fh9g12/HastaArduino/docs/README.md

# HastaArduino

Bench- and wind-tunnel instrumentation for a free-to-pitch / control-surface aircraft model: firmware for one board, the **Pimoroni Pico Plus 2** (RP2350B, no on-board radio) with a **Pimoroni RM2 WiFi/BT breakout on its SP/CE connector**, plus the MATLAB package that drives it. Every rig follows one shape: an Arduino sketch exposes an **SCPI-over-TCP instrument interface**; MATLAB drives it, pulls back binary sample data, and plots.

This file is for a future human or agent picking the repo up cold. It describes **architecture, conventions and traps**, not project-by-project detail. The `.ino` header comments and the doc comments on the MATLAB classes are the detailed, kept-current reference; read those for specifics.

> **Read [Rules for agents](#rules-for-agents-and-safety) before running or changing anything.** This code moves real control surfaces and writes state into the user's MATLAB.

## Contents

1. [Quick start (new machine)](#quick-start-new-machine)
2. [Repo layout](#repo-layout)
3. [How the pieces fit](#how-the-pieces-fit)
4. [Firmware](#firmware): HastaDAQ, wire protocol, HastaDrivers, other rigs
5. [MATLAB](#matlab): package map, client, data model, saved state, scripts
6. [Typical test session](#typical-test-session)
7. [Coding conventions](#coding-conventions): firmware and MATLAB
8. [Testing and verification without hardware](#testing-and-verification-without-hardware)
9. [Rules for agents and safety](#rules-for-agents-and-safety)
10. [Gotchas](#gotchas)
11. [Schematics, wiring, library management](#schematics-wiring-and-library-management) (taking them to a PCB layout: [PCB_BRIEF.md](PCB_BRIEF.md) for the main board, [PCB_BRIEF_GAUGE.md](PCB_BRIEF_GAUGE.md) for the strain-gauge board; parts still to choose: [PARTS_TO_SELECT.md](PARTS_TO_SELECT.md))
12. [Open items and unverified assumptions](#open-items-and-unverified-assumptions)

## Quick start (new machine)

1. **WiFi credentials:** copy `HastaDrivers/src/secrets.h.example` to `secrets.h` (gitignored) and fill in `WIFI_SSID` / `WIFI_PASS`.
2. **Toolchain:** run `setup-arduino-deps.ps1` (uses `arduino-cli` and installs exactly what `arduino-deps.txt` pins, into the real Arduino sketchbook, which is under OneDrive here).
3. **Build and flash `HastaDAQ`** with Visual Studio + the Visual Micro extension (the shared `HastaDrivers` include path only exists there), or check that it compiles from a shell, run from the repo root:
   ```
   arduino-cli compile --fqbn rp2040:rp2040:pimoroni_pico_plus_2 --build-property "build.extra_flags=-I<repo>/HastaDrivers/src" --build-property "compiler.cpp.extra_flags=-I<repo>/HastaDrivers/src" HastaDAQ
   ```
   The extra `-I` is needed because plain `arduino-cli` doesn't know about the Visual Micro shared-items project. (Board target: see [open items](#open-items-and-unverified-assumptions).)
4. **Find the board's IP** in the Serial Monitor at boot (`[WiFi] Connected, IP=...`). The scripts hard-code it near the top (`HastaIP` / `boardIP`); edit it there.
5. **MATLAB:** put `matlab/hastadaq` on the path (it holds the `+wt` and `+scripts` packages). The tunnel computer interface (`wt.OHBControl`, `wt.OHBData`) comes from the separate **WtControl toolbox**, which is *not* in this repo and merges into the same `wt` package name.
6. **First-time calibration:** with the model at its zero position, run `scripts.ZeroEncoderRun` once (see [encoder zero](#saved-state-matlab-preferences)).

## Repo layout

```
HastaDAQ/               Flagship firmware for the ORIGINAL board: HastaDAQ.ino + sketch-local headers (ChannelMixer, Sensors, CaptureManager)
HastaDAQ_v2/            Firmware for the REV A board (copy of HastaDAQ + EncoderPorts.h, soft stop, inverted triggers); see the HastaDAQ_v2 section
HastaDrivers/           Shared driver library (Visual Micro "shared items" project); src/ is on every sketch's include path
SbusServoCalibration/   Older rigs, one folder per sketch, folder name == .ino name (Arduino requirement)
EncoderCalibration/
StrainGaugeCalibration/
matlab/hastadaq/        THE MATLAB package for HastaDAQ: +wt/+hasta, +wt/+runNum, +scripts, controlStepResponseTest.m
matlab/common/          MATLAB helpers for the older rigs (TCP connect, binary parsers, FFT/Bode plots)
matlab/sbus|stepper|straingauge/   Per-rig MATLAB scripts for the older rigs
kicad/hastadaq/         KiCad schematic for the main HastaDAQ board (primary electrical reference)
kicad/gaugeboard/       KiCad schematic for the separate strain-gauge board (2 x ADS122C04, own 3.3 V regulator)
kicad/tools/            Bootstrap generators for both schematics (schgen_common.py = shared helpers) and the module-footprint generator
kicad/tools/layout/     Layout, routing, silkscreen and fab-export scripts (export_fab.py is reusable for any board; see its README)
kicad/releases/         Frozen publish.py snapshots; the gauge board's laid-out .kicad_pcb and its PCBWay fab files live here
kicad/README.md         KiCad workflow, tools, gotchas, status and hand-off notes: read this before laying out the next board
wiring/                 WireViz cable-level diagrams (secondary; partly stale, see open items)
                        (gauge-loom.yml is current: the 4-wire loom between the main board and the gauge board)
docs/                   This file
arduino-deps.txt        Pinned core + library versions (source of truth)
setup-arduino-deps.ps1  Installs what arduino-deps.txt pins
HastaArduino.slnx       Visual Studio solution (Visual Micro) referencing the active projects
```

`data/` (captured results) and the Visual Micro build files are **not source**; see [Rules for agents](#rules-for-agents-and-safety).

## How the pieces fit

```
  tunnel computer                         MATLAB (matlab/hastadaq)                       Pico Plus 2 + RM2 (HastaDAQ/)
 +-----------------+   wt.OHBControl    +------------------------------+   TCP :5025   +-----------------------------+
 | OHB server      |<------------------>| scripts.*  (tests, save data)|   SCPI text   | HastaDAQ.ino  SCPI handlers |
 | (force balance, |  external toolbox  | wt.hasta.examples.* (demos)  |<------------->|   setup()/loop(), non-blocking|
 |  incidence,wind)|                    | wt.hasta.DaqClient (handle)  |  UDP stream   | ChannelMixer -> SBUS servos |
 +-----------------+                    | wt.hasta.DaqData/MetaData/...|<--(optional)--| Sensors: MT6835, 2xADS122C04|
                                        | wt.runNum, encoderZero (prefs)|              |          ICM20649 IMU       |
                                        +------------------------------+               | PID, ExcitationGenerator,   |
                                                                                        | TriggerIO, CaptureManager   |
                                                                                        +-----------------------------+
```

* **One instrument, one client.** The board serves one TCP client at a time; a new connection always replaces the old one (last wins).
* **The board is the real-time part; MATLAB is orchestration.** SBUS output, the pitch controller, excitation and capture all run on the board and keep running if MATLAB stalls. MATLAB sets state, triggers, and reads data back.
* **All angles are degrees, centred on 0** (see [servo mapping](#servo-angle-convention)).

## Firmware

### HastaDAQ (flagship)

Five SBUS control surfaces (rudder, 2 elevators, 2 ailerons), an MT6835 pitch encoder with a closed-loop elevator controller, two ADS122C04 ADCs (half-bridge strain gauges) and an ICM20649 IMU on one Qwiic chain, external trigger in/out for syncing with other instruments, SCPI control, and optional continuous UDP streaming.

Every other rig in the repo blocks the whole sketch for a run's duration. HastaDAQ **cannot**: it flies real control surfaces, so SBUS output and the controller must never stop, even mid-capture. It is fully non-blocking: every `loop()` iteration services SCPI, polls the trigger pin, refreshes all sensors, advances the excitation / controller / capture / UDP state machines, and re-sends the SBUS frame. `RUN`/`ARM`/`FIRE` only flip state; they never wait. Use `HastaDAQ.ino` (not the older rigs) as the template for anything with an always-on real-time duty.

`HastaDAQ.ino` is the SCPI handlers plus `setup()`/`loop()`. The logic lives in sketch-local header-only classes included directly (Arduino doesn't auto-build extra `.cpp` files, so header-only was the simple, safe split):

| File | Role |
|---|---|
| `ChannelMixer.h` | `CHANNEL_DEFS[]` (**the one place to rename a servo or move it to another SBUS channel**), per-channel trim / excitation gain / control gain, the `SbusServoBank`, and the `ChanUpdate` struct |
| `Sensors.h` | `SensorHub`: encoder, both ADCs, IMU, all cached and refreshed non-blocking each loop |
| `CaptureManager.h` | `HastaDaqSample` (the 68-byte wire struct), bounded-capture state machine, `UdpStreamer` |

Shared from `HastaDrivers`: `PidController`, `ExcitationGenerator`, `TriggerIO`, `Mt6835Encoder`, `SbusServoBank` and the waveform generators.

**Signal flow, per servo channel, every SBUS frame:**

```
commandedDeg[ch] = trimDeg[ch] + excGain[ch]*excitation(t) + ctrlGain[ch]*controlOutput
```

One shared excitation waveform (sine / 1-cosine / chirp) and one shared PID (error = target - encoder angle) are mixed into each channel by gains in `[-1, +1]`: `0` excludes a channel, equal signs are symmetric, opposite signs differential. The PID runs every loop on its own measured `dt`; there is no separate control rate, just Kp/Ki/Kd. The controller has basic clamped-integration anti-windup (the integral freezes while the output is saturated) and the output is hard-limited to `outLimitDeg`.

**Triggering.** `RUN` = `ARM` (configure a bounded capture) + an immediate internal trigger. `ARM` alone waits for `FIRE` or an edge on the trigger-in pin. Every trigger also pulses trigger-out. Excitation has an **armed vs active** split: `armed` is sticky ("the next trigger should start this"), a trigger turns armed into active after `delayS`, and a bounded excitation (`cycles > 0`) stops itself but **stays armed**, so the next trigger starts it again. Disarm it when done.

#### Servo angle convention

* All angles are **degrees from centre, +/-48.06 deg**. `SbusServoBank` maps them linearly: 1520 us centre = SBUS 1024, 920 / 2120 us = SBUS 64 / 1984 (servos programmed through the Futaba CIU-3 for those end-points).
* Anything commanded past +/-48.06 deg is clamped, and the logged servo angle is the **clamped** value actually sent.
* `chMin` / `chMax` are a per-channel clamp on the raw SBUS count (64..1984), not the angle scale.
* The count-to-microsecond factor (0.625 us per count, Futaba S.BUS convention) is an **unverified assumption**; check that +/-48 deg reaches the servo end-points.

#### Encoder zero

The MT6835 is an **absolute single-turn** encoder, so its raw 0-360 deg reading is the same after every power cycle. The zero the firmware applies is a **software offset held in RAM** (lost on reboot or reflash). It can be described by one number, the raw angle that reads as 0: read it with `ZEROOFFSET?` after `ZERO`, keep it on the PC, and re-apply it with `ZEROOFFSET <deg>` after any restart. Valid only while the encoder and magnet haven't moved relative to the model. Both `ZERO` and `ZEROOFFSET` are refused while the controller is enabled (they would step the PID error).

#### Link handling (WiFi)

* A new SCPI connection **always replaces** the current one; each connection gets `setNoDelay(true)` (replies go out at once) and TCP keepalive (`keepAlive(5, 2, 3)`: intended to notice a dead peer in ~11 s and to stop idle gaps letting the link go quiet). That the keepalive actually takes effect in this build has **not been verified on hardware**.
* The WiFi link is **watched and logged only**; there is deliberately **no automatic re-join**, because `WiFi.begin` blocks and would pause SBUS for seconds. Do not add a blocking reconnect to `loop()`.
* `SYS?` reports uptime (a small value means it rebooted), reset reason (e.g. brownout), WiFi state and RSSI, free heap, connect/disconnect/WiFi-drop counts and the longest `loop()` since last asked. The Serial Monitor logs timestamped connects, disconnects and WiFi changes. These exist to diagnose intermittent "no reply" problems; see [open items](#open-items-and-unverified-assumptions).
* The core already disables WiFi low-power mode after `begin()`, so power-save is not the cause of latency spikes.

### Wire protocol (HastaDAQ)

Newline-terminated ASCII over TCP port 5025; replies end in CRLF (trim them). Setters apply only the fields you send and keep everything else. **Commands that carry a JSON body read it as a second raw line** (the parser splits on commas, so JSON can't be a normal SCPI parameter). Replies are `OK`, a value/JSON line, or `ERR <reason>`.

| Command | Body / reply |
|---|---|
| `*IDN?` | identification string |
| `CHANCONFIG` | JSON object **or array of objects**: `channel` (index 0-4 or a `CHANNEL_DEFS` name), `excGain`, `ctrlGain` (-1..1), `trimDeg`, `chMin`, `chMax`. An array is validated first and then applied **together**, so surfaces start moving in the same SBUS frame; older firmware only accepts one object |
| `CHANCONFIG? <ch>` | JSON of that channel |
| `EXCITE` / `EXCITE?` | `type` (`sine`/`cosine`/`chirp`/`step`/`random`/`stepseq`), `freqHz`, `f0`, `f1`, `periodS`, `amplitudeDeg`, `cycles` (0 = until disarmed), `delayS`, `startOffsetS` + `durationS` (`random`: the slice of the stored turbulence record to play, must fit in 59.98 s else `ERR`), `dwells` (`stepseq`: up to 16 multiples of `periodS`), `armed`; the query adds read-only `active` |
| `CTRLCONFIG` / `CTRLCONFIG?` | `kp`, `ki`, `kd`, `targetDeg`, `outLimitDeg`, `enabled` |
| `RUN` / `ARM` | `{durationS, sampleHz}`; `RUN` arms and triggers at once and replies `OK` immediately |
| `FIRE` | software trigger (errors if nothing armed) |
| `STATUS?` | `ARMED` / `CAPTURING <elapsed>/<duration>` / `DONE <n>` (`DONE` is also the idle state) |
| `DATA?` | header line `BIN <n> <bytesPerSample>` then `n` raw little-endian `HastaDaqSample` records |
| `ENCODER?` | current encoder angle (deg), plain number |
| `ZERO` | software-zero the encoder here |
| `ZEROOFFSET?` / `ZEROOFFSET <deg>` | read / re-apply the saved raw-angle zero |
| `SYS?` | link-health JSON (above) |
| `TRIGCONFIG` / `?` | `outPulseMs`, `inEdge` (`rising`/`falling`) |
| `UDPCONFIG` / `?` | `ip`, `port`, `rateHz`, `enabled` (continuous stream, same record layout as `DATA?`) |

**Sample layout (68 bytes, `static_assert`ed):** `uint32 t_us`, then 16 floats: ADC1 mV, ADC2 mV, encoder deg, accel x/y/z, gyro x/y/z, excitation deg, controller output deg (11 floats), then **5 servo angles in `CHANNEL_DEFS` order** (rudder, elev R, elev L, ail R, ail L). `wt.hasta.DaqData.FromBytes` and `wt.hasta.HDCh` mirror this; change all three together.

Registered commands must stay below `SCPI_MAX_COMMANDS` (32; 21 are registered now) and the library needs `SCPI_HASH_TYPE uint16_t` (see [gotchas](#gotchas)).

### HastaDAQ_v2 (REV A board)

`HastaDAQ_v2/` is a copy of `HastaDAQ/` updated for the REV A schematic, kept as a separate Visual Micro project (own `.vcxproj`, in the solution) so the original board and firmware stay untouched; it shares `HastaDrivers`. The drivers were only extended backward-compatibly (the original sketch still compiles, checked). It **compiles** (arduino-cli, `rp2040:rp2040:pimoroni_pico_plus_2w`: 407 KB flash, RAM 60 %), but **nothing here has run on hardware yet**.

What differs from `HastaDAQ`:

* **Encoders:** five ports. ENC1..ENC3 are SPI ports on one shared SPI1 (SCK GP10, MOSI GP11, MISO GP12; CS GP13 / GP9 / GP8), each an MT6835, an RLS Orbis (`orbis`, or `orbis_mt` for the multi-turn part) or empty (the owner's rig: ENC1 and ENC2 MT6835, ENC3 Orbis). ENC4 and ENC5 are the two **SSI** ports (SSI1, SSI2) for RLS RM08 encoders (`rm08`), read together by one PIO state machine (`Rm08Ssi.h`): one shared clock on GP17 and the two data lines on GP18 / GP19, sampled on the same clock edge, at 100 Hz or more with no CPU cost in the loop. `EncoderPorts.h` owns all five: ports are polled every 1 ms, not every loop pass; empty ports are never read and report NaN. The boot default is `ENC_DEFAULT_TYPES` in `EncoderPorts.h` (ENC1 = MT6835, ENC2/ENC3 empty so a missing device on a floating MISO is never read, ENC4/ENC5 = RM08, whose frame check rejects an unplugged line); change it, or send `ENCCONFIG` after boot. **ENC1 is still the control encoder.**
* **Soft stop (GP16):** a normally-closed loop to GND through the cable (`SOFTSTOP+` / `SOFTSTOP-`). Loop open, or cable cut, reads high = STOP: the excitation is halted and kept disarmed (an `EXCITE armed:true` or an external trigger cannot start it), while trim, the control loop, SBUS and any capture keep running. The input starts in STOP at boot and needs the loop closed for 50 ms before a manoeuvre can start; `SOFTSTOPCONFIG {"enabled":false}` ignores it for a bench rig with no loop fitted. `ABORT` does the same halt-and-disarm from software.
* **Triggers:** TRIG_IN is an opto (the GPIO falls when the cable goes high) and TRIG_OUT an open-collector NPN (GPIO high = line low). `TriggerIO` inverts both, so `TRIGCONFIG {"inEdge":"rising"}` still means a rising CABLE edge and the output is still a positive pulse on the cable. The trigger-out pin floats (line released, so pulled HIGH) until `begin()` runs, which is why it is the first thing in `setup()`; expect a short high level on the cable at power-up.
* **New SCPI commands:** `ENCODERS?`, `ENCCONFIG`, `SOFTSTOP?`, `SOFTSTOPCONFIG`, `ABORT`; `ENCODER?`, `ZERO`, `ZEROOFFSET?` and `ZEROOFFSET` take an optional port 1-5 (default ENC1). Documented in the sketch header.
* **Wire format:** `HastaDaqSample` gains four floats appended after the servo angles (`encExtraDeg[4]` = ENC2..ENC5, NaN when not fitted; ENC4/ENC5 are the SSI ports): **84 bytes** per sample with 5 channels, vs 68 for the original board (it was 80 bytes with three extras before the SSI ports were added). `wt.hasta.DaqData.FromBytes` accepts 68 or 84 (extras land in `EncoderExtraDeg`; the original layout parses exactly as before). **That MATLAB change is untested (no MATLAB here).** `*IDN?` reports `HastaDAQ-v2`.

To build with arduino-cli (the Visual Micro project needs the board selected once and a first Build to repopulate IntelliSense paths): `arduino-cli compile --fqbn rp2040:rp2040:pimoroni_pico_plus_2w --libraries <sketchbook libraries dir> --build-property "compiler.cpp.extra_flags=-I<repo>/HastaDrivers/src" HastaDAQ_v2`.

Bench checks still to do with the new board: the RM08 SSI ports (scope on `SSI_CLK` / `SSI1_DATA` first; then `ENCODERS?` should show ports 4 and 5 `valid:true` and an angle that follows the shaft; if the reading is garbage check the clock edge/idle level and try a 1 MHz or slower `SSI_CLOCK_HZ` in `EncoderPorts.h`), the Orbis SPI mode and a valid read (`ENCODERS?` shows `valid` and a sensible `deg`; try `SPI_MODE3` in `OrbisEncoder.h` if not), two devices on the bus at once, the soft-stop (open the loop mid-excitation), the trigger polarity both ways, and the power-up glitch on TRIG_OUT.

### HastaDrivers (shared library)

A Visual Micro **shared items** project (`HastaDrivers.vcxitems`) imported by every sketch's `.vcxproj`. Its `src/` is on every sketch's include path, so `#include <X.h>` resolves there, and so does `#include "secrets.h"`. Header-only and deliberately minimal (an early SimpleFOC-based encoder driver made IntelliSense and compiles painfully slow; see `Mt6835Encoder.h`).

* **Mt6835Encoder.h**: raw-SPI MT6835, continuous unwrapped angle, software zero, the saved-zero pair (`zeroOffsetRawDegrees` / `setZeroOffsetRawDegrees`), and datasheet-confirmed calibration-status / auto-calibration access. `begin(false)` skips the SPI1 start/remap for sharing the bus with other devices.
* **OrbisEncoder.h**: RLS Orbis (SPI variant) position + status over the shared SPI1 (frame, timing and caveats in its header comment; mode 1 is inferred, CRC unchecked, not yet run on hardware). Same zero/unwrap API as `Mt6835Encoder`.
* **Rm08Ssi.h** (+ `Rm08Ssi.pio`, the PIO program, and its generated `Rm08Ssi.pio.h`; regenerate with the core's `pioasm`, command in the `.pio` header): reads **two RLS RM08 SSI encoders** (12-bit, SC output through an inline LDB02) with one PIO state machine: one shared clock out and two data lines on consecutive GPIOs, both sampled on the same clock edge, clock idle high, 32 clocks at 500 kHz with a 64 us idle gap (the encoder's monoflop time is 12.5-20.5 us), no CPU time and no sensitivity to WiFi/SBUS jitter. Frame as inferred from the owner's working ESP32 sketch (SPI mode 2): bit 0 = 1, 12 position bits, an error bit that must be 0, then the position repeated; accepted only if all three agree (an unplugged, pulled-up line reads all ones and is rejected). Same zero/unwrap API as the other encoders, per channel. **Not yet run on hardware**: only assembled, compiled, and checked off-target (`checkFrame` and the bit unpacking agree with the ESP32 decoder on 40,000 random and malformed frames). Frame layout and clock edge are assumed, not read from a timing diagram.
* **SoftStop.h**: debounced soft-stop input (normally-closed loop to GND; open = stop; starts in STOP until the loop is seen closed; `setEnabled(false)` bench mode).
* **SbusServoBank.h**: N servos on one SBUS frame, centred-degree interface and the 64/1024/1984 mapping above. Use it (not `SbusServo.h`) whenever more than one servo is driven.
* **SbusServo.h**: single-channel SBUS output with the RP2040 UART-inversion workaround; used by `SbusServoCalibration`.
* **PidController.h**: live-tunable PID, `update(measurement)` tracks its own `dt`; `reset()` clears the timestamp too (no stale `dt` across enable/disable). `reset()` keeps the gains.
* **ExcitationGenerator.h**: sine / 1-cosine / chirp / step / random / stepseq with `cycles`, `delayS` and the armed/active split. `random` plays `durationS` seconds of `TurbulenceProfile.h` (one 60 s von Karman position record at 50 Hz, peak 1, generated by `matlab/hastadaq/tools/exportTurbulenceProfile.m` from the GustVaneControl generator; linear interpolation, quintic taper over the first/last 10%, auto-stops). `stepseq` holds `-amplitudeDeg` from the trigger for `delayS`, then alternates `+/-amplitudeDeg` for `dwells[i]*periodS` each, then 0 and stops (the stepped chirp). `LinearChirp.h`, `OneMinusCosine.h`, `SweepWave.h` are the generators underneath.
* **TriggerIO.h**: trigger-in (interrupt, configurable edge) and trigger-out (non-blocking pulse). Single instance only. Optional `begin(in, out, inInverted, outInverted, externalPullUp)` for boards that invert the pin (opto in, NPN out): all edges and pulses stay in terms of the cable signal. The defaults reproduce the original wiring.
* **StepperDriver.h**: STEP/DIR stepper, free-run or position-tracking.
* **Controlstate.h/.cpp**: scaffold for a possible dual-core control loop; not used by any active sketch.
* **secrets.h / secrets.h.example**: gitignored WiFi credentials.

### Older rigs

`SbusServoCalibration` (SBUS servo characterisation against an encoder on the output shaft), `EncoderCalibration` (NEMA17 + MT6835 linearity / frequency response), `StrainGaugeCalibration` (ADS122C04 + half bridge). These are the simple blocking-capture pattern (see [firmware conventions](#firmware-1)). Their MATLAB lives in `matlab/common` and `matlab/{sbus,stepper,straingauge}` and uses raw `tcpclient` calls plus per-rig binary parsers; it is **not** part of the `wt.hasta` package. Servo actuation in the repo is SBUS-only; the earlier PWM path and prototypes were removed (see git history).

## MATLAB

The hands-on guide for this package (cookbook, API reference, script template, troubleshooting) is [`matlab/hastadaq/docs/README.md`](../matlab/hastadaq/docs/README.md); this section is the architecture summary.

Everything for HastaDAQ lives in `matlab/hastadaq`, organised as **packages** so it can later be lifted into the `wt` repo wholesale (`+wt/+hasta`, `+wt/+runNum`). Always call things by their **fully qualified name** (`wt.hasta.DaqClient`), in scripts and in the classes themselves; MATLAB packages do not see their siblings by bare name.

```
matlab/hastadaq/
  +wt/+hasta/
    DaqClient.m        the only code that talks to the board (handle class)
    DaqData.m          one capture: a property per signal, per servo angle; mean(), ToTable()
    HDCh.m             enum of the five surfaces (order = servo-angle columns = CHANNEL_DEFS order)
    MetaData.m         per-test-point context (run/test number, test type, ZeroRun, ModelConfig, Parameters)
    ModelConfig.m      model setup (tank type / diameter / fuel mass)
    getLastZeroRun.m   newest zero-run file in data/
    +encoderZero/      get / set / info : the saved encoder zero (a MATLAB preference)
    +examples/         runnable demos, one idea each (see below)
    +testtype/         test-point classes: BaseTestType, Steady, Datum, Zero, ExcitationTest, Sine, Cosine, Chirp, Step
    setupTestEnvironment.m  [hd,ohb,pxi] with the fixed addresses / card as defaults
    ControlSettings.m  controller settings (value class): apply, hold
    runTests.m, TestSession.m  run an array of test points, record, save
  +wt/+runNum/         get / set / increment : the run number (a MATLAB preference)
  +scripts/            the real tunnel tests: ZeroEncoderRun, ZeroRun, AoASweep, AoA_V_Sweep, FreePitchSine, FreePitchChirp, FreePitchCosine, FreePitchStep, FreePitchMixed
  +wt/+pxi/            optional PXI six-axis force sensor: ForceDaq, ForceData, loadCalibration (private/FT78552.cal)
  controlStepResponseTest.m   standalone controller step-response tuning script
  tools/exportTurbulenceProfile.m   bakes the turbulence record into the firmware (HastaDrivers/src/TurbulenceProfile.h)
```

### DaqClient

Creating one: `hd = wt.hasta.DaqClient(ip)` (port 5025, 20 s timeout). Scripts reuse a live `hd` (`if ~exist("hd","var") || ~isvalid(hd)`) because the board serves one client at a time. Public methods, by purpose:

| Group | Methods |
|---|---|
| Connection / health | `identify`, `ping`, `getHealth` (+ static `formatHealth`), properties `TimeoutS`, `MaxAttempts`, `ReconnectCount`, `LastHealth` |
| Surfaces | `setAngle` (fixed angle, zeroes the gains), `setSteady` (disarm excitation + `setAngle`), `setMix` (trim / excGain / ctrlGain, several surfaces in **one** command), `setChannel` / `getChannel` (one channel, also `chMin`/`chMax`) |
| Excitation | `setExcitation`, `getExcitation`, `disarmExcitation` |
| Controller | `setControl`, `enableControl`, `disableControl`, `getControl` |
| Free-to-pitch | `holdPitch` (controller holds a pitch and waits to settle), `openLoopAtEquilibrium` (controller off **without a jolt**, elevators keep their averaged equilibrium angles) |
| Capture | `run`, `arm`, `fire`, `getStatus`, `waitForDone`, `readData`, `capture` (= run + wait + read) |
| Encoder | `getEncoderDeg`, `zeroEncoder`, `getEncoderZeroOffset`, `setEncoderZeroOffset` |
| Triggers / UDP | `setTrigger`/`getTrigger`, `setUdp`/`getUdp` (UDP only configured, not received) |

Behaviour to know:

* **Transport robustness.** Each command goes out as **one write** (command line + JSON body together; two small writes stall on Nagle). A missing reply is retried up to `MaxAttempts` (5) times, reconnecting each time, with `TimeoutS` (20 s) per try; the final error is `DaqClient:noReply`. Queries and the settings commands are simply resent; **`RUN` and `FIRE` are never blindly resent**: after a lost reply the client asks `STATUS?` first and only resends if the board isn't already capturing (`FIRE` refuses to guess if the board is idle: `DaqClient:unverified`). A board `ERR` is reported immediately and never retried.
* **Controller settings are kept.** `setControl` remembers the last Kp/Ki/Kd/target/limit; `enableControl` re-sends them with the enable, and warns (then restores them) if the board's values differ, e.g. after a restart.
* **Synchronised moves.** Multi-surface changes use the array form of `CHANCONFIG`. Against old firmware this falls back to one command per surface with a one-time warning.
* **`setAngle`/`setSteady` zero `excGain` and `ctrlGain`** on the surfaces they move, so nothing else is added on top of the requested angle. `holdPitch` sets the mix back up for closed loop.
* **Errors** use identifiers `DaqClient:<camelCase>` (`noReply`, `boardError`, `badReply`, `badMix`, `badAngle`, ...).
* The firmware must be recent for some calls (`ZEROOFFSET`, `SYS?`, array `CHANCONFIG`); an older board simply doesn't answer an unknown command, which looks like a timeout.

### Data model

* **`DaqData`** is a value class; one object per capture, one row per sample. Properties: `Datetime`, `TimeMs`, `Adc1Mv`, `Adc2Mv`, `EncoderDeg`, `Accel`, `Gyro` (N x 3), `ExcitationDeg`, `ControlOutputDeg`, and **one property per servo: `RUDDER_Angle`, `ELEV_R_Angle`, `ELEV_L_Angle`, `AIL_R_Angle`, `AIL_L_Angle`**; dependent `Time` (s from first sample), `NumSamples`, `ServoAngles` (N x 5, `HDCh` order). `data.Angle(wt.hasta.HDCh.ElevL)` selects one. `data.mean()` condenses to one row (explicit, never automatic: `readData` always returns the full series).
* **`MetaData`** (one per test point): `RunNumber`, `TestNumber` (0-based), `TestType` (`Steady|Datum|Sine|Cosine|Chirp|Step|Random|SteppedChirp|Zero`), `Filename`, `DatumTest` (the `TestNumber` of the Datum a dynamic point is referenced to, else NaN), `ZeroRun` (file of the latest zero run, for zeroing the force sensors in post-processing; nothing is subtracted at acquisition), `ModelConfig`, free-form `Parameters` struct, `Notes`. Constructed with `Name=Value`; `TestType`/`TankType` are validated strings (`mustBeMember`), not enums.
* **Saved files:** `data/Run<NN>_<Test>_<yyyyMMdd_HHmmss>.mat` containing three **parallel arrays of equal length** with one element per test point: `hdData` (`DaqData`), `ohbData` (`wt.OHBData`), `meta` (`MetaData`). Steady-type points (`Steady`, `Datum`, `Zero`) store the averaged `DaqData` and the OHB sample; dynamic points store the full series and a NaN OHB placeholder; `pxiData` (`wt.pxi.ForceData`) is a fourth array, placeholders when the force sensor is off. On any error a `..._partial.mat` with the same variables is written before the error is re-thrown. `data/` is relative to the current folder and is not committed.

### Saved state (MATLAB preferences)

State that must outlive a MATLAB session lives in MATLAB **preferences**, group `wt`; it is per user and per install, not in the repo, and not shared between PCs.

| Preference | Access | Meaning |
|---|---|---|
| `wt/runNumber` | `wt.runNum.get / set / increment` | run counter; every recording script calls `increment` (saves current+1 and returns it) when it starts; unset reads as 1 |
| `wt/encoderZero` | `wt.hasta.encoderZero.get / set / info` | struct `{OffsetDeg, SavedAt}`; `get` errors if never saved |

The board forgets its encoder zero when it restarts, so the test scripts **send the saved offset at start-up** instead of zeroing again. Create it with `scripts.ZeroEncoderRun` (model at zero, flag set), or, if known, `wt.hasta.encoderZero.set(x)`.

### Scripts and examples

* **`scripts.*`** are the tests you run at the tunnel: they need the OHB connection, and save results. They are short: a list of **test points**, then `wt.hasta.setupTestEnvironment` and `wt.hasta.runTests` (see [Test points](#test-points-wthastatesttype)).

  | Script | Does |
  |---|---|
  | `ZeroEncoderRun` | zero the encoder at the model's zero, save the offset (no data recorded) |
  | `ZeroRun` | wind **off**: a `Zero` point (incidence 0, elevators 0, wind checked off, encoder checked ~0) saved as a run |
  | `AoASweep`, `AoA_V_Sweep` | `Steady` points over AoA, elevator angle (and tunnel speed) |
  | `FreePitchSine`, `FreePitchChirp`, `FreePitchCosine`, `FreePitchStep` | model free to pitch: the matching dynamic point type per frequency / amplitude / period / delta, each from a Datum at the target pitch |
  | `FreePitchMixed` | one run mixing sine, chirp, cosine and step points: the template for combining test types |

  All of them take `UsePxi` / `UseCamera` for the force sensor and camera.

* **`wt.hasta.examples.*`** are demos that need only the Hasta DAQ (no tunnel computer, nothing saved): `zero`, `moveServos`, `steady`, `chirp`, `sinewave`, `setupControl`, `pitchTest`, `freePitchChirp`, `freePitchSine`, `freePitchStep`, `freePitchCosine`, plus `testPxi` (checks the PXI card, the trigger loopback and that the PXI's edge starts the board; run it before any `USE_PXI`). They deliberately stay explicit, one idea each, and are the best place to learn the API. The free-pitch ones include the response analysis (FFT ratio for the chirp, least-squares sine fit, step t63/overshoot/settling, cosine peak excursion). Run them as `wt.hasta.examples.chirp`.
* Every script that records data calls `wt.runNum.increment()` (inside `runTests`) when it starts, so each script run gets its own run number. A sweep therefore never shares a number with the `ZeroRun` before it, and the "last zero run is from a different run number" warning it prints is expected.

### Test points (`wt.hasta.testtype`)

A test script is a **heterogeneous array of test points** passed to `wt.hasta.runTests`; mixing types needs no new code.

```matlab
[hd, ohb, pxi] = wt.hasta.setupTestEnvironment(UsePxi=true, UseCamera=true);   % IPs, NI card, sample rate are defaults here
points = [ wt.hasta.testtype.Sine(PitchDeg=5, FreqHz=0.5, Cycles=6)
           wt.hasta.testtype.Chirp(PitchDeg=5, F1Hz=1.5)
           wt.hasta.testtype.Steady(IncidenceDeg=8, ElevatorDeg=-5) ];
results = wt.hasta.runTests(points, Hd=hd, Ohb=ohb, Pxi=pxi, Name="MyRun", ConfirmedAreaClear=true, ...
    Control=wt.hasta.ControlSettings(Kp=0.2));            % defaults: Kp 0.1, Ki 0.2, Kd 0.05, limit 20, CtrlGain -1, tolerance 0.2
```

* **`BaseTestType`** (abstract, `matlab.mixin.Heterogeneous`) has the **condition** every point shares (`IncidenceDeg`, `ElevatorDeg`, `SpeedMs`, `PitchDeg`; NaN = leave alone; `PitchDeg` set means free to pitch with the controller holding it) plus `Camera` and `ForceDatum`. Subclasses: `Steady`, `Datum`, `Zero`, and the dynamic `Sine`, `Cosine`, `Chirp`, `Random` (a slice of the stored turbulence record), `SteppedChirp` (via `ExcitationTest`) and `Step`. A new type is one new class providing `typeName`, `describe` and `run(obj, session)`.
* **`runTests`** creates a `TestSession` (handle: connections, control settings, data so far, current condition, datum) and for each point: `precheck`, bring the rig to the condition (only what differs from the last point), take a **Datum** if the point is dynamic and none is newer than `DatumMaxAgeS` (default 60 s) for that condition (or `ForceDatum` is set), `run`, store the result. It prints the plan and progress with ETA, saves `hdData/ohbData/meta/pxiData`, writes a `_partial` file and calls the point's `recover` (disarm, controller back on) if anything fails, and refuses to run motion points unless `ConfirmedAreaClear=true`.
* **The OHB only returns averages**, so it is sampled only for steady-type points (`Steady`, `Datum`, `Zero`). Dynamic points store a NaN `wt.OHBData` placeholder, and `meta.DatumTest` is the `TestNumber` of the Datum they belong to (the datum's equilibrium is also what the free-pitch dynamic tests switch to open loop from).
* **`wt.hasta.ControlSettings`** (value class) holds the controller settings (`apply(hd)`, `hold(hd, pitchDeg)`); `wt.hasta.setupTestEnvironment` returns `[hd, ohb, pxi]` (only those asked for are connected; connections are kept between calls, `clear functions` forgets them) and sends the saved encoder zero.

## Typical test session

1. Wind **off**, model at its zero position: `scripts.ZeroEncoderRun` (once, or after the encoder / magnet is disturbed).
2. Wind off: `scripts.ZeroRun` (the force-sensor zero for this run).
3. Wind on, then `scripts.AoASweep` / `AoA_V_Sweep` / `FreePitchSine` / `FreePitchChirp` / `FreePitchCosine` / `FreePitchStep` / `FreePitchMixed`. Results are saved to `data/`.
4. The recording scripts increment the run number themselves when they start; use `wt.runNum.set(n)` to correct it if it gets out of step.
5. If MATLAB complains about an unrecognised property after a code update: `clear functions` (connections are kept inside `setupTestEnvironment`; also `clear classes` if needed).

## Coding conventions

### Firmware

Every active WiFi rig follows one shape **except HastaDAQ** (non-blocking, above). For a simple blocking-capture rig copy `StrainGaugeCalibration.ino` or `EncoderCalibration.ino`; for anything that must keep running during a capture copy `HastaDAQ.ino`.

* **SCPI-over-TCP**, port 5025, `Vrekrer_scpi_parser`, flat command names. **Two-line JSON** for structured parameters (second raw line via `interface.readStringUntil('\n')`).
* **`RUN` / `STATUS?` / `DATA?` binary capture**: logging into a fixed sample buffer, replying with an ASCII `BIN <n> <bytes>` header and raw packed records. Binary, not CSV (the ASCII formatting was the slow part). Every sample struct gets a `static_assert(sizeof(...) == N)`.
* **`CYW43_PINS_SPCE` pin table** plus `cyw43_set_pins_wl(...)` as the **first line of `setup()`** (the RM2 is on the SP/CE connector, GP32-GP35).
* **Bounded `while (!Serial)`** (3 s), never indefinite: WiFi + SCPI must come up with no serial monitor open.
* **Always `#define SCPI_HASH_TYPE uint16_t`** (and `SCPI_MAX_COMMANDS 32`) before including the parser.
* **Types used in function signatures go in a header, not the `.ino`.** The Arduino preprocessor inserts function prototypes *above* any struct defined in the `.ino`, so a signature using it fails to compile (`ChanUpdate` lives in `ChannelMixer.h` for this reason).
* **Never block in HastaDAQ's `loop()`**: no `delay()`, no blocking WiFi re-join, bounded stream reads. Anything slow becomes a state machine advanced a step per iteration.
* **Comments explain why.** Long header comments at the top of each file state the design reasoning, units and hardware assumptions; keep them current when behaviour changes (they are the detailed reference this README points to).
* Strings in `F("...")`. Naming: SCPI command handlers are `PascalCase` (`SetChanConfig`, `GetData`), other functions and variables `camelCase`, types `PascalCase`, constants `UPPER_CASE`.

### MATLAB

* **Packages and names.** Fully qualify every reference (`wt.hasta.HDCh.ElevL`). A `classdef` file uses its own bare name only in the `classdef` line and constructor. Class and file names are `PascalCase`; functions and methods `camelCase`; script parameters near the top are `UPPER_SNAKE_CASE` in the examples and `PascalCase` in the tunnel scripts (match the file you are editing). Units go in names: `...Deg`, `...Hz`, `...S`, `...Mv`, `..._ms` for struct fields.
* **Angles** are degrees centred on 0 everywhere in MATLAB too.
* **Classes.** Hardware connections are `handle` classes (`DaqClient`); data and configuration are plain **value classes** (`DaqData`, `MetaData`, `ModelConfig`) so a saved instance is just data. Validate with property validators (`mustBeMember`) rather than enum classes for small closed sets (`TestType`, `TankType`); use an enum only where the member also carries data (`HDCh`).
* **Arguments.** Use `arguments` blocks with `Name=Value` options. For numeric options `NaN` means "omitted, leave unchanged"; for booleans use `[]` as the "omitted" sentinel and convert with `logical(...)` so JSON gets a real `true`/`false` (the firmware ignores `0`/`1` for booleans).
* **Strings** are double-quoted `string`s; build them with `+` and `sprintf`. MATLAB cannot index a literal (`["a","b"](i)`); assign to a variable first.
* **Docs.** First comment line is `%CLASSNAME One-line purpose` (uppercase), then usage examples, then caveats. Anything that moves hardware says so in capitals (`THIS MOVES SURFACES`).
* **Errors** carry an identifier `Class:camelCase` and a message that says what to do next.
* **Tunnel scripts** are thin and functional: header comment (what, prerequisites, safety warning) -> parameters -> build an array of `wt.hasta.testtype` points -> `wt.hasta.setupTestEnvironment` -> `wt.hasta.runTests` (progress with ETA, partial save and `recover` on error, final save, `ConfirmedAreaClear`) -> any wind-down **after** the save. Do not put hardware logic in the script: add it to a test type or to `TestSession`.
* **Examples** stay explicit and follow one skeleton: header comment -> `CONFIRMED_* = false` flag with an `assert` (motion examples) -> parameters -> `wt.hasta.setupTestEnvironment` -> the calls being demonstrated, with progress `fprintf`s -> leave the rig in a stated state. Local functions go at the **end** of a script file.
* **No toolbox dependencies** in the analysis code (plain FFT / least squares, `detrend`, `interp1`), matching the older MATLAB in this repo.
* **Progress output matters.** Long runs print enough that a person can see where they are and what failed.

## Testing and verification without hardware

There is no automated test suite. What is done instead, and what an agent should do:

* **Firmware:** it must compile from the shell (command in [Quick start](#quick-start-new-machine)). That is the only check available without the board.
* **MATLAB static check:** `checkcode` on every changed file (`matlab -batch "checkcode('file.m','-id')"`). Constant `false` safety flags produce "cannot be reached" notes; that is expected.
* **Fake board:** the client and scripts are verified end to end against a small `tcpserver` that speaks the protocol (it must accept one client at a time, like the real board, and can withhold replies to exercise retries). Feed it synthetic data with a known response (e.g. sine gain 0.5, phase -0.5 rad) and check the analysis recovers it. A stand-in `OHBControl` and a copy of `wt.OHBData` are enough to run the tunnel scripts.
* **Mock NI card:** `wt.pxi.ForceDaq` is tested with a stand-in `daq()` function and `MockDaq`/`MockDaqChannel` classes placed first on the path (`readwrite` returns a timetable; when its output goes high it calls a callback standing in for the wire to the board's trigger-in, so the fake board's capture starts on the edge). Needs no NI hardware.
* **Keep tests away from the user's real state:** see the rules below.

## Rules for agents and safety

* **This code moves real control surfaces and a model that may be free to pitch.** Do not run motion scripts or flash firmware unless the user asks. Keep the `CONFIRMED_*` flags `false` by default and never "helpfully" set them. Do not remove the safety `assert`s.
* **Never write to the user's real MATLAB preferences when testing** (`wt/runNumber`, `wt/encoderZero`). A test once overwrote the saved encoder zero with a dummy and the value was lost. Shadow the accessors with fakes in a scratch folder that is first on the path, or use a temporary group. Reading (`wt.runNum.get`, `encoderZero.info`) is fine.
* **`getpref(group, name, default)` creates the preference** when it is missing, so a "read" written that way writes. Check `ispref` first.
* **Don't commit** `data/`, MATLAB autosave `*.asv`, or the Visual Micro build artifacts (`.vcxproj` / `.vcxproj.filters` changes and `__vm/` folders produced by building on this machine). They are machine-generated.
* **Verify anything hardware-safety-relevant against real sources** (datasheets, library source, register maps), not memory. This project has been bitten by guessing (pinouts, calibration procedures) and saved by checking. State what is unverified.
* **Don't change the wire layout in one place only.** Sample struct, `DaqData.FromBytes`, `HDCh` and `CHANNEL_DEFS` move together.
* **Be honest about untested changes.** Say what was run (compile, fake board, `checkcode`) and what was not (the real rig).

## Gotchas

**MATLAB**

* **Stale objects after a class change.** An `hd` created before a property was added keeps the old class and fails with "Unrecognized method, property, or field". `clear functions` (which forgets the connections kept by `setupTestEnvironment`) and `clear classes` if that is not enough. The connection is reused, so this shows up whenever `DaqClient` changes.
* **`readline` on timeout returns empty**, not an error; the client converts that into `DaqClient:noReply` (otherwise it surfaces later as a cryptic `strtrim` error).
* **The board refuses a second client** ("actively refused"); close or `clear` the first (or rely on the replace-old behaviour of current firmware).
* **`onCleanup` is not a reliable restore** when a script errors out; restore state explicitly.
* **Scripts run by package name** (`scripts.AoASweep`, `wt.hasta.examples.chirp`) share the base workspace. `wt.hasta.setupTestEnvironment` keeps the board, OHB and NI-card connections between calls (the board takes one client), so any script can be re-run straight away; `clear functions` closes them.

**Firmware / board**

* **`Vrekrer_scpi_parser` defaults to an 8-bit command hash** and matches purely by hash, so around a dozen commands can silently route to the wrong handler. Always use `SCPI_HASH_TYPE uint16_t`.
* **WiFi needs the CYW43 pin fix** (`CYW43_PINS_SPCE`) before any other hardware touch in `setup()`.
* **`digitalWrite()` resets GPIO pad overrides** (it calls `gpio_set_function()` each time); use `gpio_put()` if an override must stick. `SbusServo.h` uses `SerialUART::setInvertTX/RX()` instead.
* **`SerialUART` numbering:** `Serial1` = UART0, `Serial2` = UART1, and each has its own valid-pin set (GPIO20/21 are UART1-only).
* **Pico Plus 2 stock is RP2350 A2 (erratum RP2350-E9):** a floating input with the internal pull-down on can sit near 2.2 V and read high. `TriggerIO` uses `INPUT_PULLDOWN`; add an external pull-down of 8.2 kOhm or less on trigger-in if it can float.
* **Trigger-in is a 3.3 V input.** RP2350 GPIO 5 V tolerance was *not* confirmed from the datasheet; use a divider (e.g. 2.2 k series, 3.9 k to ground, which also acts as the external pull-down) for a 5 V source.
* **ADS122C04 address jumpers (from Adafruit's Eagle schematic):** ADDR0 and ADDR1 are each pulled to GND by 10 k (default 0x40); the open solder jumpers SJ1/SJ2 tie ADDR0/ADDR1 to VCC, so bridging the ADDR0 jumper should give 0x41 (TI's address table, not re-checked here). The breakout also carries 10 k pull-ups on SDA and SCL (to its VIN) and 10 k on DRDY/RESET, plus 10 uF and 100 nF on VIN and 100 nF on AVDD. Confirm the real address with an I2C scan; `HastaDAQ.ino` scans at boot if the second ADC doesn't answer at the guessed `0x41`.
* **Visual Micro project files are machine-generated** (`IncludePath` blobs, `__vm/`); don't hand-copy between projects. Write a minimal `.vcxproj` and let a real **Build** populate it.
* **The Arduino sketchbook lives under OneDrive**; `setup-arduino-deps.ps1` resolves it via `[Environment]::GetFolderPath("MyDocuments")`. Don't hard-code `Documents`.
* **Duplicate libraries break `arduino-cli lib install`** (e.g. two copies of Adafruit Unified Sensor); remove the extra folder.
* **Many datasheet PDFs carry a permissions-only lock** that readers report as password-protected; `pikepdf.open(path, password='')` then `.save(dst, encryption=False)` strips it (copy-protection with an empty owner password, not a real restriction).

## Schematics, wiring and library management

* **KiCad** (KiCad 10) is the primary electrical reference, laid out for through-hole PCBs (no SMD soldering). There are **two boards**: the main board (`kicad/hastadaq/hastadaq.kicad_sch`) and a strain-gauge board (`kicad/gaugeboard/gaugeboard.kicad_sch`). Connectivity is by net labels; only the shared strain-gauge completion divider (gauge board) is drawn with wires. Rev A of the schematics, as of 2026-10-25:
  * **Status (2026-10-27):** both schematics are complete and ERC-clean and all parts are chosen (`PARTS_TO_SELECT.md`). **The gauge board is laid out, routed and ordered from PCBWay** (as-built layout and files: `PCB_BRIEF_GAUGE.md` sections 0 and 7, `kicad/releases/rev-a/gaugeboard/`). **The main board is laid out, routed and ordered too** (`kicad/releases/rev-a/hastadaq/`; workflow, tools and gotchas: `kicad/README.md`; the brief it was built from is `PCB_BRIEF.md`, section 0 has the decisions). Decisions: no fuse, plain 0.1 in headers, soldered modules, plain test pads. The gauge headers J3/J4 are 2x3 (V V / SIG SIG / GND GND) so two quarter-bridge gauges can be completed into a half bridge in the plug.
  * **Two boards, one loom:** the strain-gauge hardware lives on its own small, reusable board next to the main board, joined by a **4-wire I2C loom** of 0.1 in 1x4 headers on both boards (pin order GND, +5V, SDA, SCL; a keyed plug is fitted when soldering up). **Pin 2 is 5 V, not 3V3**: the loom is deliberately not Qwiic-compatible. The gauge board holds both Adafruit ADS122C04 breakouts, the two half-bridge headers (2x3: V V / SIG SIG / GND GND), the shared 350R completion pair, optional input-filter positions (0R links by default, 100 nF DNP) and its own clean 3.3 V supply: 47 uF + 100 nF on the incoming 5 V (any ferrite bead is part of the loom cable, not on the board), then a Microchip **MCP1700-3302E/TO** TO-92 LDO (pin 1 GND, 2 VIN, 3 VOUT; 250 mA, 2.3-6.0 V in, stable with ceramic, tantalum or aluminium output caps; about 20 mA used) with 10 uF tantalum + 100 nF out. That 3V3 powers both ADCs and excites both bridges (ratiometric `VREF_SUPPLY`), so cable drop and the main board's switching noise do not reach the measurement. A second 1x4 header (J2) on the gauge board is wired in parallel with the loom input (+5V, SDA, SCL pass-through) so another I2C board can be daisy-chained. The ADS122C04 breakouts carry the I2C pull-ups (to the gauge board's 3V3), so SDA/SCL on the loom are 3.3 V logic. The two boards share the footprint library `kicad/hastadaq/HastaDAQ.pretty`.
  * **Power:** 12 V in (the main supply cable, no fuse) -> `+12V` rail -> a Pololu **D42V55F8** (fixed 8.4 V, 5 A) for the `VSERVO` rail (servos, five S-AG300) and a SparkFun **BabyBuck 5V** (AP63357) for `+5V`. BabyBuck **EN is left open**: the AP63357 data sheet (Diodes DS41949 Rev 3-2) says EN may be left floating (an internal 1.5 uA pull-up enables it) or tied to VIN, with EN rated to 35 V and a 1.18 V rising / 1.08 V falling threshold, so open is explicitly supported. SparkFun's module also has an on-board divider (93.1 k from VIN, 22 k to GND, about 2.3 V at 12 V) on EN, so it starts at about 6.2 V in and stops at about 5.7 V; VIN range is 3.8-32 V (35 V absolute max). The module has 2 x 22 uF on 5V; a further 100 uF sits near the Pico and ports. `+5V` feeds the encoder headers' 5V pins and the gauge-board loom directly and the Pico's VSYS through a Schottky (VSYS max 5.5 V). The Pololu pin map (2x6) is from Pololu's dimension drawing and pinout photo, and the BabyBuck pin order from SparkFun's Eagle board file; check both against the silkscreen of the real modules. A 3x6 servo header and 2x4 / 2x6 headers use KiCad's library footprints; the 3x6 is the project's own `HastaDAQ.pretty/PinHeader_3x06_P2.54mm_Vertical` (listed in `fp-lib-table`).
  * **Main supply cable:** one 2x4 header, pins 1-8 row-major: 1 and 8 `VSUPPLY` (12 V), 2 and 7 `VGND`, 3 `TRIG_IN`, 4 `SOFTSTOP+`, 5 `SOFTSTOP-`, 6 `TRIG_OUT`. Laid out so a 180-degree rotated plug still lands supply on supply and ground on ground; the connector is a plain 0.1 in 2x4 header (`PinHeader_2x04`); the owner fits a keyed/shrouded plug at the harness end, which prevents a rotated or reversed mate (there is no board-side reverse-polarity protection, so a wrongly built harness is still unprotected). Two header pins carry the full supply current; the whole system was measured at 1 A or less at 8.4 V, well inside about 3 A per 0.1 in pin.
  * **Soft stop:** `SOFTSTOP-` is GND; `SOFTSTOP+` goes through 1 k to GP16 with a 10 k pull-up to 3V3. A closed loop reads low (run), an open loop or pulled cable reads high (stop the manoeuvre). Fail-safe on a cable break. A 5.1 V zener from GP16 to GND clamps a cable fault to 12 V (the 1 k limits it to about 7 mA) and negative spikes. (A series diode was not used: it would raise the low level toward the input's low threshold.) Firmware: `HastaDAQ_v2`.
  * **Triggers (3.3 V to 24 V):** `TRIG_IN` goes through 1 k (1 W) into a FOD817A (PC817-compatible) opto LED (1N4148 antiparallel, 10 k pull-down on the cable side); the opto transistor pulls GP14 low (10 k pull-up), so the input is inverted. `TRIG_OUT` is an open-collector 2N3904 driven from GP15 (2.2 k base resistor, 10 k base-emitter pull-down), also inverted (GPIO high = line low), with a 1.5 k pull-up chosen by a 1x5 shunt-safe jumper header (J9: 3V3, PU, 5V, PU, 12V) to 3V3, 5V or `+12V`; fit no jumper if the receiver has its own pull-up, and add an external pull-up in the harness for 24 V receivers. The 3V3 position is for 3.3 V-limited inputs such as the OptiTrack eSync 2 high-impedance ports; the 12V position suits current-driven inputs such as the Scanivalve MPS4200 (5-15 V, 6.5 mA). The `TRIG_OUT` transistor is a **2N3904** (Fairchild/onsemi data sheet Rev 1.1.0, TO-92: pin 1 = E, 2 = B, 3 = C; 40 V, 200 mA, VCE(sat) about 0.2 V at 10 mA). It was chosen over a 2N7000 because the 2N7000G data sheet guarantees VGS(th) up to 3.0 V and rDS(on) only at VGS = 4.5 V and 10 V, nothing at 3.3 V, so it would not be guaranteed to pull the line low from a 3.3 V GPIO. The 2.2 k base resistor gives about 1.1 mA of base current for at most 8 mA of collector current (1.5 k pull-up on the 12 V jumper position), so it saturates well. Never fit a 100 R base resistor: it would draw about 26 mA from the GPIO. Confirm the pin order of the real parts (some NPN types, e.g. C945 and C1815, are E-C-B).
  * **Encoders:** three identical 0.1 in 2x4 SPI headers (plain `PinHeader_2x04` for now; use keyed/shrouded plugs, since a rotated plug would put 5V on the device's CS pin) on SPI1 (SCK GP10, MOSI GP11, MISO GP12), pins 1-8 GND, CS, SCK, MOSI, MISO, 3V3, 5V, GND. CS pins GP13, GP9, GP8, each with a 10 k pull-up to 3V3. Intended for two MT6835 (3V3) and one RLS Orbis (5 V supply, 3.3 V logic) but a generic SPI port; each device needs a MISO that tri-states when its CS is high. SPI mode and clock per device are a firmware matter (`HastaDAQ_v2` / `EncoderPorts.h`). The fourth SPI port was removed (2026-10-27) to make room for **two SSI headers** (J6 SSI1, J11 SSI2, 1x4: 3V3, GND, CLK, DATA) for RLS RM08 encoders (SC output, 12-bit, RS422) used through an inline LDB02 line-driver board that the owner fits near the Pico: one shared clock GP17, data GP18 / GP19 (10 k pull-ups). An SSI data line is always driven, so these cannot share the SPI MISO line; a PIO state machine clocks both and samples both data lines on the same edge. Moving the RS422 transceivers onto the board is a possible later revision.
  * **Orbis SPI notes** (RLS Orbis BRD01 data sheet, issue 16, SPI variant; `OrbisEncoder.h` implements this, not yet run on hardware):
    * **Bus sharing:** the Orbis data sheet says NCS high puts MISO in high-Z and that several slaves can share all lines except NCS. The MagnTek MT6835 data sheet (v1.1, Feb 2022, SPI section / Figure 18) says its MISO "always stays Hi-Z when not outputting" and shows Hi-Z between transfers, so both parts release the line when deselected. It also gives: CSN falling edge starts a transfer, SCK idles high, data changes on the falling edge and should be sampled on the rising edge (SPI mode 3, matching `Mt6835Encoder.h`), up to 16 MHz. This is from the data sheets only; not yet measured with two devices on one bus.
    * **SPI mode (inferred):** the timing diagram shows SCK idling low with data shifted out on rising edges, which points to **mode 1** (CPOL 0, CPHA 1: sample on the falling edge). Not stated outright, so verify on the bench. The MT6835 driver uses **mode 3**, so per-device `SPISettings` are needed on the shared bus.
    * **Clock and timing:** max SCK 4 MHz (tCL >= 250 ns). Wait **tS >= 9 us** after NCS low before the first clock (**14 us** for the multiturn "14M" version), and keep NCS high **tP >= 20 us** between frames. NCS low also latches the position, so assert it just before the read.
    * **Frame:** 16 bits of position and status (14-bit position left-aligned in b15:b2, then error and warning bits, **active low**), then optional requested data, then an 8-bit inverted CRC (see the RLS CRCD01 note, not read). Multiturn parts prepend a 16-bit counter (b31:b16). A position-only read is about 24 clocks, so about 35 us at 1 MHz plus the 20 us gap, far inside a 5 ms period at 200 Hz. The first 8 clocks also carry a command byte on MOSI (`v` serial number, `t` temperature, `d` detailed status, `a` signal level, `i` calibration result); with no command needed, hold MOSI low.
    * **Power:** **4.5-5.5 V at about 65 mA** (so the 5V header pin, not 3V3 and not VSYS after the Schottky drop), with 3.3 V LVTTL signals (inputs 5 V tolerant) and a 100-200 ms start-up. Keep SPI leads short; the data sheet asks for short single-ended signals, especially at high clock rates.
    * **Status:** the LED flashes (idle) if the position is not requested at least every 200 ms; polling at 200 Hz keeps it steady.
  * **No fuse (decision):** the board has no fuse; the benchtop supply's current limit is the protection (set it to about 3 A: the whole system was measured at 1 A or less at 8.4 V, about the same at 12 V in; the Pololu is limited to 5 A out, about 3.9 A in at 12 V; the supply header's two pins are good for roughly 3 A each). The BabyBuck and Pololu have their own overcurrent limits. A board run from a battery or a fixed supply would need a fuse or PTC added to the `+12V` input.
  * **Ground and layout guidance (suggestion):** use ONE solid ground plane on each board (a 2-layer board with a ground pour on the bottom layer is enough) and no split planes or separate AGND net: split planes make SPI and I2C return paths worse. With the ADCs moved to the gauge board there is nothing sensitive left on the main board, so separate the noisy and quiet parts by placement and routing: (1) put the supply connector, Pololu and the SBUS headers at one end and run the servo current (`VSERVO` and its return) along the board edge straight between them, so it never passes the Pico or the loom and IMU connectors; (2) put the loom header and the IMU header at the Pico end, away from the Pololu; (3) let the grounds meet near the supply connector. Give 12 V, 8.4 V and their returns wide traces or pours (5 A rail); keep SPI and I2C short and over solid ground. On the gauge board, keep the ADCs, their decoupling and the completion pair close together with matched, short leads, and fit the regulator next to the loom header. Gauge cable: shielded twisted pair, shield to GND at the gauge board only.
  * **Pin types and test points:** schematic pins carry real electrical types, so ERC checks the power rails: `power_in` on supply and ground pins, `power_out` on the Pololu VOUT pad 1 (its twin VOUT pad stays passive, since two power outputs on one net is an ERC error), the BabyBuck 5V and the Pico 3V3, `bidirectional` on Pico GPIOs, `input` on ADC inputs; everything else (connectors, passives) is passive. PWR_FLAGs sit on the nets that are fed through a passive part (`+12V` and `GND` from the connector, `+5V_VSYS` after the Schottky). Checked: deleting a flag makes ERC report "Input Power pin not driven" on the Pololu VIN. TP1 and TP2 are two plain 2.0 mm `GND` test pads (`TestPoint_Pad_D2.0mm`, copper only) for a scope ground clip (one near the supply, one near the Pico). Rails and signals have no test points: probe them at component leads and header pins (C1/C2/C3 for `+12V`/`VSERVO`/`+5V`, D1, Pico pins 36 and 39; on the gauge board, the LDO output cap and the gauge-header V pins). No SBUS pull-down is fitted (not needed in practice).
  * **Sensors:** I2C0 (GP4/GP5) goes to two 1x4 headers on the main board: the **IMU header** J1 and the **gauge-board loom** J2. The ADS122C04s are no longer on the main board. The IMU sits on a separate board connected through J1, a 1x4 header for a Qwiic breakout (GND, 3V3, SDA, SCL left to right along the breakout's top edge, as read off the board; the breakout is 18.8 mm wide x 14.5 mm high with its two Qwiic connectors on the bottom edge; the header can equally be used as four plain wires). The loom J2 is GND, +5V, SDA, SCL (see 'Two boards, one loom'). The bridge input filter was removed (A0 straight to the bridge, optional filter positions on the gauge board; the ADS breakouts carry their own 10 uF + 100 nF on VIN, so no extra ADC decoupling is fitted). One shared pair of 350R completion resistors feeds A1 of both ADCs.
  * **SBUS:** one 3x6 header, six servo plugs, each GND, V (`VSERVO`), SIG (`SBUS`) in the servos' own plug order (V in the middle), all signals in parallel; GP20 and GP21 on the same net.
  * **SBUS IN (pass-through):** J10, a 3-pin header in the servos' plug order (GND, V, SIG) for an RC receiver's SBUS output, so the Pico can act as a pass-through SBUS controller. V is `+5V`, not the 8.4 V servo rail (the Futaba R3008SB, manual FUT05102609, takes 4.8-7.4 V; check any other receiver); SIG goes through 1 k to GP1 (UART0 RX; the SBUS output is on UART1) with a 5.1 V zener clamp to GND and a 10 k pull-down (R14, leave unfitted on the first trial; see the RP2350 E9 note in `docs/PCB_BRIEF.md` section 9). The board is ready; **the pass-through firmware is not written yet** (SBUS in is 100 kbaud 8E2 inverted: `Serial1.setInvertRX(true)`).
  * **WiFi:** the RM2 breakout is off-board, cabled to the Pico Plus 2 SP/CE connector (GP32-GP36), so it is not drawn. A Pico 2 W is pin-compatible for the header GPIOs used here (it has built-in WiFi, 4 MB flash, 520 KB RAM and no PSRAM, so the firmware's `CYW43_PINS_SPCE` setup would be removed and the 200 KB capture buffer's RAM headroom checked); not tried. Swap checklist and caveats:
    * **Firmware:** change the board target from "Pimoroni PicoPlus2W" to "Raspberry Pi Pico 2W" (`rpipico2w`, same `-DPICO_CYW43_SUPPORTED=1 -DCYW43_PIN_WL_DYNAMIC=1` flags in the core's `boards.txt`), and delete the `CYW43_PINS_SPCE` table and the `cyw43_set_pins_wl()` call. Check the sketch fits the 4 MB flash (the Plus 2 has 16 MB). The 3000-sample capture buffer (about 200 KB) is a plain RAM array on both boards, so RAM headroom is unchanged: still 520 KB with WiFi/lwIP on top.
    * **Pins:** every GPIO the schematic uses is a plain header GPIO on both boards (GP1, GP4/5, GP8-GP21). The Pico 2 W's internal wireless pins (GP23, GP24, GP25, GP29) are not used. The IMU and the gauge-board loom are wired on headers, so the Plus 2's Qwiic port is not needed.
    * **3V3 rail and noise:** the Pico Plus 2's 3V3 is an AP7366 linear regulator (600 mA max, Pimoroni schematic). The Pico 2 W's 3V3 comes from an on-board buck-boost switching regulator, and its datasheet recommends keeping the load under 300 mA. The load on the main board's 3V3 is well under that (IMU, encoder 3V3 pins, pull-ups). The strain-gauge bridges and ADCs are no longer on this rail (the gauge board makes its own 3.3 V from `+5V`), so switching ripple matters little for them; it could still reach the IMU or MT6835 supply. The Pico 2 W datasheet lists an SMPS power-save pin (`WL_GPIO1`) that could be forced to PWM mode to reduce ripple; not tried. Re-check IMU and encoder noise after the swap.
    * **Antenna:** the Pico 2 W's antenna is on the board edge and needs a keep-out (no metal, wiring or carbon-fibre over it, per its datasheet), whereas the RM2 breakout can be mounted wherever the radio performs best. Re-check WiFi range in the final enclosure.
    * **Unchecked:** whether the Pico 2 W has the same on-board VBUS-to-VSYS diode as the Plus 2 (the Plus 2's is D2, per its schematic); the Pico 2 W has micro-USB rather than the Plus 2's USB-C.
* **Module footprints** (`kicad/hastadaq/HastaDAQ.pretty`, generated by `kicad/tools/generate_module_footprints.py` from the vendors' own CAD/dimension data; pad numbers match the schematic symbols' pin numbers): `Adafruit_ADS122C04_Breakout` (used on the gauge board; Adafruit EagleCAD board file: two 1x6 headers 12.7 mm apart, 25.4 x 17.78 mm, four 2.5 mm holes; pad order is physical, not numeric), `SparkFun_BabyBuck_5V` (SparkFun Eagle file: 1x4 header, pads bottom to top 5V GND VIN EN; the Eagle file numbers them the other way round, the footprint follows the symbol), `Pololu_D42V55Fx` (Pololu dimension drawing 0J2180 and pinout photo: 25.4 mm square, three 2.18 mm holes, 12 pads in a 2x6 grid, columns VOUT GND GND VIN VRP PG|EN, odd pads inner row, even pads edge row; 6.1 mm tall for the D42V55F8). The **Pico Plus 2 uses KiCad's stock `Module:RaspberryPi_Pico_Common_THT`**: its 40 pads (2.54 mm pitch, rows 17.78 mm apart) match Pimoroni's mechanical diagram (51 x 21 mm, Pico footprint). `Qwiic_Breakout_1x4_Socket` for the IMU header J1 on the main board (pads GND 3V3 SDA SCL, 2.54 mm): the Pi Hut Qwiic breakout 106676's 18.77 x 14.53 x 1.6 mm outline and 3D model come from the supplied STEP (`HastaDAQ.3dshapes/QWIIC_Breakout_106676.step`, header row 2.27 mm below the board's top edge, two Qwiic connectors on the bottom edge). The model is drawn lying flat on an assumed 8.5 mm female socket (`QWIIC_Z` in the generator script) and is only a visual/fit check: the courtyard covers just the socket row, and the footprint is equally fine for four plain wires. Nothing else on the module list is left to verify except the unverified items in the open-items section below.
* `kicad/tools/generate_hastadaq_sch.py` (main board) and `kicad/tools/generate_gauge_sch.py` (gauge board), both built on `kicad/tools/schgen_common.py`, are the **source of truth for the schematics today**: every edit since the first draft was made in the generators and the `.kicad_sch`, `.kicad_sym`, `HastaDAQ.pretty/PinHeader_3x06...kicad_mod` and `fp-lib-table` files are their output. **If you start editing a schematic in KiCad (or lay out its PCB), treat that `.kicad_sch` as the source and stop re-running its generator over it** (it overwrites and reassigns references). Symbols are generic blocks; real footprints are named; the ADS122C04, BabyBuck, Pololu and Qwiic-breakout footprints are in `HastaDAQ.pretty` (see the module-footprints bullet), the Pico uses KiCad's stock footprint, and the 2N3904 uses KiCad's `TO-92_Inline`. Headless checks: `kicad-cli sch erc` (0 violations at the last run) / `export pdf` (KiCad is at `C:\Program Files\KiCad\10.0\bin` here or `%LOCALAPPDATA%\Programs\KiCad\10.0\bin`, not on PATH); `kicad-cli sch export pdf` fails with "Failed to create file" if a PDF viewer has the old PDF open.
* **WireViz** (`wiring/*.yml`, rendered alongside) is a secondary cable-level view. Regenerate after wiring changes (`wireviz <file>.yml`, Graphviz on PATH) and look at the image before calling it done.
* **Libraries:** `arduino-deps.txt` is the source of truth for the board core and every library version. Re-run `setup-arduino-deps.ps1` after pulling on a new machine, and update the pinned version there whenever you deliberately bump something.

## Open items and unverified assumptions

The firmware to-do list (what is not written, what needs a first bench session) is kept in [`FIRMWARE_OUTSTANDING.md`](FIRMWARE_OUTSTANDING.md).

* **Board target.** Earlier notes say to build with the **"Pimoroni PicoPlus2W"** target because only it defines `PICO_CYW43_SUPPORTED` / `CYW43_PIN_WL_DYNAMIC`. Shell builds with `pimoroni_pico_plus_2` in core 6.1.0 also compile `HastaDAQ`; which target actually works at runtime has not been re-checked on hardware.
* **SBUS count-to-microsecond factor** (0.625 us/count, 1024 = 1520 us) is assumed, not measured.
* **Intermittent "no reply" from the board** during long runs: cause not yet identified (WiFi dropout, a stall, or a stale connection). `SYS?`, the Serial log and the client's `ReconnectCount` exist to find out; an automatic WiFi re-join and the hardware watchdog were deliberately **not** added (they would interrupt SBUS).
* **Second ADS122C04 address** is expected to be `0x41` (ADDR0 jumper bridged, from Adafruit's schematic and TI's address table) but is not yet confirmed on hardware; the boot-time scan is the fallback.
* **RP2350 5 V tolerance** of the trigger-in pin is unconfirmed; the new board's `TRIG_IN` is an opto stage so the pin only sees 3.3 V; the divider advice above still applies to a bench rig without that stage.
* **Firmware:** `HastaDAQ` (original board) is unchanged. `HastaDAQ_v2` implements the REV A pin map (three SPI encoder ports with Orbis support, two PIO-read RM08 SSI ports, soft stop on GP16, inverted trigger paths) and compiles, but has not run on the new board; the Orbis SPI mode, the soft stop and trigger polarity need a bench check (see its section). Note `ENC_DEFAULT_TYPES` in `EncoderPorts.h` assumes only ENC1 is fitted until you edit it or send `ENCCONFIG`.
* **Unverified hardware assumptions in the schematic:** the Pololu D42V55F8 and BabyBuck pin orders against the real modules' silkscreen (taken from vendor drawings and files), the Orbis logic levels, that two SPI devices sharing MISO really do not disturb each other (both data sheets say Hi-Z when deselected, not yet measured), and whether the 3V3 rail can supply every sensor at once. Review these before ordering boards.
* **Supply voltage:** 12 V nominal, **20 V maximum** (C1 is a 25 V part); no TVS or fuse, since the bench supply's setpoint and current limit protect. Printed on the board next to J8.
* **Stale artefacts:** the WireViz files in `wiring/` predate the channel reorder and the power connector. `kicad/hastadaq/hastadaq.pdf`/`.png` and `kicad/gaugeboard/gaugeboard.pdf`/`.png` match the schematics as of the last export (2026-10-26); re-export after any change.
* **Run numbers are per script run**, not per wind on/off cycle (see [Scripts](#scripts-and-examples)); the zero-run "different run number" warning follows from that. If you want one number per wind cycle, only the first script of the cycle should call `increment()` and the others `get()`.
* **PXI force sensor (`wt.pxi`) is only partly verified on real NI hardware.** The card is the PXIe-6363, `"PXI1Slot4_2"` in `daqlist` (the default everywhere). `wt.hasta.examples.steady` has run with it: the card reads forces and its trigger starts the board. Not yet verified: the gauge channel order (check with a known load, `wt.hasta.examples.testPxi`), the calibrated/tared loads, and the camera pulse. Otherwise checked only against a mock `daq`. Assumed: `ai0`-`ai5` are the six gauges in the calibration file's order, `ai6` loops back `ao0`, `ao0` is wired straight to the Arduino trigger-in (it only swings 0 to 3.3 V, so no divider is needed; the divider advice is for the 5 V digital triggers). Keep the external pull-down on trigger-in so the line reads low whenever the NI output is not driving it (card idle or unpowered). The record is lead-in at 0 V, the trigger at 3.3 V for the record, then 0 V so `ao0` ends at zero. `readwrite` blocks MATLAB, so in PXI mode the free-pitch scripts cannot poll the encoder to abort; the step is armed on the board so one hardware edge starts the PXI record, the Arduino capture and the excitation together. Forces are `Matrix x (gaugeVolts - biasVolts)` (N, N.m); the bias is the mean of the zero run; nothing is subtracted at acquisition. `pxiData` is a fourth parallel array saved by every script that records (`ZeroRun`, `AoASweep`, `AoA_V_Sweep` and the four free-pitch scripts; placeholders when `UsePxi` is false). Steady points (and the `ZeroRun` sample) are stored as the mean over the trigger-high window, whose gauge voltages are the tare (`pxi.Forces(zeroData.Gauges)`); dynamic points keep the whole record. The helpers `wt.pxi.connect` (open the card once, line low, board set to a rising edge), `wt.pxi.record` (arm the board, record both on one edge) and `wt.pxi.plotForces` keep the scripts and the `wt.hasta.examples.*` demos (`USE_PXI`, default false; `steady`, `chirp`, `sinewave`, `pitchTest`, the four `freePitch*`) short; `zero`, `moveServos` and `setupControl` record nothing so have no PXI option. The camera pulse (`ctr1`, ~1 ms) is also untested; every recording script and example has `UseCamera` / `USE_CAMERA` (default false, needs the PXI) next to `UsePxi`, which pulses the camera before and after each record (free-pitch scripts: dynamic records only).
* **`step` excitation** holds the amplitude from `delayS` until disarmed (ignores `periodS`/`cycles`). Compile-checked only; reflash the board to get it (and `ZEROOFFSET`, `SYS?`, array `CHANCONFIG`).
* **`random` and `stepseq` excitations are verified only by compiling the firmware and against a MATLAB fake board that reimplements the same formulas** (no host C++ compiler here). The turbulence record is baked in: to change it run `exportTurbulenceProfile` (needs the GustVaneControl repo for the generator, path in `GustVaneMatlabDir`), rebuild and reflash; the board and `wt.hasta.DaqClient.TurbulenceRecordS` must agree on the 59.98 s length.
* **Test-point framework (`wt.hasta.testtype`, `runTests`) is verified only against the fake board and a mock NI card.** It replaces the earlier per-test scripts, whose behaviour it reproduces (hold, equilibrium, open loop at the equilibrium angles, armed excitation, step with abort); the old scripts had run on the rig, this refactor has not. Behaviour that changed on purpose: the OHB is no longer sampled during time series (a Datum is the reference, retaken after `DatumMaxAgeS` = 60 s); the controller defaults are limit 20 deg and tolerance 0.2 deg (were 15 and 0.25); the camera pulses on steady records too when `UseCamera` is on (`Datum` excepted).
* **Controller sign.** Whether a positive controller output reduces pitch error depends on how the elevators are mounted; `ctrlGain = -1` flips it. If the model runs away from a target, that is the first thing to check.
