fh9g12/HastaArduino/kicad/README.md

# kicad/: schematics, PCB layout and fabrication

Everything electrical for the HastaDAQ REV A hardware. Two boards: the **main board** (`hastadaq/`) and the
**strain-gauge board** (`gaugeboard/`), joined by a 4-wire I2C loom (GND, +5V, SDA, SCL). Design decisions and
the per-board briefs are in `../docs/` (`PCB_BRIEF.md`, `PCB_BRIEF_GAUGE.md`, `PARTS_TO_SELECT.md`); the repo-wide
overview is `../docs/README.md`. This file covers the *workflow*, the *tools* and what a new agent or person
needs to know before laying out the next board.

## Status (2026-10-27)

| Board | Schematic | PCB layout | Fabrication |
|---|---|---|---|
| Gauge board (`gaugeboard/`) | done, ERC clean | **done**, DRC clean (only cosmetic library-mismatch warnings) | **ordered from PCBWay 2026-10-27** (board type, single or panel, chosen by the owner) |
| Main board (`hastadaq/`) | done, ERC clean; **changed 2026-10-27**: ENC4 removed, two RM08 SSI headers added | **done**: placed, routed, DRC clean (`releases/rev-a/hastadaq/hastadaq.kicad_pcb`) | **ordered from PCBWay 2026-10-28** |

**Both boards are in ONE final revision folder, `releases/rev-a/`** (merged 2026-10-28 from the earlier `20261026-2252-rev-a` and
`rev-a` releases, which are gone from the tree; git history has them):

* `releases/rev-a/gaugeboard/`: the gauge board as ordered (2026-10-27), with `gaugeboard.kicad_pcb` and the exact fab files in `fab/`
  (`gaugeboard_gerbers.zip` and `gerbers/`). Its `fp-lib-table` reads the shared footprints from `../hastadaq/HastaDAQ.pretty`.
* `releases/rev-a/hastadaq/`: the main board as ordered (2026-10-28; the schematic has the three SPI encoder ports ENC1-ENC3 and the
  two RM08 SSI headers J6/J11, see `../docs/PCB_BRIEF.md`), with `hastadaq.kicad_pcb` and its fab files in `fab/`.
* `releases/rev-a/docs/`, `wiring/`, `START_HERE.md`, `PUBLISHED.md`: the briefs and loom diagram from the later snapshot.
  `UoBLogo.kicad_mod` is the logo footprint from the gauge-board release.

**Commit this folder**: it is the as-built record. The gauge board's schematic was identical in both snapshots (only the netlist
timestamp differed), so nothing in the ordered gauge board changed in the merge. For a respin, `publish.py` into a NEW folder.

Not verified on hardware yet: the second ADS122C04's address (expected 0x41), I2C over the loom, servo noise
on the gauge board's 3V3. The Gerbers were checked by DRC and by counting holes against the board, not in a
third-party Gerber viewer (the owner looked at PCBWay's preview).

## Folder map

```
hastadaq/                 main board: schematic, symbol library, HastaDAQ.pretty (footprints shared by BOTH boards)
gaugeboard/               gauge board: schematic (working copy; the PCB is in a release folder, see below)
releases/<stamp>-rev-a/   frozen snapshot made by publish.py: schematics, netlists, docs and (once started) the .kicad_pcb
                          files and fab/ output. LAY OUT AND ORDER FROM A RELEASE FOLDER, never from hastadaq/ or gaugeboard/.
tools/                    generators and helpers (see below)
tools/layout/             layout, routing, silkscreen and fab scripts (see tools/layout/README.md)
```

## Workflow

1. **Schematic** (bootstrap only): `py kicad/tools/generate_gauge_sch.py` / `generate_hastadaq_sch.py`. These reassign
   reference designators and UUIDs on every run, so they are only for the time **before** a `.kicad_pcb` exists.
2. **Publish**: `py kicad/tools/publish.py --label rev-a` copies both schematics, libraries, netlists, PDFs and the docs
   into a new `releases/<date-time>-rev-a/` folder (it refuses to run if ERC is not clean). Releases are never overwritten.
3. **Lay out inside the release folder**: open `<board>.kicad_pro`, create `<board>.kicad_pcb`, Tools > Update PCB from
   Schematic. From here on **edit the schematic in KiCad and never re-run a generator over that release**. If the schematic
   needs a big change, delete or abandon the release, fix the generator, and publish a NEW one (this happened once: J3/J4
   became 2x3 headers, the first release was deleted and `20261026-2252-rev-a` replaced it; that one and `20261027-2346-rev-a-ssi` were later merged into `releases/rev-a`).
4. **Fab files**: `py kicad/tools/layout/export_fab.py releases/<rel>/<board>/<board>.kicad_pcb`
   (Gerbers + drill + zip, the PCBWay upload). Close the PCB editor first.
5. Check before ordering: `kicad-cli pcb drc --refill-zones --schematic-parity ...` shows no errors and "0 unconnected pads".

## Tools on this machine

* KiCad 10.0.6 is installed per user at `%LOCALAPPDATA%\Programs\KiCad\10.0\bin\` (not on PATH): `kicad-cli.exe` (ERC, DRC,
  netlist, Gerbers, SVG/3D render) and `python.exe` with the `pcbnew` API. Use that `python.exe` for any script that
  touches a board (the system `py` has no pcbnew).
* **No autorouter ships with KiCad.** The gauge board was routed by script (`tools/layout/gauge_route_as_built.py`).
  See "Faster routing for future boards" below.
* Previews: `kicad-cli pcb render` crops oddly; for a whole-board picture use `kicad-cli pcb export svg` (layers
  `F.Cu,B.Cu,F.SilkS,Edge.Cuts`, `--mode-single --page-size-mode 2`) and rasterise with `pymupdf`.
* `kicad-cli pcb drc --refill-zones` refills zones first; without it the report can use stale pour fills.

## Rules of the road (learned on the gauge board)

* **Check for the PCB editor before writing a board file.** A `~<name>.kicad_pcb.lck` next to the file means it is open.
  Also compare a hash of the file with your last write: the owner edits the layout by hand between your steps (they moved
  parts, resized the board, added a logo). Back the file up first. Never silently overwrite their placement.
* The owner wants **placement reviewed first, routing only after an explicit go**.
* They notice cosmetic problems: messy or ambiguous silkscreen labels, and "unnecessary" vias (stitching vias under a
  module). Look at a render of both sides before calling a layout done.
* pcbnew API notes: `pads = fp.Pads()` then iterate it (do not wrap it in `list()`); `fp.Remove(pad)` works;
  net names from the netlist start with `/` (`/+3V3`, `/SDA`); a footprint's `path` is the schematic symbol UUID, which is
  what keeps "Update PCB from Schematic" from duplicating parts. Do not name a script `inspect.py` (it shadows the stdlib).
* The ADS122C04 library footprint still carries four 2.5 mm mounting holes. On the gauge board they were removed from the
  BOARD only (`tools/layout/remove_pads.py`); "Update footprints from library" would restore them.
* **Check that every part got its nets** after building a board from a netlist: `python.exe tools/layout/check_pad_nets.py <pcb> <net>`.
  A symbol whose pin numbers differ from its footprint's pad numbers gets no nets (no ratsnest). This hit D1-D4 on the main board
  (symbol pins A/K vs KiCad diode footprints pads 1 = cathode / 2 = anode); the generators now number diode pins 1 (K) and 2 (A).
* On the main board the parts hidden under the Pico make KiCad report `pth_inside_courtyard`; the project ignores that rule (`tools/layout/set_pcbway_rules.py --ignore pth_inside_courtyard`). Run that script LAST: something in a longer command sequence reset it once.
* `lib_footprint_mismatch` DRC warnings ("local override") are cosmetic: text moved or fields edited on a footprint.
* `kicad-cli pcb export gerbers` writes a date into every file header, so re-exports differ byte-for-byte but not in content.

## Fabrication settings used (PCBWay, 2 layers)

1.6 mm FR4, 1 oz copper, min track/space 6/6 mil (0.1524 mm), min drill 0.3 mm, copper-to-edge 0.3 mm. Default net class:
0.25 mm track, 0.2 mm clearance, 0.6/0.3 mm via (`tools/layout/set_pcbway_rules.py` writes these into the `.kicad_pro`).
Stay inside 100 x 100 mm (PCBWay's cheapest quote tier). Everything on the top face, all connectors vertical 0.1 in
headers, M3 holes (3.2 mm) 4 mm in from each corner, copper pour kept 3.25 mm (radius) from each hole for the screw head.
Reference text 0.8 mm, horizontal. PCBWay's own help for the board-type options (single / panel by customer / panel by
PCBWay) is at pcbway.com/helpcenter/ordering_parameter_instruction/Board_type.html.

## Gauge board as built (rev A)

* 54.22 x 49.60 mm, 3 mm corner radius, M3 holes 46 x 41.5 mm apart. Layout (owner's final, hand-adjusted): loom J1/J2 as
  horizontal rows at the top left; C1, C2, U1 (LDO), C3, C4 and the test points down the left; R5/R6 (completion pair)
  vertical at the lower left; ADS122C04 breakouts U2 above U3, both rotated 180 degrees (digital row on top); R2/C5/R1
  between the modules and R4/C6/R3 below U3 (the optional filter positions); gauge headers J4 above J3 on the right (2x3
  each, rows V V / SIG SIG / GND GND). Logo and "STRAIN GAUGE BREAKOUT" text are on the back silkscreen.
* Routing (all scripted): horizontals on F.Cu, verticals on B.Cu; +3V3 is a trunk from the LDO to both ADCs and J3/J4;
  SDA/SCL run as a two-wire bus on the left; GND is a pour on both layers with 21 stitching vias outside the modules.
* **ADS_REF**: the two legs from the R5/R6 midpoint to R2.1 and R4.1 are equal (12.05 mm each).
* **SIG paths are not matched**: SIG1 4.7 mm, SIG2 37.2 mm, because J4 sits above J3 while R3 is at the bottom. Accepted by
  the owner (DC bridge signal); swapping J3/J4 or moving R3/C6 nearer J4 would fix it on a respin.
* Fab: 103 plated holes (0.3, 0.75, 0.8, 1.0 mm) and 4 non-plated M3 holes (3.2 mm).

## Next: the main board

* Brief: `../docs/PCB_BRIEF.md` (section 0 decisions, section 7 placement guidelines). Pico Plus 2 is 51 x 21 mm, the Pololu is
  6.1 mm tall, USB-C at the top, supply connector and Pololu at one end, loom and IMU headers at the Pico end.
* Main-board loom J2 must keep the order GND, +5V, SDA, SCL (same as gauge J1) and 3.3 V logic on SDA/SCL.
* Big supply paths: `+12V`, `VSERVO` (8.4 V, 5 A rail) and returns need wide traces or pours. Do not let the default 0.25 mm
  net class touch them.
* **Placed by the owner and first-attempt ROUTED (2026-10-28)** in `releases/rev-a/hastadaq/`: 62.1 x 89.4 mm, Pico top left, 5 V + 8.4 V supplies top right, encoders / I2C + supply cable / SBUS along the bottom, **12 small parts hidden under the Pico on the BOTTOM side** (see `../docs/PCB_BRIEF.md`) and a 20 mm plug-clearance strip behind the Pico (no COMPONENTS there; copper is allowed, `ROUTE_KEEP_TOP=1` restores the old no-top-copper rule). Routed with `tools/layout/route_main.py` (custom grid router, see `tools/layout/README.md`): VSERVO 2.0 mm bar on F.Cu down the J7 middle column, +12V 2.0 mm bar on B.Cu, +5V/+5V_VSYS 0.8 mm, +3V3 0.5 mm, signals 0.25 mm, GND pours on both layers. DRC (PCBWay 6/6 mil rules): no errors, no unconnected items; 18 `silk_over_copper` (part outlines clipped by mask, cosmetic), 1 `silk_overlap` (D4's "K" against R14), 2 `footprint_symbol_mismatch` (TP1/TP2 BOM flag), 2 `lib_footprint_mismatch` (both edited on this board only, library unchanged, so "Update footprints from library" would undo them: U2, the Pololu's three mounting holes removed with `remove_pads.py U2 --npth-only`; U1, the Pico footprint's Pico-W "Antenna Copper Keep Out" shortened by 3 mm with `trim_fp_keepout.py U1 3`, which is harmless for the Plus 2 but cuts into the antenna area if a Pico 2 W is ever fitted). The Pico mid-row GND pins 18 and 23 are bridged by a 0.5 mm B.Cu GND track across that freed strip. Fab files (7 Gerber layers + drills, zip for upload) are in `releases/rev-a/hastadaq/fab/` (made with `export_fab.py` after the owner's silkscreen edits; 4 NPTH holes, 298 PTH). Ordered from PCBWay 2026-10-28. Do NOT re-run `route_main.py` over a board whose routing the owner has edited. New this revision: the two SSI headers J6 and J11
  (3V3, GND, CLK, DATA) on GP17-GP19, which are on the Pico's lower right pins with the USB-C at the top, so place them there; the
  RLS RM08 encoders connect through inline LDB02 boards the owner fits near the Pico. The firmware for them is `HastaDrivers/src/Rm08Ssi.h`
  (PIO), not yet run on hardware.

## Faster routing for future boards

The gauge board (about 50 connections) took many iterations of hand-planned coordinates. The main board has far more
(Pico, six servo plugs, four SPI encoder ports, trigger and soft-stop circuits), so scripting every track by hand will not scale.
[KiCadRoutingTools](https://github.com/drandyhaas/KiCadRoutingTools) (MIT, Rust-accelerated A* router, KiCad 9/10, plugin and
CLI, plane pours, power-net widths, DRC and connectivity checkers) looks like a good fit **for the non-critical nets**.
This was judged from its README only; it has not been run here. Suggested trial: copy the main board, place parts by hand
first, route GND as a pour, let the tool route the logic nets, hand-route power and anything noise-critical, then run
`kicad-cli pcb drc --refill-zones` and review in KiCad. Install from KiCad's Plugin and Content Manager or build from source
rather than running an unvetted binary. Known limits per its README: no push-and-shove, no blind/buried vias; behaviour on a
2-layer through-hole board is not documented, so test before trusting.
