fh9g12/HastaArduino/kicad/releases/20261026-1658-rev-a/docs/PCB_BRIEF.md

# HastaDAQ REV A: PCB design brief (main board)

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

## 0. Status and hand-off (2026-10-26)

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

**Not yet verified on hardware:** see section 9.

## 1. What this board is

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

| Function | Module / circuit |
|---|---|
| Controller | Pico Plus 2 on 2 x 20 pins (stock footprint `Module:RaspberryPi_Pico_Common_THT`) |
| Strain gauges | **Not on this board.** J2 is a 1x4 loom header (GND, +5V, SDA, SCL) to the gauge board |
| IMU | Adafruit ICM20649 on a separate board; a 1x4 header (J1) carries GND/3V3/SDA/SCL (optionally via The Pi Hut Qwiic breakout 106676) |
| Servo power | Pololu D42V55F8 buck, 12 V in -> fixed 8.4 V, 5 A (`VSERVO`) |
| Logic power | SparkFun BabyBuck 5V (AP63357) -> `+5V` -> Schottky -> Pico VSYS |
| Servo bus | One 3x6 header, six servo plugs (SBUS, all signals in parallel) |
| SBUS in | One 3-pin header (J10) for an RC receiver's SBUS output, for a pass-through mode; powered from `+5V` (the Futaba R3008SB takes 4.8-7.4 V) |
| Encoders | 4 identical 0.1 in 2x4 header ports on one SPI bus (MT6835 or RLS Orbis); keyed/IDC plugs are chosen later |
| Triggers | Opto-isolated trigger in (3.3-24 V), open-collector trigger out with a jumper-selected pull-up |
| Soft stop | Normally-closed loop input (open = stop an excitation) |
| Bring-up | 2 GND test points (scope clip) |

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

## 2. Where everything is

```
kicad/hastadaq/hastadaq.kicad_pro      open this in KiCad 10 (10.0.6 was used)
kicad/hastadaq/hastadaq.kicad_sch      the schematic (single sheet, A2). Net-label connectivity.
kicad/hastadaq/hastadaq.pdf / .png     pre-rendered copies (re-export after any change)
kicad/hastadaq/HastaDAQ.kicad_sym      project symbol library (generic block symbols)
kicad/hastadaq/HastaDAQ.pretty/        project footprints, SHARED with the gauge board (see section 6)
kicad/hastadaq/HastaDAQ.3dshapes/      3D model (IMU breakout only)
kicad/hastadaq/fp-lib-table, sym-lib-table   project library tables (nickname HastaDAQ)
kicad/gaugeboard/                      the strain-gauge board (own project; docs/PCB_BRIEF_GAUGE.md)
kicad/tools/schgen_common.py           shared generator helpers
kicad/tools/generate_hastadaq_sch.py   bootstrap generator that wrote this schematic
kicad/tools/generate_gauge_sch.py      bootstrap generator for the gauge board
kicad/tools/publish.py                 snapshots both schematics into a new folder kicad/releases/<date-time>[-label]/ to start PCB layout in (see section 10)
wiring/gauge-loom.yml                  WireViz diagram of the 4-wire loom between the boards (render with WireViz + Graphviz)
docs/PARTS_TO_SELECT.md                chosen parts with RS numbers, dimensions and the remaining open items
kicad/tools/generate_module_footprints.py   generator for the module footprints
docs/README.md                         project docs; HastaDAQ_v2/ is the firmware this PCB runs
```

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

Useful commands (run from the repo root):

```
kicad-cli sch erc --output erc.rpt --format report --severity-all kicad/hastadaq/hastadaq.kicad_sch
kicad-cli sch export netlist --format kicadsexpr --output hd.net kicad/hastadaq/hastadaq.kicad_sch
kicad-cli pcb drc --output drc.rpt --format report --severity-all kicad/hastadaq/hastadaq.kicad_pcb
kicad-cli pcb render --output top.png --side top kicad/hastadaq/hastadaq.kicad_pcb
```

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

## 3. Power architecture

```
J8 (0.1 in 2x4 header, 12 V in, no fuse) -> +12V -+-> U2 Pololu D42V55F8 -> VSERVO (8.4 V) -> J7 servo header, C2 bulk
                                                                       +-> U3 BabyBuck 5V (EN left open) -> +5V -+-> encoder ports 5V pins, J2 loom pin 2 (gauge board), J10 SBUS IN V pin, C3 bulk
                                                                       |                                        +-> D1 Schottky -> +5V_VSYS -> Pico VSYS (pin 39)
                                                                       +-> C1 100 uF input bulk, J9 jumper (12 V pull-up option)
Pico 3V3(OUT) (pin 36) -> +3V3 -> IMU header J1, encoder ports 3V3 pins, pull-ups
```

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

## 4. Net names

`+12V`, `VSERVO`, `+5V`, `+5V_VSYS`, `+3V3`, `GND`, `SBUS`, `SBUS_IN`, `SBUS_IN_GPIO`, `SDA`, `SCL`, `SPI_SCK`, `SPI_MOSI`, `SPI_MISO`, `ENC1_CS`..`ENC4_CS`, `TRIG_IN`, `TRIG_IN_LED`, `TRIG_IN_GPIO`, `TRIG_OUT`, `TRIG_OUT_BASE`, `TRIG_OUT_GPIO`, `TRIG_PU`, `SOFTSTOP_CABLE`, `SOFTSTOP_IN`.

There is **one ground net**. See section 7 for how to treat it.

### Pico GPIO map (fixed by the schematic; the firmware depends on it)

| GPIO (header pin) | Net | Use |
|---|---|---|
| GP4 (6) / GP5 (7) | `SDA` / `SCL` | I2C0: the IMU header (J1) and the gauge-board loom (J2). No pull-ups on this board; the ADS122C04 breakouts (gauge board) and the IMU breakout have their own |
| GP10 (14) / GP11 (15) / GP12 (16) | `SPI_SCK` / `SPI_MOSI` / `SPI_MISO` | SPI1 shared by the four encoder ports |
| GP13 (17) / GP9 (12) / GP8 (11) / GP7 (10) | `ENC1_CS` / `ENC2_CS` / `ENC3_CS` / `ENC4_CS` | encoder chip-selects, each with a 10 k pull-up to 3V3 |
| GP14 (19) | `TRIG_IN_GPIO` | trigger in (opto output, 10 k pull-up, inverted) |
| GP15 (20) | `TRIG_OUT_GPIO` | trigger out (to the NPN base, inverted) |
| GP1 (2) | `SBUS_IN_GPIO` | SBUS from an RC receiver (J10) through 1 k, with a 5.1 V zener clamp (D4) and a 10 k pull-down (R14, leave unfitted at first, see section 9); UART0 RX. Pass-through firmware is not written yet. |
| GP16 (21) | `SOFTSTOP_IN` | soft stop (1 k series, 10 k pull-up, 5.1 V zener to GND) |
| GP20 (26) / GP21 (27) | `SBUS` (both) | UART1 TX and RX tied together on one net (firmware inverts the UART) |
| GP32-GP36 | (SP/CE connector, not on the header) | RM2 WiFi breakout, cabled off-board |

Do not change a GPIO assignment without telling the owner: it is a firmware change.

## 5. Connectors and pin maps

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

* **J8** (main supply cable, 0.1 in 2x4 header; **supply max 20 V**): 1=+12V, 2=GND, 3=TRIG_IN, 4=SOFTSTOP_CABLE, 5=GND (SOFTSTOP-), 6=TRIG_OUT, 7=GND, 8=+12V. Laid out so that even a 180-degree rotated plug puts supply on supply and ground on ground; the keyed shroud prevents it anyway. Two supply pins carry the system current.
* **J3-J6** (ENC1-ENC4, 0.1 in 2x4 headers, identical): 1=GND, 2=ENCn_CS, 3=SPI_SCK, 4=SPI_MOSI, 5=SPI_MISO, 6=+3V3, 7=+5V, 8=GND. MT6835 uses 3V3, RLS Orbis uses the 5V pin (4.5-5.5 V, 3.3 V logic). Keep these leads short.
* **J7** (SBUS, custom `HastaDAQ:PinHeader_3x06_P2.54mm_Vertical`): six servo plugs side by side; for servo k=1..6 the pins are 3k-2 = GND, 3k-1 = VSERVO, 3k = SBUS (the servo plug order, V in the middle).
* **J10** (SBUS IN, RC receiver, 1x3): 1=GND, 2=+5V, 3=SBUS_IN. Same plug order as the servos (GND, V, SIG). The receiver is powered from **`+5V`, not the 8.4 V servo rail**: the Futaba R3008SB manual gives 4.8 V to 7.4 V, so `VSERVO` would overstress it (check any other receiver's range, and never connect a second supply to the V pin). The signal passes a 1 k series resistor, a 5.1 V zener D4 to GND (clamps a receiver that outputs more than 5.1 V; its capacitance, about 100 pF, is harmless at SBUS's 100 kbaud) and a 10 k pull-down R14, which holds the line at the idle-low level of inverted SBUS when nothing is plugged in. **Leave R14 unfitted for the first trial and add it only if the idle level needs it**: the RP2350 errata (E9) say a pin with a weak pull-down (above about 8.2 k) can sit near 2 V when its input is enabled, so if R14 is fitted and the pin misbehaves use 4.7 k. The 1 k and 10 k divider gives GP1 3.0 V from a 3.3 V receiver.
* **J2** (gauge-board loom, 1x4 header): 1=GND, 2=+5V, 3=SDA, 4=SCL. Pin 2 is **5 V, not 3V3**: it is deliberately not Qwiic-compatible, so use a keyed plug and never connect a Qwiic cable or a bare Qwiic sensor to it. The matching header on the gauge board (J1) has the same order, so the loom is a straight 1:1 cable. Keep it short (boards sit side by side); SDA/SCL swing to the 3V3 set by the breakouts' pull-ups on the gauge board.
* **J1** (IMU, 1x4): 1=GND, 2=+3V3, 3=SDA, 4=SCL. Plain 1x4 0.1 in header (the custom `Qwiic_Breakout_1x4_Socket` footprint is still in the library but unused). This is the 3V3 version: do not mix it up with J2.
* **J9** (TRIG_OUT pull-up select, 1x5 in one row): 1=+3V3, 2=TRIG_PU, 3=+5V, 4=TRIG_PU, 5=+12V. A 2-pin shunt bridges only adjacent pins, so it can only ever join a rail to `TRIG_PU`, never two rails together (an earlier 2x3 header let a vertically placed shunt join 3V3 to 5V or 5V to 12V). Shunt 1-2 for 3V3, 2-3 or 3-4 for 5V, 4-5 for 12V; fit **one** shunt or none. **Label the voltage under each rail pin on the silkscreen**: the 12 V pin on a 3.3 V-limited receiver would damage it.
* Test points TP1-TP2 (GND), section 8.

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

## 6. Footprints and modules

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

| Part | Footprint | Source / key facts |
|---|---|---|
| U1 Pico Plus 2 | `Module:RaspberryPi_Pico_Common_THT` (stock) | 40 pads, 2.54 mm pitch, rows 17.78 mm apart; board 51 x 21 mm (Pimoroni mechanical diagram). Plus 2 has USB-C at one end; its SP/CE JST (8-pin, GP32-GP36) is reported on the **underside** and its Qw/ST and debug JST connectors on top: leave room below and above the module and keep the USB-C end clear of tall parts. |
| U2 Pololu | `HastaDAQ:Pololu_D42V55Fx` | Pololu dimension drawing 0J2180 + pinout photo. 25.4 mm square; 12 pads (1.02 mm holes) in a 2x6 grid; three 2.18 mm holes (2.2 mm in from three corners). Columns VOUT GND GND VIN VRP PG(inner)/EN(edge); odd pads inner row, even pads edge row. **6.1 mm tall** above the board (D42V55F8), 1.4 mm below. VRP, PG and EN are unused (EN has a 1 M pull-up to VIN on the module). |
| U3 BabyBuck | `HastaDAQ:SparkFun_BabyBuck_5V` | SparkFun Eagle file. 15.875 x 13.208 mm; one 1x4 header; pads bottom to top 5V GND VIN EN; no mounting holes. EN is left open (data sheet: floating EN auto-starts; the module's own divider sets about 6.2 V start-up). |
| J1 IMU header | `Connector_PinHeader_2.54mm:PinHeader_1x04_P2.54mm_Vertical` | plain 1x4 header for four wires or a Qwiic breakout (the earlier custom Qwiic footprint with its STEP model is still in `HastaDAQ.pretty` but unused) |
| U4 FOD817A | `Package_DIP:DIP-4_W7.62mm` | RS 761-4439 (onsemi FOD817A, 4-pin DIP, CTR 80-160 %): pin-compatible with PC817 |
| Q1 2N3904 | `Package_TO_SOT_THT:TO-92_Inline` | pin 1 E, 2 B, 3 C (Fairchild/onsemi Rev 1.1.0 data sheet). Orient the flat face to the footprint outline. |
| J3-J6, J8 | `Connector_PinHeader_2.54mm:PinHeader_2x04_P2.54mm_Vertical` | plain 0.1 in 2x4 header for now; pad numbering is identical to the keyed IDC box header that may replace it later (the owner chooses the keyed plug type) |

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

### Parts list (from the schematic)

| Ref | Value / description | Footprint |
|---|---|---|
| C1 | 100uF 25V input bulk (Panasonic ECA1EM101, 6.3 x 11.2 mm) | `Capacitor_THT:CP_Radial_D6.3mm_P2.50mm` |
| C2 | 470uF 16V servo bulk (Panasonic EEUFR1C471, 8 x 11.5 mm) | `Capacitor_THT:CP_Radial_D8.0mm_P3.50mm` |
| C3 | 100uF 10V 5V bulk (RS PRO LHK, 5 x 7 mm) | `Capacitor_THT:CP_Radial_D5.0mm_P2.00mm` |
| D1 | Schottky (e.g. 1N5822, 3A) | `Diode_THT:D_DO-201AD_P15.24mm_Horizontal` |
| D2 | 5.1V zener (BZX55C5V1) soft-stop clamp | `Diode_THT:D_DO-35_SOD27_P7.62mm_Horizontal` |
| D3 | 1N4148 (LED reverse protect) | `Diode_THT:D_DO-35_SOD27_P7.62mm_Horizontal` |
| D4 | 5.1V zener (BZX55C5V1) SBUS IN clamp | `Diode_THT:D_DO-35_SOD27_P7.62mm_Horizontal` |
| J1 | IMU via Qwiic breakout (The Pi Hut 106676) | `Connector_PinHeader_2.54mm:PinHeader_1x04_P2.54mm_Vertical` |
| J2 | Gauge-board loom (1x4): GND, +5V, SDA, SCL | `Connector_PinHeader_2.54mm:PinHeader_1x04_P2.54mm_Vertical` |
| J3 | ENC1 SPI port: MT6835 (pitch) / Orbis | `Connector_PinHeader_2.54mm:PinHeader_2x04_P2.54mm_Vertical` |
| J4 | ENC2 SPI port: MT6835 / Orbis | `Connector_PinHeader_2.54mm:PinHeader_2x04_P2.54mm_Vertical` |
| J5 | ENC3 SPI port: MT6835 / Orbis | `Connector_PinHeader_2.54mm:PinHeader_2x04_P2.54mm_Vertical` |
| J6 | ENC4 SPI port: generic SPI device | `Connector_PinHeader_2.54mm:PinHeader_2x04_P2.54mm_Vertical` |
| J7 | SBUS servo header 3x6 (6 plugs: GND, V, SIG) | `HastaDAQ:PinHeader_3x06_P2.54mm_Vertical` |
| J8 | Main supply cable (2x4): VSUPPLY, VGND, TRIG, SOFTSTOP | `Connector_PinHeader_2.54mm:PinHeader_2x04_P2.54mm_Vertical` |
| J9 | TRIG_OUT pull-up sel. (1x5) | `Connector_PinHeader_2.54mm:PinHeader_1x05_P2.54mm_Vertical` |
| J10 | SBUS IN (RC receiver): GND, V, SIG | `Connector_PinHeader_2.54mm:PinHeader_1x03_P2.54mm_Vertical` |
| Q1 | 2N3904 NPN (TO-92, pin 1 E, 2 B, 3 C) | `Package_TO_SOT_THT:TO-92_Inline` |
| R1-R4 | 10k (ENCn_CS pull-ups to 3V3) | `Resistor_THT:R_Axial_DIN0207_L6.3mm_D2.5mm_P7.62mm_Horizontal` |
| R5 | 1k (soft-stop series) | `Resistor_THT:R_Axial_DIN0207_L6.3mm_D2.5mm_P7.62mm_Horizontal` |
| R6 | 10k (soft-stop pull-up) | `Resistor_THT:R_Axial_DIN0207_L6.3mm_D2.5mm_P7.62mm_Horizontal` |
| R7 | 10k pull-down | `Resistor_THT:R_Axial_DIN0207_L6.3mm_D2.5mm_P7.62mm_Horizontal` |
| R8 | 1k 1W | `Resistor_THT:R_Axial_DIN0411_L9.9mm_D3.6mm_P12.70mm_Horizontal` |
| R9 | 10k pull-up | `Resistor_THT:R_Axial_DIN0207_L6.3mm_D2.5mm_P7.62mm_Horizontal` |
| R10 | 2.2k (base) | `Resistor_THT:R_Axial_DIN0207_L6.3mm_D2.5mm_P7.62mm_Horizontal` |
| R11 | 10k (base-emitter) | `Resistor_THT:R_Axial_DIN0207_L6.3mm_D2.5mm_P7.62mm_Horizontal` |
| R12 | 1.5k pull-up | `Resistor_THT:R_Axial_DIN0207_L6.3mm_D2.5mm_P7.62mm_Horizontal` |
| R13 | 1k series | `Resistor_THT:R_Axial_DIN0207_L6.3mm_D2.5mm_P7.62mm_Horizontal` |
| R14 | 10k pull-down (SBUS IN; leave unfitted on the first trial) | `Resistor_THT:R_Axial_DIN0207_L6.3mm_D2.5mm_P7.62mm_Horizontal` |
| TP1 | TP | `TestPoint:TestPoint_Pad_D2.0mm` |
| TP2 | TP | `TestPoint:TestPoint_Pad_D2.0mm` |
| U1 | Pimoroni Pico Plus 2 (header pins) | `Module:RaspberryPi_Pico_Common_THT` |
| U2 | Pololu D42V55F8 8.4V 5A buck (servo rail) | `HastaDAQ:Pololu_D42V55Fx` |
| U3 | SparkFun BabyBuck 5V (AP63357) (Pico VSYS, Orbis, gauge board) | `HastaDAQ:SparkFun_BabyBuck_5V` |
| U4 | FOD817A opto (TRIG_IN) | `Package_DIP:DIP-4_W7.62mm` |

Values marked "(e.g. ...)" are suggestions, not fixed parts. All parts are through-hole. R1-R4 are the four encoder chip-select pull-ups; the netlist lists them as four separate parts with identical values.

## 7. Layout guidance

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

**Other.**

* SPI (`SPI_SCK/MOSI/MISO` and the four CS) and I2C: short, over solid ground, away from the servo rail. The encoder ports are the only external SPI cables.
* Wide traces/pours for `+12V`, `VSERVO` and their returns (section 3 numbers). Give the Pololu pads (VOUT/GND/VIN duplicated on both rows) copper that uses every pad.
* Keep the opto/trigger/soft-stop parts together near J8 and away from the Pico end.
* Silkscreen: pin 1 on every connector, function names on J8 (with **"MAX 20V IN"** beside the supply pins), J3-J6, J7 (GND, V, SIG per plug), J2 (**"+5V, NOT 3V3"** on pin 2, keyed plug; a reversed plug puts +5V on SDA and SCL on GND, an accepted risk, so also print an arrow or a pin 1 marker beside the header), J9 (voltage at each rail pin), J10 (GND, V=5V, SIG), the electrolytic polarities (C1, C2, C3), and "BabyBuck EN open".
**Mechanical guidelines for both boards (owner, 2026-10-26; guidelines, not rules).**

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

**Main board placement (owner's suggestion): portrait, USB-C pointing off the top edge.**

```
              USB-C off the top edge
        +---------------------------------+
        |  J2 loom   [  Pico Plus 2  ]  BabyBuck (near VSYS)
        |  J1 IMU    [  51 x 21 mm   ]  Pololu  (alongside the Pico)
        |  (left edge, near GP4/GP5)       |
        |                                  |
        | ENC1-4 (bottom left)  J8 supply (bottom centre/right)
        |                       J10 + J7 SBUS (bottom right)
        +---------------------------------+
```

* **Group by current, not by voltage.** 12 V, 8.4 V and 5 V are all low-voltage; what matters is current and switching noise. Keep the high-current path J8 -> Pololu -> J7 (about 4 A in at 12 V, up to 5 A out at 8.4 V) short and in one region (bottom right, with the Pololu beside the Pico). Keep the logic, the SPI and I2C traces and the encoder connectors on the other side (left), away from the Pololu's inductor and the BabyBuck.
* **Supply at the bottom rather than the top.** Putting J8 at the top right would split the cables between both ends and place a 12 V connector beside the USB-C. The Pico's pins also point the other way: with USB-C at the top, pin 1 is top left, so the SPI, chip selects and triggers (pins 10-17, 19, 20) are on the **lower left**, the SBUS pins GP20/21 (26, 27) and soft stop GP16 (21) are on the **lower right**, and I2C GP4/GP5 (pins 6, 7) are **upper left**. So: encoders bottom left, J8 and the trigger and soft-stop parts bottom centre, J7 and J10 bottom right, and the loom J2 and IMU J1 on the left edge near the top (the gauge board sits to the left, J2 on the edge facing it).
* **Exceptions:** GP1 (SBUS IN, pin 2) is at the top left, so J10's signal is the longest signal run; it is slow (100 kbaud), 1 k-limited and clamped, so that is fine, but keep it away from the Pololu and the servo traces. The `+5V` has to reach the Pico VSYS (top right, pin 39), the encoder ports (bottom left) and J2, so put the BabyBuck on the right above the Pololu and route `+5V` as a wide trace or pour (at least 1 mm).
* The module heights and positions matter more than the exact sketch: the Pololu is 25.4 mm square and 6.1 mm tall, and the Pico Plus 2's SP/CE JST sits on its underside, so keep the board under that part free of parts and copper (a cut-out or keepout) and check it on the 1:1 print.
* Width target: stay inside 100 x 100 mm (PCBWay's cheapest tier). The four encoder headers, J8, J7 (15.2 mm wide), J10 and J2 do not fit along one 70 mm bottom edge: use the bottom edge and the lower parts of the side edges, or two rows near the bottom.
* Still not given: the exact board outline and the enclosure. Allow for the Pico's USB-C overhang, its underside SP/CE JST and the Pololu's 6.1 mm height.

## 8. Test points

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

## 9. Known unverified items (hardware not yet run)

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

Treat the first spin as a **prototype**: keep the jumpers and test points accessible.

## 10. Suggested workflow

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
