fh9g12/HastaArduino/kicad/hastadaq/hastadaq.pdf

1 | 2 | 3 | 4 | 5 | 6 | 7 | 8 | 9 | 10 | 11

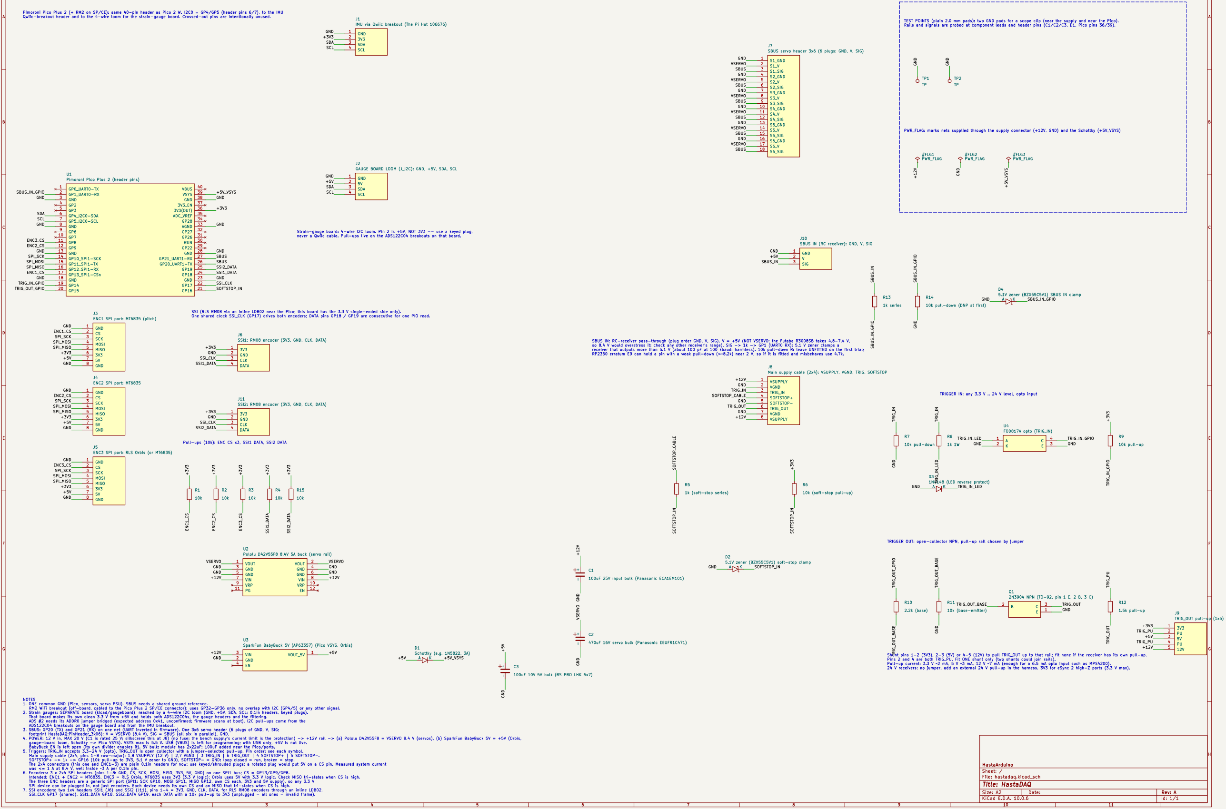
[picture p1: figure]
FGH; FGH Date:; KiCad E.D.A. 10.0.6; Size: A2; Rev: A; Title: HastaDAQ; File: hastadaq.kicad_sch; Sheet: /; HastaArduino; GND 1; SCK 3; MOSI 4; MISO 5; GND 8; ENC2 SPI port: MT6835; GND 1 5V 2 SDA 3 SCL 4; 3V3 2 SDA 3 SCL 4; VOUT_5V; 1 GND 2; VIN 3; GND 2; CLK 3; DATA 4; 10k GND 1; ENC3 SPI port: RLS Orbis (or MT6835); 10k VOUT 1; VOUT; 2 GND 3; GND; 4 GND 5; VIN 7; VIN; VRP 9; D1 Schottky (e.g. 1N5822, 3A); 100uF 10V 5V bulk (RS PRO LHK 5x7); S1_GND; S1_SIG; S2_GND; S2_SIG; S3_GND; S3_SIG; S4_GND; S4_SIG; S5_GND; S5_SIG; S6_GND; S6_SIG; #FLG3 PWR_FLAG; #FLG2 PWR_FLAG; #FLG1 PWR_FLAG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

100uF 25V input bulk (Panasonic ECA1EM101)

J2GAUGE BOARD LOOM (J_I2C): GND, +5V, SDA, SCL GND 1 | CS 2
ENC1 SPI port: MT6835 (pitch) GP0_UART0-TX 1 | GP1_UART0-RX 2 | GND 3 | GP2 4 | GP3 5 | GP4_I2C0-SDA 6 | GP5_I2C0-SCL 7 | GND 8 | GP6 9 | GP7 10 | GP8 11 | GP9 12 | GND 13 | GP10_SPI1-SCK 14 | GP11_SPI1-TX 15 | GP12_SPI1-RX 16 | GP13_SPI1-CSn 17 | GND 18 | GP14 19 | GP15 20 | GP16 | 21 GP17 | 22 GND | 23 GP18 | 24 GP19 | 25 GP20_UART1-TX | 26 GP21_UART1-RX | 27 GND | 28 GP22 | 29 RUN | 30 GP26 | 31 GP27 | 32 AGND | 33 GP28 | 34 ADC_VREF | 35 3V3(OUT) | 36 3V3_EN | 37 GND | 38 VSYS | 39 VBUS | 40 U1Pimoroni Pico Plus 2 (header pins) | GND 1

IMU via Qwiic breakout (The Pi Hut 106676)

SparkFun BabyBuck 5V (AP63357) (Pico VSYS, Orbis)

SSI1: RM08 encoder (3V3, GND, CLK, DATA) R15

SSI2: RM08 encoder (3V3, GND, CLK, DATA)

470uF 16V servo bulk (Panasonic EEUFR1C471) R1

VRP | 10 PG 11 | EN | 12 U2Pololu D42V55F8 8.4V 5A buck (servo rail) | A | K

SBUS servo header 3x6 (6 plugs: GND, V, SIG)

J8Main supply cable (2x4): VSUPPLY, VGND, TRIG, SOFTSTOP

SBUS | SSI2_DATA SSI2_DATA | SSI1_DATA SSI1_DATA

# HastaDAQ

Net labels connect everything: same name = same net. +3V3 / GND are plain labels, not power symbols.

1. ONE common GND (Pico, sensors, servo PSU). SBUS needs a shared ground reference. RM2 WiFi breakout (off-board, cabled to the Pico Plus 2 SP/CE connector): uses GP32-GP36 only, no overlap with I2C (GP4/5) or any other signal. 2. Strain gauges: SEPARATE board (kicad/gaugeboard), reached by a 4-wire I2C loom (GND, +5V, SDA, SCL; 0.1in headers, keyed plugs). That board makes its own clean 3.3 V from +5V and holds both ADS122C04s, the gauge headers and the filtering. ADS #2 needs its ADDR0 jumper bridged (expected address 0x41, unconfirmed; firmware scans at boot). I2C pull-ups come from the

ADS122C04 breakouts on the gauge board and from the IMU breakout. 3. SBUS: GP20 (TX) and GP21 (RX) on one net (UART inverted in firmware). One 3x6 servo header (6 plugs of GND, V, SIG;

footprint HastaDAQ:PinHeader_3x06): V = VSERVO (8.4 V), SIG = SBUS (all six in parallel), GND. 4. POWER: 12 V in, MAX 20 V (C1 is rated 25 V; silkscreen this at J8) (no fuse; the bench supply's current limit is the protection) -> +12V rail -> (a) Pololu D42V55F8 = VSERVO 8.4 V (servos), (b) SparkFun BabyBuck 5V = +5V (Orbis,

gauge-board loom, Schottky -> Pico VSYS). VSYS max is 5.5 V. USB (VBUS) is left for programming; with USB only, +5V is not live. BabyBuck EN is left open (its own divider enables it). 5V bulk: module has 2x22uF; 100uF added near the Pico/ports. 5. Triggers: TRIG_IN accepts 3.3-24 V (opto), TRIG_OUT is open collector with a jumper-selected pull-up. Pin order: see each symbol. Main supply cable (2x4, pins 1-8 row-major): 1,8 VSUPPLY (12 V) | 2,7 VGND | 3 TRIG_IN | 6 TRIG_OUT | 4 SOFTSTOP+ | 5 SOFTSTOP-. SOFTSTOP+ -> 1k -> GP16 (10k pull-up to 3V3, 5.1 V zener to GND), SOFTSTOP- = GND: loop closed = run, broken = stop. The 2x4 connectors (this one and ENC1-3) are plain 0.1in headers for now; use keyed/shrouded plugs: a rotated plug would put 5V on a CS pin. Measured system current was <= 1 A at 8.4 V, well inside ~3 A per 0.1in pin. 6. Encoders: 3 x 2x4 SPI headers (pins 1-8: GND, CS, SCK, MOSI, MISO, 3V3, 5V, GND) on one SPI1 bus; CS = GP13/GP9/GP8.

Intended: ENC1 + ENC2 = MT6835, ENC3 = RLS Orbis. MT6835 uses 3V3 (3.3 V logic); Orbis uses 5V with 3.3 V logic. Check MISO tri-states when CS is high. The three ENC headers are a generic SPI port (SPI1: SCK GP10, MOSI GP11, MISO GP12, own CS each, 3V3 and 5V supply), so any 3.3 V SPI device can be plugged in, not just encoders. Each device needs its own CS and an MISO that tri-states when CS is high. 7. SSI encoders: two 1x4 headers SSI1 (J6) and SSI2 (J11), pins 1-4 = 3V3, GND, CLK, DATA, for RLS RM08 encoders through an inline LDB02. SSI_CLK GP17 (shared), SSI1_DATA GP18, SSI2_DATA GP19, each DATA with a 10k pull-up to 3V3 (unplugged = all ones = invalid frame).

TRIGGER IN: any 3.3 V .. 24 V level, opto input

Strain-gauge board: 4-wire I2C loom. Pin 2 is +5V, NOT 3V3 -- use a keyed plug, never a Qwiic cable. Pull-ups live on the ADS122C04 breakouts on that board.

Pimoroni Pico Plus 2 (+ RM2 on SP/CE): same 40-pin header as Pico 2 W. I2C0 = GP4/GP5 (header pins 6/7), to the IMU
Qwiic-breakout header and to the 4-wire loom for the strain-gauge board. Crossed-out pins are intentionally unused.

Pull-ups (10k): ENC CS x3, SSI1 DATA, SSI2 DATA

TEST POINTS (plain 2.0 mm pads): two GND pads for a scope clip (near the supply and near the Pico). Rails and signals are probed at component leads and header pins (C1/C2/C3, D1, Pico pins 36/39).

Shunt pins 1-2 (3V3), 2-3 (5V) or 4-5 (12V) to pull TRIG_OUT up to that rail; fit none if the receiver has its own pull-up. Pins 2 and 4 are both TRIG_PU. Fit ONE shunt only (two shunts could join rails).

Pull-up current: 3.3 V ~2 mA, 5 V ~3 mA, 12 V ~7 mA (enough for a 6.5 mA opto input such as MPS4200). 24 V receivers: no jumper, add an external 24 V pull-up in the harness. 3V3 for eSync 2 high-Z ports (3.3 V max).

PWR_FLAG: marks nets supplied through the supply connector (+12V, GND) and the Schottky (+5V_VSYS)

TRIGGER OUT: open-collector NPN, pull-up rail chosen by jumper

SSI (RLS RM08 via an inline LDB02 near the Pico; this board has the 3.3 V single-ended side only). One shared clock SSI_CLK (GP17) drives both encoders; DATA pins GP18 / GP19 are consecutive for one PIO read. | SBUS IN: RC-receiver pass-through (plug order GND, V, SIG). V = +5V (NOT VSERVO: the Futaba R3008SB takes 4.8-7.4 V, so 8.4 V would overstress it; check any other receiver's range). SIG -> 1k -> GP1 (UART0 RX); 5.1 V zener clamps a

receiver that outputs more than 5.1 V (about 100 pF at 100 kbaud: harmless). 10k pull-down R: leave UNFITTED on the first trial; RP2350 erratum E9 can hold a pin with a weak pull-down (>~8.2k) near 2 V, so if it is fitted and misbehaves use 4.7k.
