fh9g12/HastaArduino/kicad/gaugeboard/gaugeboard.pdf

1 | 2 | 3 | 4 | 5 | 6 | 7 | 8
1 | 2 | 3 | 4 | 5 | 6 | 7 | 8

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
Size: A3 | Rev: A | F Date:
KiCad E.D.A. 10.0.6 | Id: 1/1

## Title: HastaDAQ strain-gauge board

### File: gaugeboard.kicad_sch

### Sheet: /

HastaArduino

C6

100nF 50V X7R | (DNP) VIN 1 | GND 2

SDA 3
SCL 4 | RST 5 | DRDY 6
A0 | 7
A1 | 8
A2 | 9
A3 | 10 Ref+ | 11 Ref- | 12 U3
Adafruit ADS122C04 #2 (address jumper bridged)

C2

100nF 50V X7R (Vishay K104)

R4

0R link

TP2
TP

GND 1
5V 2
SDA 3
SCL 4

J1
LOOM from main board (4-wire I2C): GND, +5V, SDA, SCL | +

C1

47uF 16V (RS PRO LHK 5x7)

#FLG2 PWR_FLAG

R3

0R link

#FLG1 PWR_FLAG

R2

0R link

C4

100nF 50V X7R (Vishay K104)

+

C3

10uF 10V tantalum (RS PRO CB, | + to 3V3) C5
100nF 50V X7R | (DNP) | TP1
| | TP

R6

350R fixed R1

0R link | V 1

V 2
SIG 3
SIG 4 | GND 5 | GND 6

J4HB2 half-bridge #2 (on beam), 2x3: V V / SIG SIG / GND GND

V 1
V 2
SIG 3
SIG 4 | GND 5 | GND 6

J3HB1 half-bridge #1 (on beam), 2x3: V V / SIG SIG / GND GND

GND 1

VIN 2

VOUT | 3 U1
3.3 V LDO: MCP1700-3302E/TO (TO-92: pin 1 GND, 2 VIN, 3 VOUT) | R5

350R fixed

VIN 1 GND 2

SDA 3
SCL 4 | RST 5 | DRDY 6
A0 | 7
A1 | 8
A2 | 9
A3 | 10 Ref+ | 11 Ref- | 12 U2

Adafruit ADS122C04 #1 (I2C 0x40) GND 1 5V 2
SDA 3
SCL 4

J2

LOOM OUT (pass-through, paralleled with J1): GND, +5V, SDA, SCL | +3V3 | +3V3

ADS1_SIG
ADS1_SIG

GND

GND +5V SDA SCL | GND +3V3 GND +5V SDA SCL | GND | +3V3 ADS1_SIG GND | ADS_REF +5V | ADS1_A0 | ADS1_A1 +5V | ADS2_SIG GND | +5V | ADS_REF ADS2_A0 | ADS2_A1 GND | ADS2_A0 ADS2_A1 | +3V3 +3V3

ADS2_SIG

# ADS2_SIG GND

GND +3V3 | GND +3V3
ADS_REF +3V3 ADS1_A0 | GND ADS1_A1

SCL +3V3 GND

SDA

ADS1_A0
ADS1_A1
ADS2_A1 +3V3 | ADS2_A0 GND
SDA SCL | GND | +5V | GND
Pin 2 is +5V, NOT 3V3: use a keyed plug, never a Qwiic cable. | Load is about 20 mA (bridges 2 x 4.7 mA + ADCs); the LDO dissipates about 35 mW (250 mA rating). POWER: bulk + decoupling on the loom 5 V (any ferrite bead is part of the loom, not the board), the LDO makes the quiet 3.3 V that powers BOTH ADCs and the bridge excitation HastaDAQ strain-gauge board

NOTES
1. Each half-bridge head (2 gauges) plugs into a 2x3 header with doubled rows: V V (+3V3) / SIG SIG (mid-point) / GND GND, so two quarter-bridge gauges can be completed into a half bridge in the plug. The two fixed 350R
completion resistors are shared; their mid-point (ADS_REF) goes to A1 of both ADCs. Excitation is the ADC's own VIN, so VREF_SUPPLY is ratiometric: no Ref+/Ref- wiring. 2. 3V3 comes ONLY from the on-board LDO (from the loom's 5 V): cable voltage drop and the main board's switching noise do

not reach the bridges or the ADC reference. The ADC logic lines (SDA/SCL) are pulled up by the ADS122C04 breakouts to this 3V3 and are 3.3 V logic: the master must not drive them above 3.6 V. Each breakout also has its own 10uF + 100nF on VIN, so no extra ADC decoupling is fitted here. 3. Input filters are optional: with the 0R links and no capacitor fitted there is none (original behaviour). Fit 1k in each

link and 100nF across A0-A1 for about an 800 Hz low-pass (the 100nF positions are marked DNP). 4. ADS #2: bridge its ADDR0 solder jumper (ADDR0 is pulled to GND by 10k, so the jumper ties it to VCC: expected address 0x41; the main board's firmware scans at boot). The Adafruit breakouts carry 10k pull-ups on SDA/SCL to their VIN. 5. Use shielded twisted cable for the gauge wires, shield to GND at this board only.

TEST POINTS: GND (scope clip) and the regulated +3V3

ADS1 input filter (optional: 1k links + 100nF) Second 1x4 header wired straight to the loom: daisy-chains another I2C board (+5V, 3.3 V logic). | Shared completion

resistors (fixed) -> A1 of BOTH ADCs ADS2 input filter (optional: 1k links + 100nF)

Net labels connect everything: same name = same net. Companion to the main board (kicad/hastadaq). Reusable: any I2C master with 5 V and 3.3 V logic can drive it. C2

100nF 50V X7R (Vishay K104) C1

47uF 16V (RS PRO LHK 5x7)

+

C3

10uF 10V tantalum (RS PRO CB, + to 3V3)

+

C4

100nF 50V X7R (Vishay K104)
