fh9g12/HastaArduino/kicad/gaugeboard/gaugeboard.png

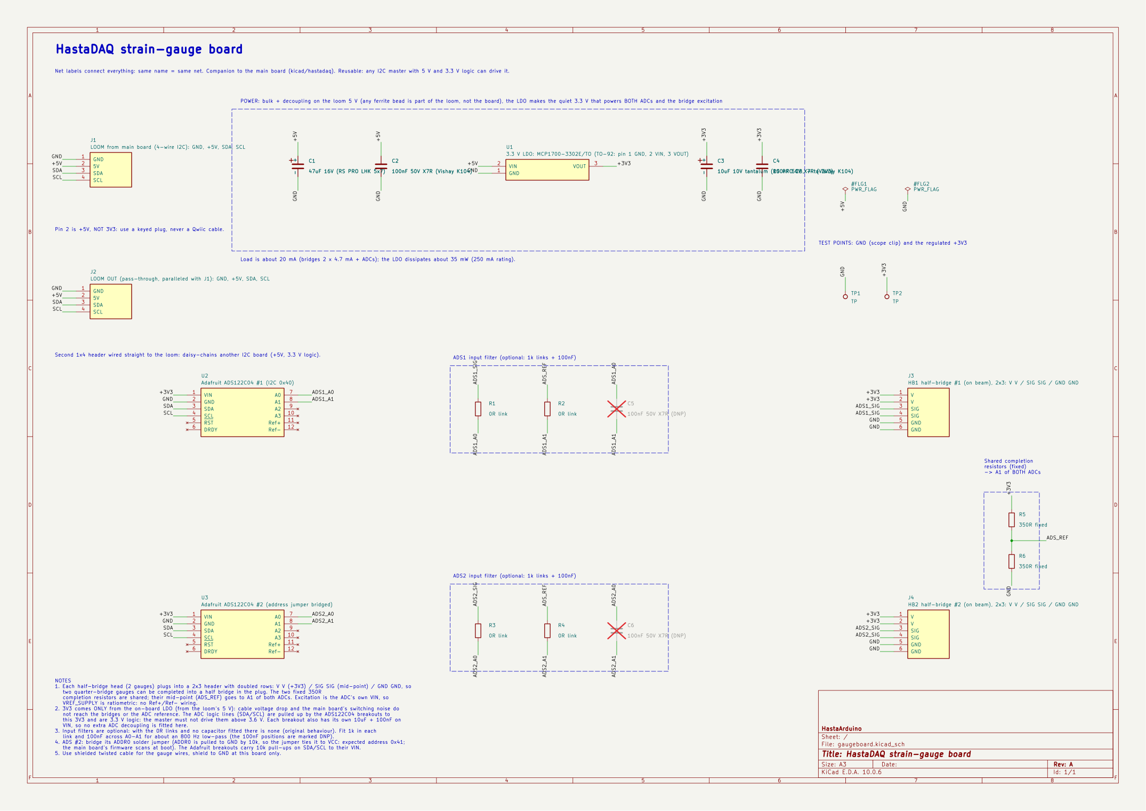
kicad/gaugeboard/gaugeboard.png
