fh9g12/HastaArduino/kicad/hastadaq/hastadaq.png

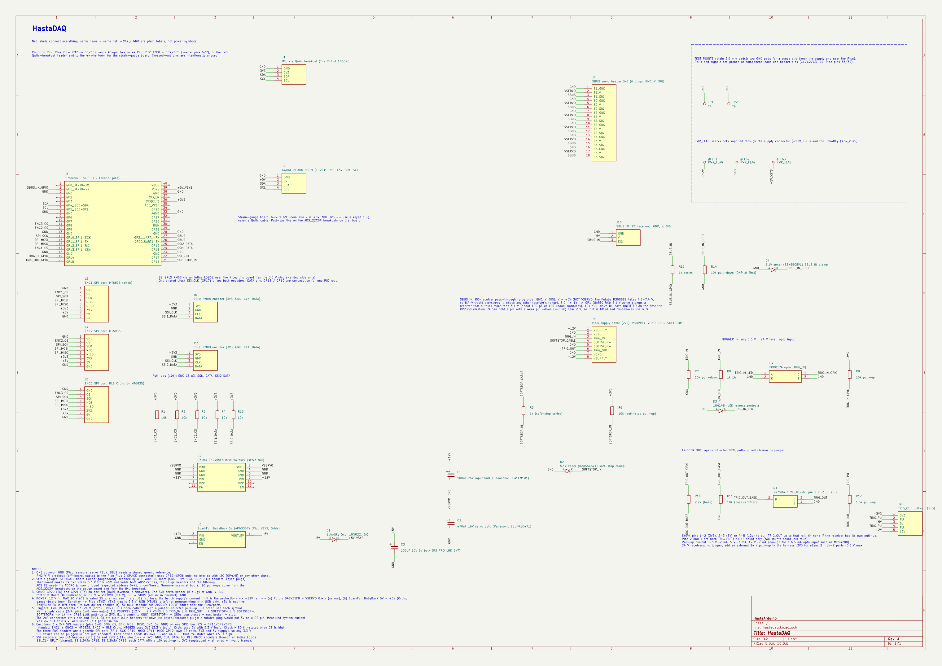
kicad/hastadaq/hastadaq.png
