fh9g12/HastaArduino/docs/BOM_rev-a.xlsx

Sheet: Shopping list
Parts to buy: HastaDAQ main board + gauge board, rev A
How to use: pick a Status in column A (dropdown), type what you bought in 'Qty bought' and the unit price; everything marked yellow is yours to fill in.
Qty per board comes from the 'Board BOM' sheet; 'Qty needed' = main x boards + gauge x boards + other. Change the two board counts below (blue). |  |  |  | Progress
Status 'Own stock' counts as done. Supplier part numbers are RS stock numbers where they are known (from docs/PARTS_TO_SELECT.md); blank means not found yet. | Main boards to populate | 2 |  | Items to buy | 43
 | Gauge boards to populate | 2 |  | Not ordered | 43
 |  |  |  | Ordered, not yet received | 0
 |  |  |  | Received or own stock | 0
 |  |  |  | Complete | 0%
 |  |  |  | Total spent (GBP) | £349.47
Status | Group | Item | Spec / value | Supplier | Supplier part no. (RS stock no.) | Qty per main board | Qty per gauge board | Other qty (off-board / assembly) | Qty needed | Qty bought | Still to buy | Unit price (GBP) | Line cost (GBP) | Order ref / date | Used on | Notes
 | Main board modules
Not ordered | Main board modules | Pimoroni Pico Plus 2 | RP2350, 16 MB flash, 8 MB PSRAM, USB-C | Pimoroni |  | 1 | 0 |  | 2 | 2 | 0 |  | £0.00 |  | Main U1 | Footprint is the 'header pins' version: check the one you buy has headers (or add 2 x 1x20 pin headers). Soldered straight to the PCB.
Not ordered | Main board modules | Pololu D42V55F8 step-down regulator | 8.4 V, 5 A (servo rail), 6.1 mm tall | ThePiHut | COM-21256 | 1 | 0 |  | 2 | 2 | 0 | £46.10 | £92.20 |  | Main U2
Not ordered | Main board modules | SparkFun BabyBuck 5V (AP63357) | 5 V buck for Pico VSYS and Orbis | ThePiHut | COM-21256 | 1 | 0 |  | 2 | 3 | 0 | £5.80 | £17.40 |  | Main U3 | EN may be left open.
 | Main board semiconductors
Not ordered | Main board semiconductors | onsemi FOD817A opto-coupler | 4-pin DIP, CTR 80-160 % | RS Components | 761-4439 | 1 | 0 |  | 2 | 10 | 0 | £0.20 | £2.03 |  | Main U4 | TRIG_IN stage.
Not ordered | Main board semiconductors | 2N3904 NPN transistor | TO-92 (pin 1 E, 2 B, 3 C) | RS Components | 843-1575 | 1 | 0 |  | 2 | 50 | 0 | £0.18 | £9.10 |  | Main Q1 | RS number not recorded in the docs: add it when you find it.
Not ordered | Main board semiconductors | STMicroelectronics 1N5822 Schottky diode | 3 A, 40 V, DO-201AD | RS Components | 687-0877 | 1 | 0 |  | 2 | 100 | 0 | £0.11 | £10.90 |  | Main D1 | Supply reverse-protection diode.
Not ordered | Main board semiconductors | Taiwan Semi BZX55C5V1 zener diode | 5.1 V, 500 mW, DO-35 | RS Components | 748-5051 | 2 | 0 |  | 4 | 200 | 0 | £0.05 | £10.00 |  | Main D2; Main D4 | D2 soft-stop clamp, D4 SBUS IN clamp.
Not ordered | Main board semiconductors | Vishay BAV17-BAV21 switching diode | DO-35, 250 mA (any family member) | RS Components | 700-3863 | 1 | 0 |  | 2 | 100 | 0 | £0.06 | £6.00 |  | Main D3 | Schematic text says 1N4148; any DO-35 small-signal diode works (1N4148 etc.). Confirm the exact type on the RS page.
 | Main board capacitors
Not ordered | Main board capacitors | Panasonic ECA1EM101 electrolytic 100 uF 25 V | 6.3 x 11.2 mm, 2.5 mm pitch, 85 C | RS Components | 181-5448 | 1 | 0 |  | 2 | 100 | 0 | £0.07 | £6.50 |  | Main C1 | C1, 12 V input bulk.
Not ordered | Main board capacitors | Panasonic EEUFR1C471 electrolytic 470 uF 16 V | 8.0 x 11.5 mm, 3.5 mm pitch, low ESR, 105 C | RS Components | 708-3620 | 1 | 0 |  | 2 | 10 | 0 | £0.30 | £2.98 |  | Main C2 | C2, servo rail bulk.
Not ordered | Main board capacitors | RS PRO LHK electrolytic 100 uF 10 V | 5 x 7 mm, 2.0 mm pitch, 105 C | RS Components | 707-5799 | 1 | 0 |  | 2 | 200 | 0 | £0.06 | £11.40 |  | Main C3 | C3, 5 V bulk near the Pico.
 | Resistors (1/4 W axial, DIN0207)
Not ordered | Resistors (1/4 W axial, DIN0207) | Resistor 10 k | 1/4 W axial | RS Components | 199-7658 | 10 | 0 |  | 20 | 100 | 0 | £0.02 | £1.80 |  | Main R1,R2,R3,R4,R15; Main R6; Main R7; Main R9; Main R11; Main R14 | Main R14 is left unfitted at first (SBUS IN pull-down) but included here.
Not ordered | Resistors (1/4 W axial, DIN0207) | Resistor 1 k | 1/4 W axial | RS Components | 199-7601 | 2 | 0 |  | 4 | 100 | 0 | £0.02 | £1.80 |  | Main R5; Main R13
Not ordered | Resistors (1/4 W axial, DIN0207) | Resistor 2.2 k | 1/4 W axial | RS Components | 199-7660 | 1 | 0 |  | 2 | 100 | 0 | £0.02 | £1.80 |  | Main R10 | Q1 base resistor.
Not ordered | Resistors (1/4 W axial, DIN0207) | Resistor 1.5 k | 1/4 W axial | RS Components | 199-7606 | 1 | 0 |  | 2 | 100 | 0 | £0.02 | £1.80 |  | Main R12 | TRIG_OUT pull-up.
Not ordered | Resistors (1/4 W axial, DIN0207) | Resistor 1 k, 1 W | 1 W axial, body about 9.9 x 3.6 mm | RS Components | 707-8669 | 1 | 0 |  | 2 | 10 | 0 | £0.22 | £2.18 |  | Main R8 | R8: 1 W because a 24 V trigger gives about 0.6 W.
Not ordered | Resistors (1/4 W axial, DIN0207) | Resistor 0 ohm link | 1/4 W axial | RS Components |  | 0 | 4 |  | 8 | 8 | 0 | £0.00 | £0.00 |  | Gauge R1,R2,R3,R4 | Gauge board input-filter positions.
Not ordered | Resistors (1/4 W axial, DIN0207) | Resistor 350 ohm precision | 1/4 W axial | Own stock |  | 0 | 2 |  | 4 | 4 | 0 |  | £0.00 |  | Gauge R5,R6 | Gauge board completion pair: the owner's own precision parts.
 | Pin headers (0.1 in, vertical)
Not ordered | Pin headers (0.1 in, vertical) | Pin header 1x3 | 2.54 mm |  | 7670858 | 1 | 0 |  | 2 | 10 | 0 | £0.14 | £1.40 |  | Main J10 | Main J10 (SBUS IN).
Not ordered | Pin headers (0.1 in, vertical) | Pin header 1x4 | 2.54 mm |  | 064479 | 4 | 2 |  | 12 | 20 | 0 | £0.16 | £3.20 |  | Main J1; Main J2; Main J6; Main J11; Gauge J1; Gauge J2 | Main J1 IMU, J2 loom, J6/J11 SSI; gauge J1/J2 loom.
Not ordered | Pin headers (0.1 in, vertical) | Pin header 1x5 | 2.54 mm |  | 2001739 | 1 | 0 |  | 2 | 5 | 0 | £0.34 | £1.70 |  | Main J9 | Main J9 (TRIG_OUT pull-up select).
Not ordered | Pin headers (0.1 in, vertical) | Pin header 2x3 | 2.54 mm |  | 2086581 | 0 | 2 |  | 4 | 10 | 0 | £0.31 | £3.10 |  | Gauge J3; Gauge J4 | Gauge J3/J4 half-bridge headers.
Not ordered | Pin headers (0.1 in, vertical) | Pin header 2x4 | 2.54 mm |  | 7670873 | 4 | 0 |  | 8 | 20 | 0 | £0.37 | £7.40 |  | Main J3; Main J4; Main J5; Main J8 | Main J3-J5 encoder ports, J8 supply.
Not ordered | Pin headers (0.1 in, vertical) | Pin header 3x6 (3 rows of 6) | 2.54 mm, 18 pins |  | 2001753 | 1 | 0 |  | 2 | 4 | 0 | £1.01 | £4.04 |  | Main J7 | Main J7, the six servo plugs. Make from three 1x6 strips, or snap from a long strip.
 | Gauge board parts
Not ordered | Gauge board parts | Microchip MCP1700-3302E/TO LDO | 3.3 V, 250 mA, TO-92 | RS Components | 040-3888 | 0 | 1 |  | 2 | 10 | 0 | £0.38 | £3.75 |  | Gauge U1 | Input max 6.0 V: only the 5 V loom may feed it.
Not ordered | Gauge board parts | RS PRO LHK electrolytic 47 uF 16 V | 5 x 7 mm, 2.0 mm pitch | RS Components | 707-5758 | 0 | 1 |  | 2 | 100 | 0 | £0.06 | £6.10 |  | Gauge C1 | C1, polarised: + to +5V.
Not ordered | Gauge board parts | RS PRO CB solid tantalum 10 uF 10 V | about 5.0 x 8.0 mm, 2.5 mm pitch | RS Components | 181-4731 | 0 | 1 |  | 2 | 50 | 0 | £0.30 | £15.00 |  | Gauge C3 | C3, polarised: + (bar) to +3V3.
Not ordered | Gauge board parts | Vishay K-series ceramic capacitor 100 nF 50 V X7R | radial, 2.5 mm lead spacing | RS Components | 181-6552 | 0 | 4 |  | 8 | 50 | 0 | £0.08 | £4.15 |  | Gauge C2,C4; Gauge C5,C6 | C2, C4 fitted; C5, C6 are optional filter positions (DNP by default) but included.
Not ordered | Gauge board parts | Adafruit ADS122C04 breakout | 24-bit I2C ADC, soldered straight to the PCB | ThePiHut | ADA6432 | 0 | 2 |  | 4 | 6 | 0 | £19.20 | £115.20 |  | Gauge U2; Gauge U3 | Two per gauge board.
 | Off-board items
Not ordered | Off-board items | Pimoroni RM2 WiFi breakout + JST-SH 8-pin lead | cabled to the Pico Plus 2 SP/CE connector | Pimoroni |  | 0 | 0 | 1 | 1 | 1 | 0 |  | £0.00 |  |  | Not on either PCB.
Not ordered | Off-board items | Adafruit ICM20649 IMU + Pi Hut Qwiic breakout 106676 | plugs into main J1 | Adafruit / The Pi Hut |  | 0 | 0 | 1 | 1 | 1 | 0 |  | £0.00 |  |  | Not on either PCB.
Not ordered | Off-board items | MT6835 encoder breakout | SPI, 21-bit |  |  | 0 | 0 | 2 | 2 |  | 2 |  | £0.00 |  |  | Main J3/J4 (ENC1, ENC2). Mark Own stock if you have them.
Not ordered | Off-board items | RLS Orbis encoder | SPI | RLS |  | 0 | 0 | 1 | 1 | 1 | 0 |  | £0.00 |  |  | Main J5 (ENC3).
Not ordered | Off-board items | RLS RM08 encoder (RM08SC0012B50U2G00, 3.3 V) | 12-bit SSI | RLS |  | 0 | 0 | 2 | 2 | 2 | 0 |  | £0.00 |  |  | Main J6/J11 (SSI1, SSI2).
Not ordered | Off-board items | RLS LDB02 line-drive board for SSI | fitted inline near the Pico | RLS |  | 0 | 0 | 2 | 2 | 2 | 0 |  | £0.00 |  |  | One per RM08.
Not ordered | Off-board items | Servos (up to 6) with SBUS | plug into J7 |  |  | 0 | 0 | 6 | 6 | 6 | 0 |  | £0.00 |  |  | Quantity is the owner's rig; set Own stock if already owned.
Not ordered | Off-board items | SBUS receiver (Futaba R3008SB) | 4.8-7.4 V, for J10 pass-through |  |  | 0 | 0 | 1 | 1 | 1 | 0 |  | £0.00 |  |  | Optional until the pass-through firmware exists.
 | Assembly items
Not ordered | Assembly items | Shunt jumper 2.54 mm | for J9 | RS Components | 251-8682 | 0 | 0 | 1 | 1 | 10 | 0 | £0.43 | £4.30 |  |  | One on J9.
Not ordered | Assembly items | Mating plugs and cable for the headers | keyed or shrouded: owner's choice |  |  | 0 | 0 |  | 0 |  | 0 |  | £0.00 |  |  | A rotated encoder or supply plug puts 5 V or 12 V on a wrong pin, so key them. Encoder and supply cables, loom plugs and wire, servo plugs, SBUS IN lead.
Not ordered | Assembly items | Ferrite (clip-on or bead) for the +5V loom wire |  | RS Components | 647-9907 | 0 | 0 | 1 | 1 | 10 | 0 | £0.22 | £2.24 |  |  | Not on either PCB.
Not ordered | Assembly items | Shielded twisted-pair gauge cable | shield to GND at the gauge board only |  |  | 0 | 0 |  | 0 |  | 0 |  | £0.00
Not ordered | Assembly items | M3 standoffs and screws (4 per board) | one set per populated board |  |  | 0 | 0 | 16 | 16 |  | 16 |  | £0.00 |  |  | Four M3 holes on each board.
Not ordered | Assembly items | 12 V supply lead for J8 | no fuse on the board: set the bench current limit (about 3 A) |  |  | 0 | 0 | 1 | 1 |  | 1 |  | £0.00

Sheet: Board BOM
Board BOM: every line of both schematics (rev A), from kicad-cli
Buy? = No means nothing to purchase (copper test pads). The Shopping list sums these quantities per item.
Board | References | Qty | Schematic value | Footprint | Buy? | Shopping list item | Note
Main | C1 | 1 | 100uF 25V input bulk (Panasonic ECA1EM101) | CP_Radial_D6.3mm_P2.50mm | Yes | Panasonic ECA1EM101 electrolytic 100 uF 25 V
Main | C2 | 1 | 470uF 16V servo bulk (Panasonic EEUFR1C471) | CP_Radial_D8.0mm_P3.50mm | Yes | Panasonic EEUFR1C471 electrolytic 470 uF 16 V
Main | C3 | 1 | 100uF 10V 5V bulk (RS PRO LHK 5x7) | CP_Radial_D5.0mm_P2.00mm | Yes | RS PRO LHK electrolytic 100 uF 10 V
Main | D1 | 1 | Schottky (e.g. 1N5822, 3A) | D_DO-201AD_P15.24mm_Horizontal | Yes | STMicroelectronics 1N5822 Schottky diode
Main | D2 | 1 | 5.1V zener (BZX55C5V1) soft-stop clamp | D_DO-35_SOD27_P7.62mm_Horizontal | Yes | Taiwan Semi BZX55C5V1 zener diode
Main | D3 | 1 | 1N4148 (LED reverse protect) | D_DO-35_SOD27_P7.62mm_Horizontal | Yes | Vishay BAV17-BAV21 switching diode
Main | D4 | 1 | 5.1V zener (BZX55C5V1) SBUS IN clamp | D_DO-35_SOD27_P7.62mm_Horizontal | Yes | Taiwan Semi BZX55C5V1 zener diode
Main | J1 | 1 | IMU via Qwiic breakout (The Pi Hut 106676) | PinHeader_1x04_P2.54mm_Vertical | Yes | Pin header 1x4
Main | J2 | 1 | GAUGE BOARD LOOM (J_I2C): GND, +5V, SDA, SCL | PinHeader_1x04_P2.54mm_Vertical | Yes | Pin header 1x4
Main | J3 | 1 | ENC1 SPI port: MT6835 (pitch) | PinHeader_2x04_P2.54mm_Vertical | Yes | Pin header 2x4
Main | J4 | 1 | ENC2 SPI port: MT6835 | PinHeader_2x04_P2.54mm_Vertical | Yes | Pin header 2x4
Main | J5 | 1 | ENC3 SPI port: RLS Orbis (or MT6835) | PinHeader_2x04_P2.54mm_Vertical | Yes | Pin header 2x4
Main | J6 | 1 | SSI1: RM08 encoder (3V3, GND, CLK, DATA) | PinHeader_1x04_P2.54mm_Vertical | Yes | Pin header 1x4
Main | J7 | 1 | SBUS servo header 3x6 (6 plugs: GND, V, SIG) | PinHeader_3x06_P2.54mm_Vertical | Yes | Pin header 3x6 (3 rows of 6)
Main | J8 | 1 | Main supply cable (2x4): VSUPPLY, VGND, TRIG, SOFTSTOP | PinHeader_2x04_P2.54mm_Vertical | Yes | Pin header 2x4
Main | J9 | 1 | TRIG_OUT pull-up (1x5) | PinHeader_1x05_P2.54mm_Vertical | Yes | Pin header 1x5
Main | J10 | 1 | SBUS IN (RC receiver): GND, V, SIG | PinHeader_1x03_P2.54mm_Vertical | Yes | Pin header 1x3
Main | J11 | 1 | SSI2: RM08 encoder (3V3, GND, CLK, DATA) | PinHeader_1x04_P2.54mm_Vertical | Yes | Pin header 1x4
Main | Q1 | 1 | 2N3904 NPN (TO-92, pin 1 E, 2 B, 3 C) | TO-92_Inline | Yes | 2N3904 NPN transistor
Main | R1,R2,R3,R4,R15 | 5 | 10k | R_Axial_DIN0207_L6.3mm_D2.5mm_P7.62mm_Horizontal | Yes | Resistor 10 k
Main | R5 | 1 | 1k (soft-stop series) | R_Axial_DIN0207_L6.3mm_D2.5mm_P7.62mm_Horizontal | Yes | Resistor 1 k
Main | R6 | 1 | 10k (soft-stop pull-up) | R_Axial_DIN0207_L6.3mm_D2.5mm_P7.62mm_Horizontal | Yes | Resistor 10 k
Main | R7 | 1 | 10k pull-down | R_Axial_DIN0207_L6.3mm_D2.5mm_P7.62mm_Horizontal | Yes | Resistor 10 k
Main | R8 | 1 | 1k 1W | R_Axial_DIN0411_L9.9mm_D3.6mm_P12.70mm_Horizontal | Yes | Resistor 1 k, 1 W
Main | R9 | 1 | 10k pull-up | R_Axial_DIN0207_L6.3mm_D2.5mm_P7.62mm_Horizontal | Yes | Resistor 10 k
Main | R10 | 1 | 2.2k (base) | R_Axial_DIN0207_L6.3mm_D2.5mm_P7.62mm_Horizontal | Yes | Resistor 2.2 k
Main | R11 | 1 | 10k (base-emitter) | R_Axial_DIN0207_L6.3mm_D2.5mm_P7.62mm_Horizontal | Yes | Resistor 10 k
Main | R12 | 1 | 1.5k pull-up | R_Axial_DIN0207_L6.3mm_D2.5mm_P7.62mm_Horizontal | Yes | Resistor 1.5 k
Main | R13 | 1 | 1k series | R_Axial_DIN0207_L6.3mm_D2.5mm_P7.62mm_Horizontal | Yes | Resistor 1 k
Main | R14 | 1 | 10k pull-down (DNP at first) | R_Axial_DIN0207_L6.3mm_D2.5mm_P7.62mm_Horizontal | Yes | Resistor 10 k | DNP at first
Main | TP1,TP2 | 2 | TP | TestPoint_Pad_D2.0mm | No | (not purchased: copper pad)
Main | U1 | 1 | Pimoroni Pico Plus 2 (header pins) | RaspberryPi_Pico_Common_THT | Yes | Pimoroni Pico Plus 2
Main | U2 | 1 | Pololu D42V55F8 8.4V 5A buck (servo rail) | Pololu_D42V55Fx | Yes | Pololu D42V55F8 step-down regulator
Main | U3 | 1 | SparkFun BabyBuck 5V (AP63357) (Pico VSYS, Orbis) | SparkFun_BabyBuck_5V | Yes | SparkFun BabyBuck 5V (AP63357)
Main | U4 | 1 | FOD817A opto (TRIG_IN) | DIP-4_W7.62mm | Yes | onsemi FOD817A opto-coupler
Gauge | C1 | 1 | 47uF 16V (RS PRO LHK 5x7) | CP_Radial_D5.0mm_P2.00mm | Yes | RS PRO LHK electrolytic 47 uF 16 V
Gauge | C2,C4 | 2 | 100nF 50V X7R (Vishay K104) | C_Rect_L4.0mm_W2.5mm_P2.50mm | Yes | Vishay K-series ceramic capacitor 100 nF 50 V X7R
Gauge | C3 | 1 | 10uF 10V tantalum (RS PRO CB, + to 3V3) | CP_Radial_D5.0mm_P2.50mm | Yes | RS PRO CB solid tantalum 10 uF 10 V
Gauge | C5,C6 | 2 | 100nF 50V X7R (DNP) | C_Rect_L4.0mm_W2.5mm_P2.50mm | Yes | Vishay K-series ceramic capacitor 100 nF 50 V X7R | DNP by default; DNP by default
Gauge | J1 | 1 | LOOM from main board (4-wire I2C): GND, +5V, SDA, SCL | PinHeader_1x04_P2.54mm_Vertical | Yes | Pin header 1x4
Gauge | J2 | 1 | LOOM OUT (pass-through, paralleled with J1): GND, +5V, SDA, SCL | PinHeader_1x04_P2.54mm_Vertical | Yes | Pin header 1x4
Gauge | J3 | 1 | HB1 half-bridge #1 (on beam), 2x3: V V / SIG SIG / GND GND | PinHeader_2x03_P2.54mm_Vertical | Yes | Pin header 2x3
Gauge | J4 | 1 | HB2 half-bridge #2 (on beam), 2x3: V V / SIG SIG / GND GND | PinHeader_2x03_P2.54mm_Vertical | Yes | Pin header 2x3
Gauge | R1,R2,R3,R4 | 4 | 0R link | R_Axial_DIN0207_L6.3mm_D2.5mm_P7.62mm_Horizontal | Yes | Resistor 0 ohm link
Gauge | R5,R6 | 2 | 350R fixed | R_Axial_DIN0207_L6.3mm_D2.5mm_P7.62mm_Horizontal | Yes | Resistor 350 ohm precision
Gauge | TP1,TP2 | 2 | TP | TestPoint_Pad_D2.0mm | No | (not purchased: copper pad)
Gauge | U1 | 1 | 3.3 V LDO: MCP1700-3302E/TO (TO-92: pin 1 GND, 2 VIN, 3 VOUT) | TO-92_Inline | Yes | Microchip MCP1700-3302E/TO LDO
Gauge | U2 | 1 | Adafruit ADS122C04 #1 (I2C 0x40) | Adafruit_ADS122C04_Breakout | Yes | Adafruit ADS122C04 breakout
Gauge | U3 | 1 | Adafruit ADS122C04 #2 (address jumper bridged) | Adafruit_ADS122C04_Breakout | Yes | Adafruit ADS122C04 breakout
