fh9g12/HastaArduino/wiring/gauge-loom.png

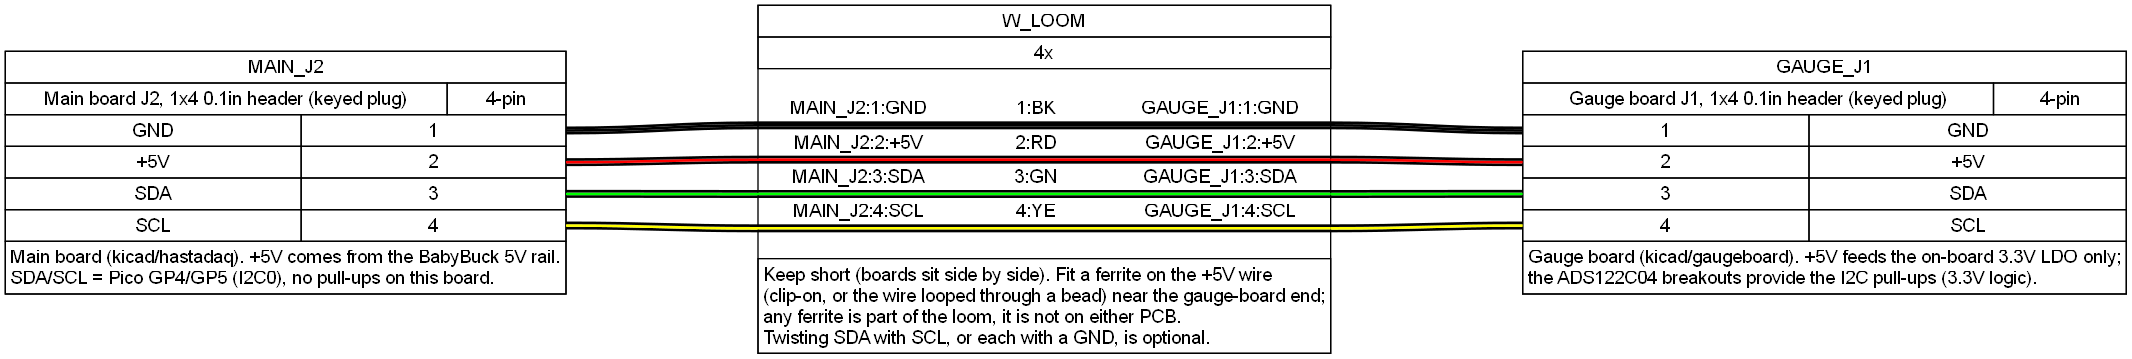
wiring/gauge-loom.png
