fh9g12/HastaArduino/wiring/hastadaq-rig.png

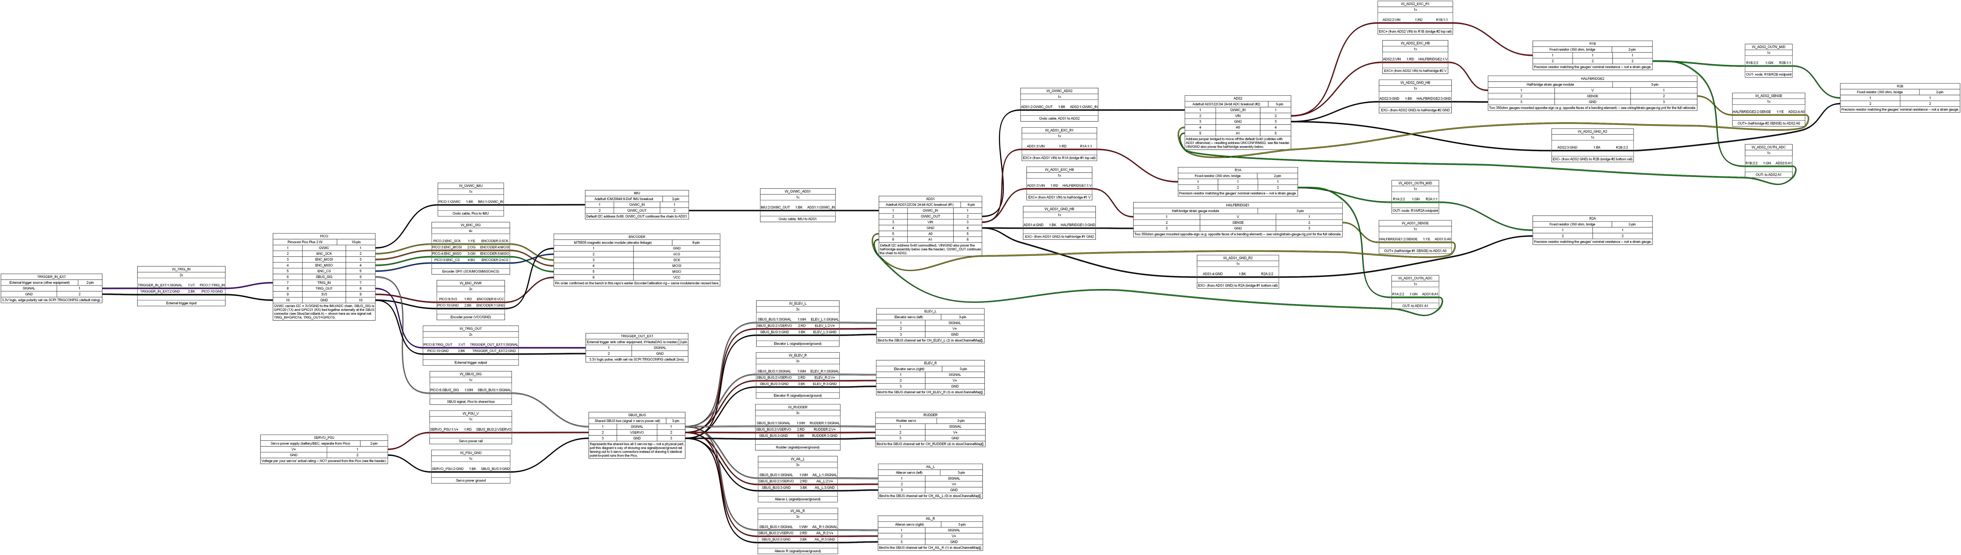
wiring/hastadaq-rig.png
