fh9g12/HastaArduino/wiring/sbus-rig.png

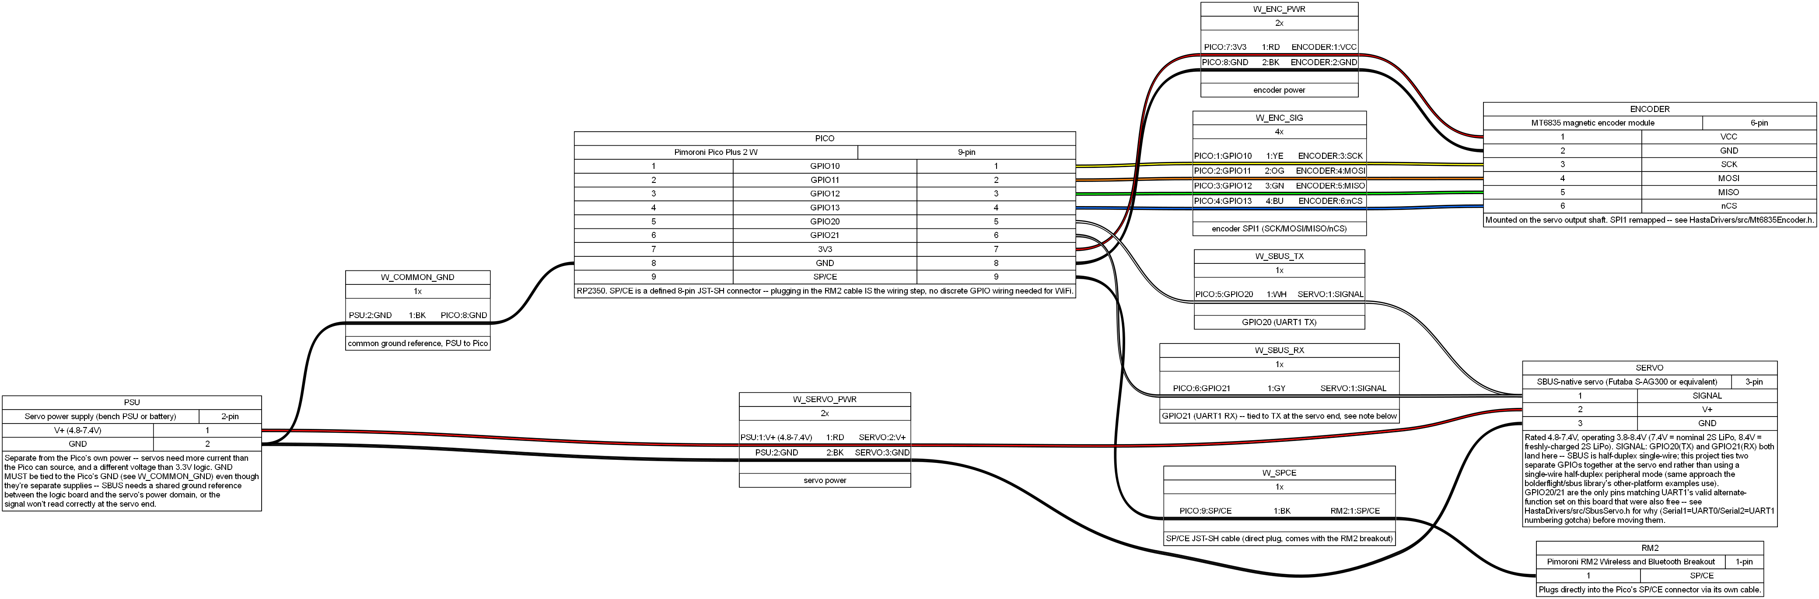
wiring/sbus-rig.png
