fh9g12/HastaArduino/wiring/strain-gauge-rig.png

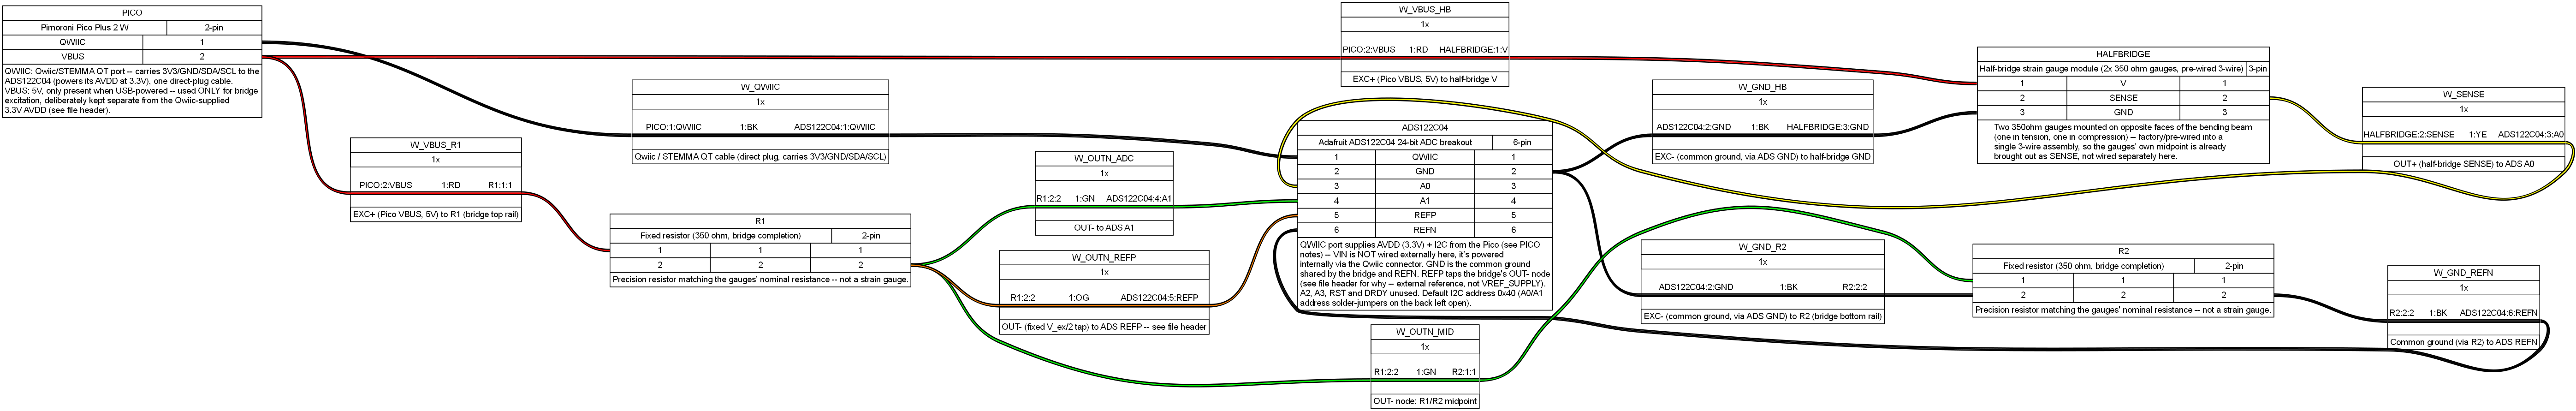
wiring/strain-gauge-rig.png
