fh9g12/HastaArduino/wiring/encoder-calibration-rig.png

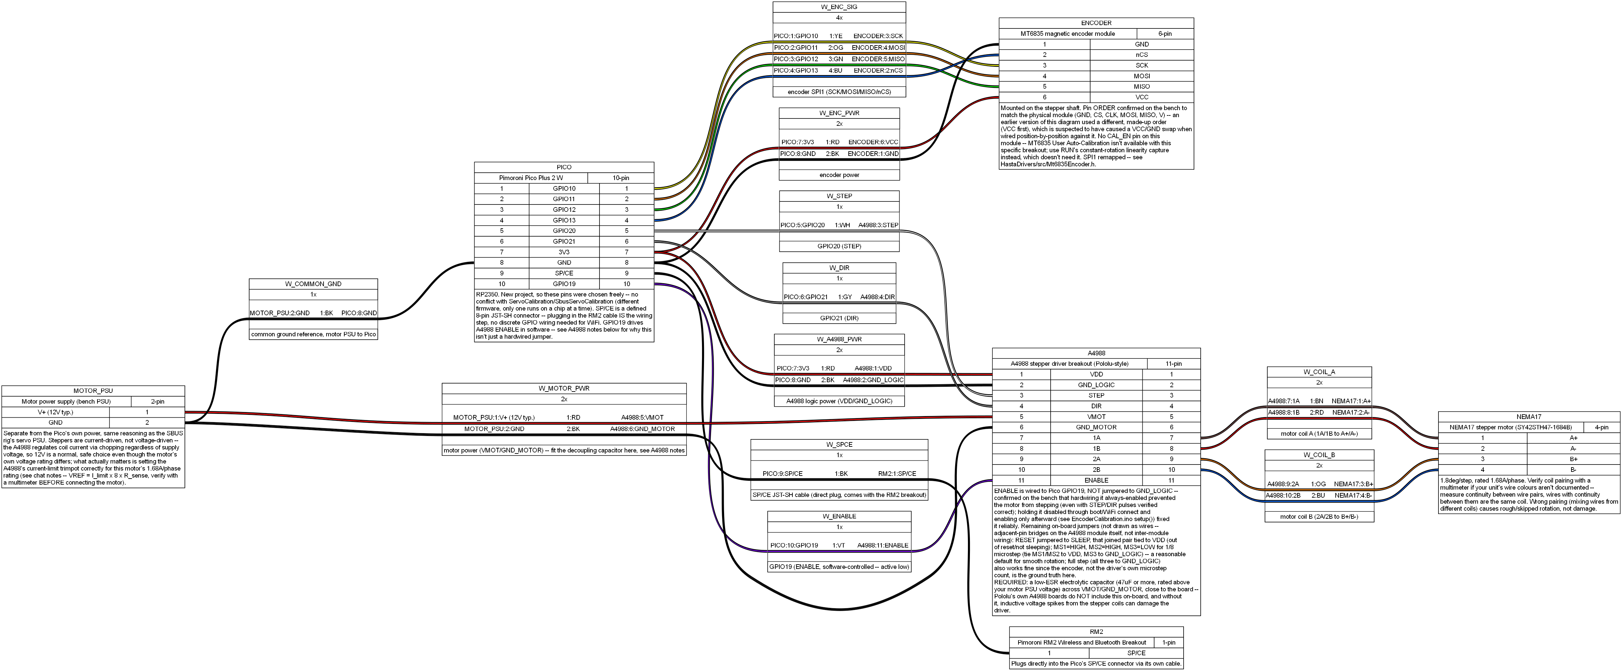
wiring/encoder-calibration-rig.png
