fh9g12/HastaArduino/kicad/releases/rev-a/hastadaq/hastadaq.kicad_pcb

## KiCad design kicad/releases/rev-a/hastadaq/hastadaq.kicad_pcb (2026-10-28)

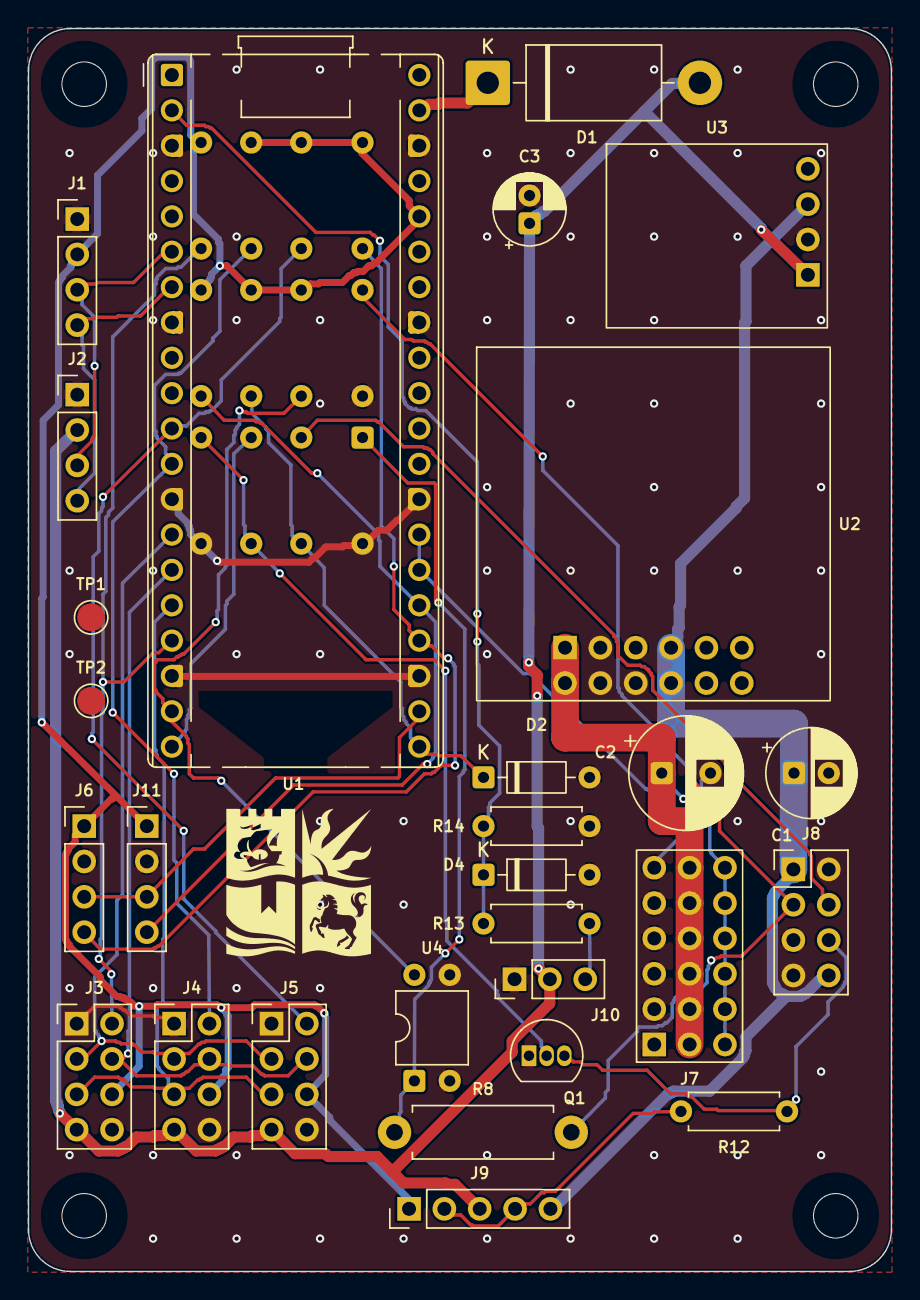
[picture p11: board hastadaq.kicad_pcb from above]

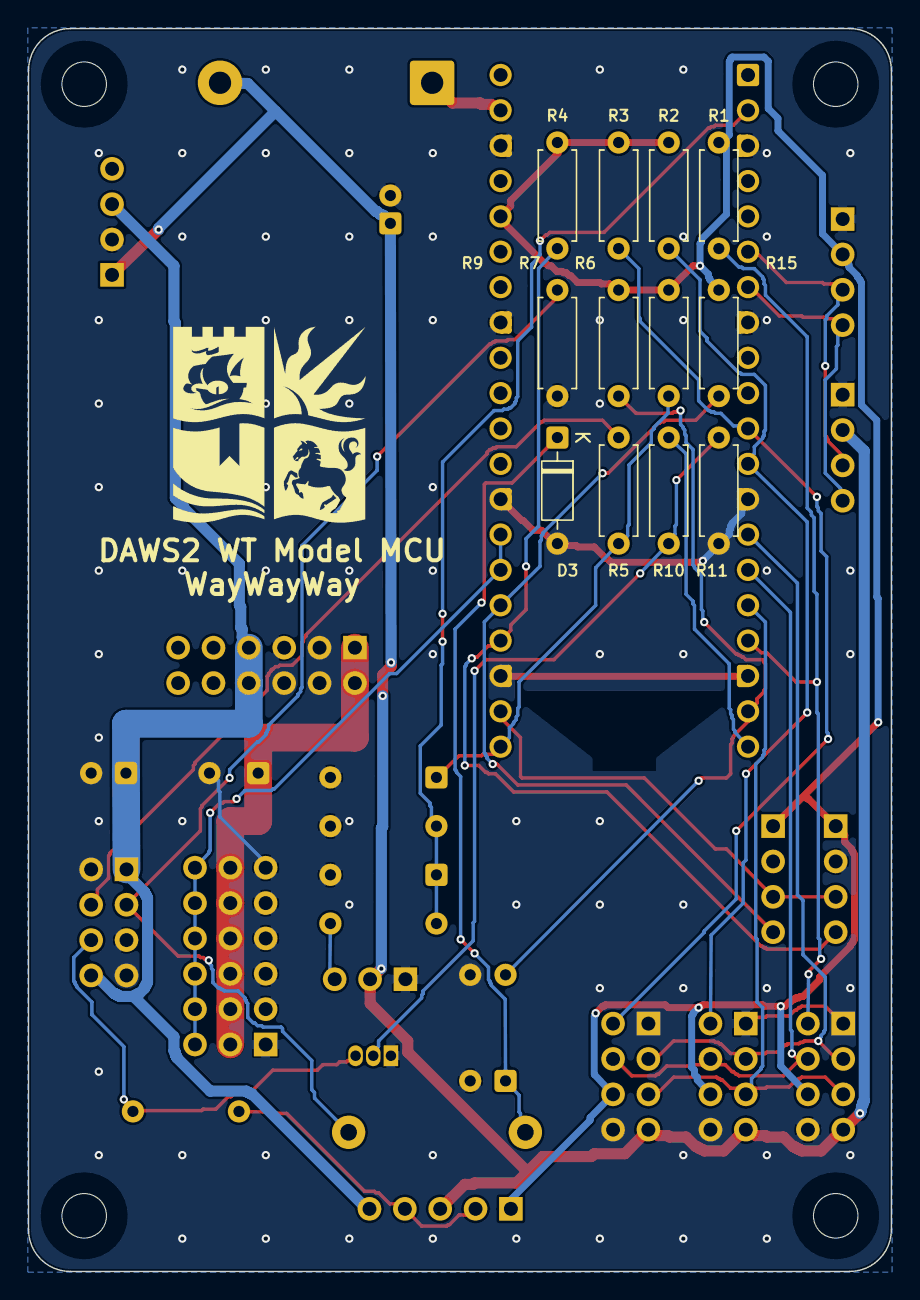
[picture p12: board hastadaq.kicad_pcb from below]

Board: 2 copper layers, 62.0 x 89.3 mm, 44 parts (12 on the bottom side), 29 nets.

Parts:
C1: 100uF 25V input bulk (Panasonic ECA1EM101); CP_Radial_D6.3mm_P2.50mm
C2: 470uF 16V servo bulk (Panasonic EEUFR1C471); CP_Radial_D8.0mm_P3.50mm
C3: 100uF 10V 5V bulk (RS PRO LHK 5x7); CP_Radial_D5.0mm_P2.00mm
D1: Schottky (e.g. 1N5822, 3A); D_DO-201AD_P15.24mm_Horizontal
D2: 5.1V zener (BZX55C5V1) soft-stop clamp; D_DO-35_SOD27_P7.62mm_Horizontal
D3: 1N4148 (LED reverse protect); D_DO-35_SOD27_P7.62mm_Horizontal
D4: 5.1V zener (BZX55C5V1) SBUS IN clamp; D_DO-35_SOD27_P7.62mm_Horizontal
H1, H2, H3, H4: MountingHole_3.2mm_M3
J1: IMU via Qwiic breakout (The Pi Hut 106676); PinHeader_1x04_P2.54mm_Vertical
J2: GAUGE BOARD LOOM (J_I2C): GND, +5V, SDA, SCL; PinHeader_1x04_P2.54mm_Vertical
J3: ENC1 SPI port: MT6835 (pitch); PinHeader_2x04_P2.54mm_Vertical
J4: ENC2 SPI port: MT6835; PinHeader_2x04_P2.54mm_Vertical
J5: ENC3 SPI port: RLS Orbis (or MT6835); PinHeader_2x04_P2.54mm_Vertical
J6: SSI1: RM08 encoder (3V3, GND, CLK, DATA); PinHeader_1x04_P2.54mm_Vertical
J7: SBUS servo header 3x6 (6 plugs: GND, V, SIG); PinHeader_3x06_P2.54mm_Vertical
J8: Main supply cable (2x4): VSUPPLY, VGND, TRIG, SOF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; PinHeader_2x04_P2.54mm_Vertical
J9: TRIG_OUT pull-up (1x5); PinHeader_1x05_P2.54mm_Vertical
J10: SBUS IN (RC receiver): GND, V, SIG; PinHeader_1x03_P2.54mm_Vertical
J11: SSI2: RM08 encoder (3V3, GND, CLK, DATA); PinHeader_1x04_P2.54mm_Vertical
Q1: 2N3904 NPN (TO-92, pin 1 E, 2 B, 3 C); TO-92_Inline
R1, R2, R3, R4, R15: 10k; R_Axial_DIN0207_L6.3mm_D2.5mm_P7.62mm_Horizontal
R5: 1k (soft-stop series); R_Axial_DIN0207_L6.3mm_D2.5mm_P7.62mm_Horizontal
R6: 10k (soft-stop pull-up); R_Axial_DIN0207_L6.3mm_D2.5mm_P7.62mm_Horizontal
R7: 10k pull-down; R_Axial_DIN0207_L6.3mm_D2.5mm_P7.62mm_Horizontal
R8: 1k 1W; R_Axial_DIN0411_L9.9mm_D3.6mm_P12.70mm_Horizontal
R9: 10k pull-up; R_Axial_DIN0207_L6.3mm_D2.5mm_P7.62mm_Horizontal
R10: 2.2k (base); R_Axial_DIN0207_L6.3mm_D2.5mm_P7.62mm_Horizontal
R11: 10k (base-emitter); R_Axial_DIN0207_L6.3mm_D2.5mm_P7.62mm_Horizontal
R12: 1.5k pull-up; R_Axial_DIN0207_L6.3mm_D2.5mm_P7.62mm_Horizontal
R13: 1k series; R_Axial_DIN0207_L6.3mm_D2.5mm_P7.62mm_Horizontal
R14: 10k pull-down (DNP at first); R_Axial_DIN0207_L6.3mm_D2.5mm_P7.62mm_Horizontal
TP1, TP2: TP; TestPoint_Pad_D2.0mm
U1: Pimoroni Pico Plus 2 (header pins); RaspberryPi_Pico_Common_THT
U2: Pololu D42V55F8 8.4V 5A buck (servo rail); Pololu_D42V55Fx
U3: SparkFun BabyBuck 5V (AP63357) (Pico VSYS, Orbis); SparkFun_BabyBuck_5V
U4: FOD817A opto (TRIG_IN); DIP-4_W7.62mm

Connections:
/+3V3: J1.2, J3.6, J4.6, J5.6, J6.1, J9.1, J11.1, R1.1, R2.1, R3.1, R4.1, R6.1, R9.1, R15.1, U1.36
/+5V: C3.1, D1.2, J2.2, J3.7, J4.7, J5.7, J9.3, J10.2, U3.1
/+5V_VSYS: D1.1, U1.39
/+12V: C1.1, J8.1, J8.8, J9.5, U2.7, U2.8, U3.3
/ENC1_CS: J3.2, R1.2, U1.17
/ENC2_CS: J4.2, R2.2, U1.12
/ENC3_CS: J5.2, R3.2, U1.11
/GND: C1.2, C2.2, C3.2, D2.2, D3.2, D4.2, J1.1, J2.1, J3.1, J3.8, J4.1, J4.8, J5.1, J5.8, J6.2, J7.1, J7.4, J7.7, J7.10, J7.13, J7.16, J8.2, J8.5, J8.7, J10.1, J11.2, Q1.1, R7.2, R11.2, R14.2, TP1.1, TP2.1, U1.3, U1.8, U1.13, U1.18, U1.23, U1.28, U1.33, U1.38, U2.3, U2.4, U2.5, U2.6, U3.2, U4.2, U4.3
/SBUS: J7.3, J7.6, J7.9, J7.12, J7.15, J7.18, U1.26, U1.27
/SBUS_IN: J10.3, R13.1
/SBUS_IN_GPIO: D4.1, R13.2, R14.1, U1.2
/SCL: J1.4, J2.4, U1.7
/SDA: J1.3, J2.3, U1.6
/SOFTSTOP_CABLE: J8.4, R5.1
/SOFTSTOP_IN: D2.1, R5.2, R6.2, U1.21
/SPI_MISO: J3.5, J4.5, J5.5, U1.16
/SPI_MOSI: J3.4, J4.4, J5.4, U1.15
/SPI_SCK: J3.3, J4.3, J5.3, U1.14
/SSI1_DATA: J6.4, R4.2, U1.24
/SSI2_DATA: J11.4, R15.2, U1.25
/SSI_CLK: J6.3, J11.3, U1.22
/TRIG_IN: J8.3, R7.1, R8.1
/TRIG_IN_GPIO: R9.2, U1.19, U4.4
/TRIG_IN_LED: D3.1, R8.2, U4.1
/TRIG_OUT: J8.6, Q1.3, R12.2
/TRIG_OUT_BASE: Q1.2, R10.2, R11.1
/TRIG_OUT_GPIO: R10.1, U1.20
/TRIG_PU: J9.2, J9.4, R12.1
/VSERVO: C2.1, J7.2, J7.5, J7.8, J7.11, J7.14, J7.17, U2.1, U2.2
