fh9g12/HastaArduino/kicad/gaugeboard/gaugeboard.kicad_sch

## KiCad design kicad/gaugeboard/gaugeboard.kicad_sch (2026-10-27)

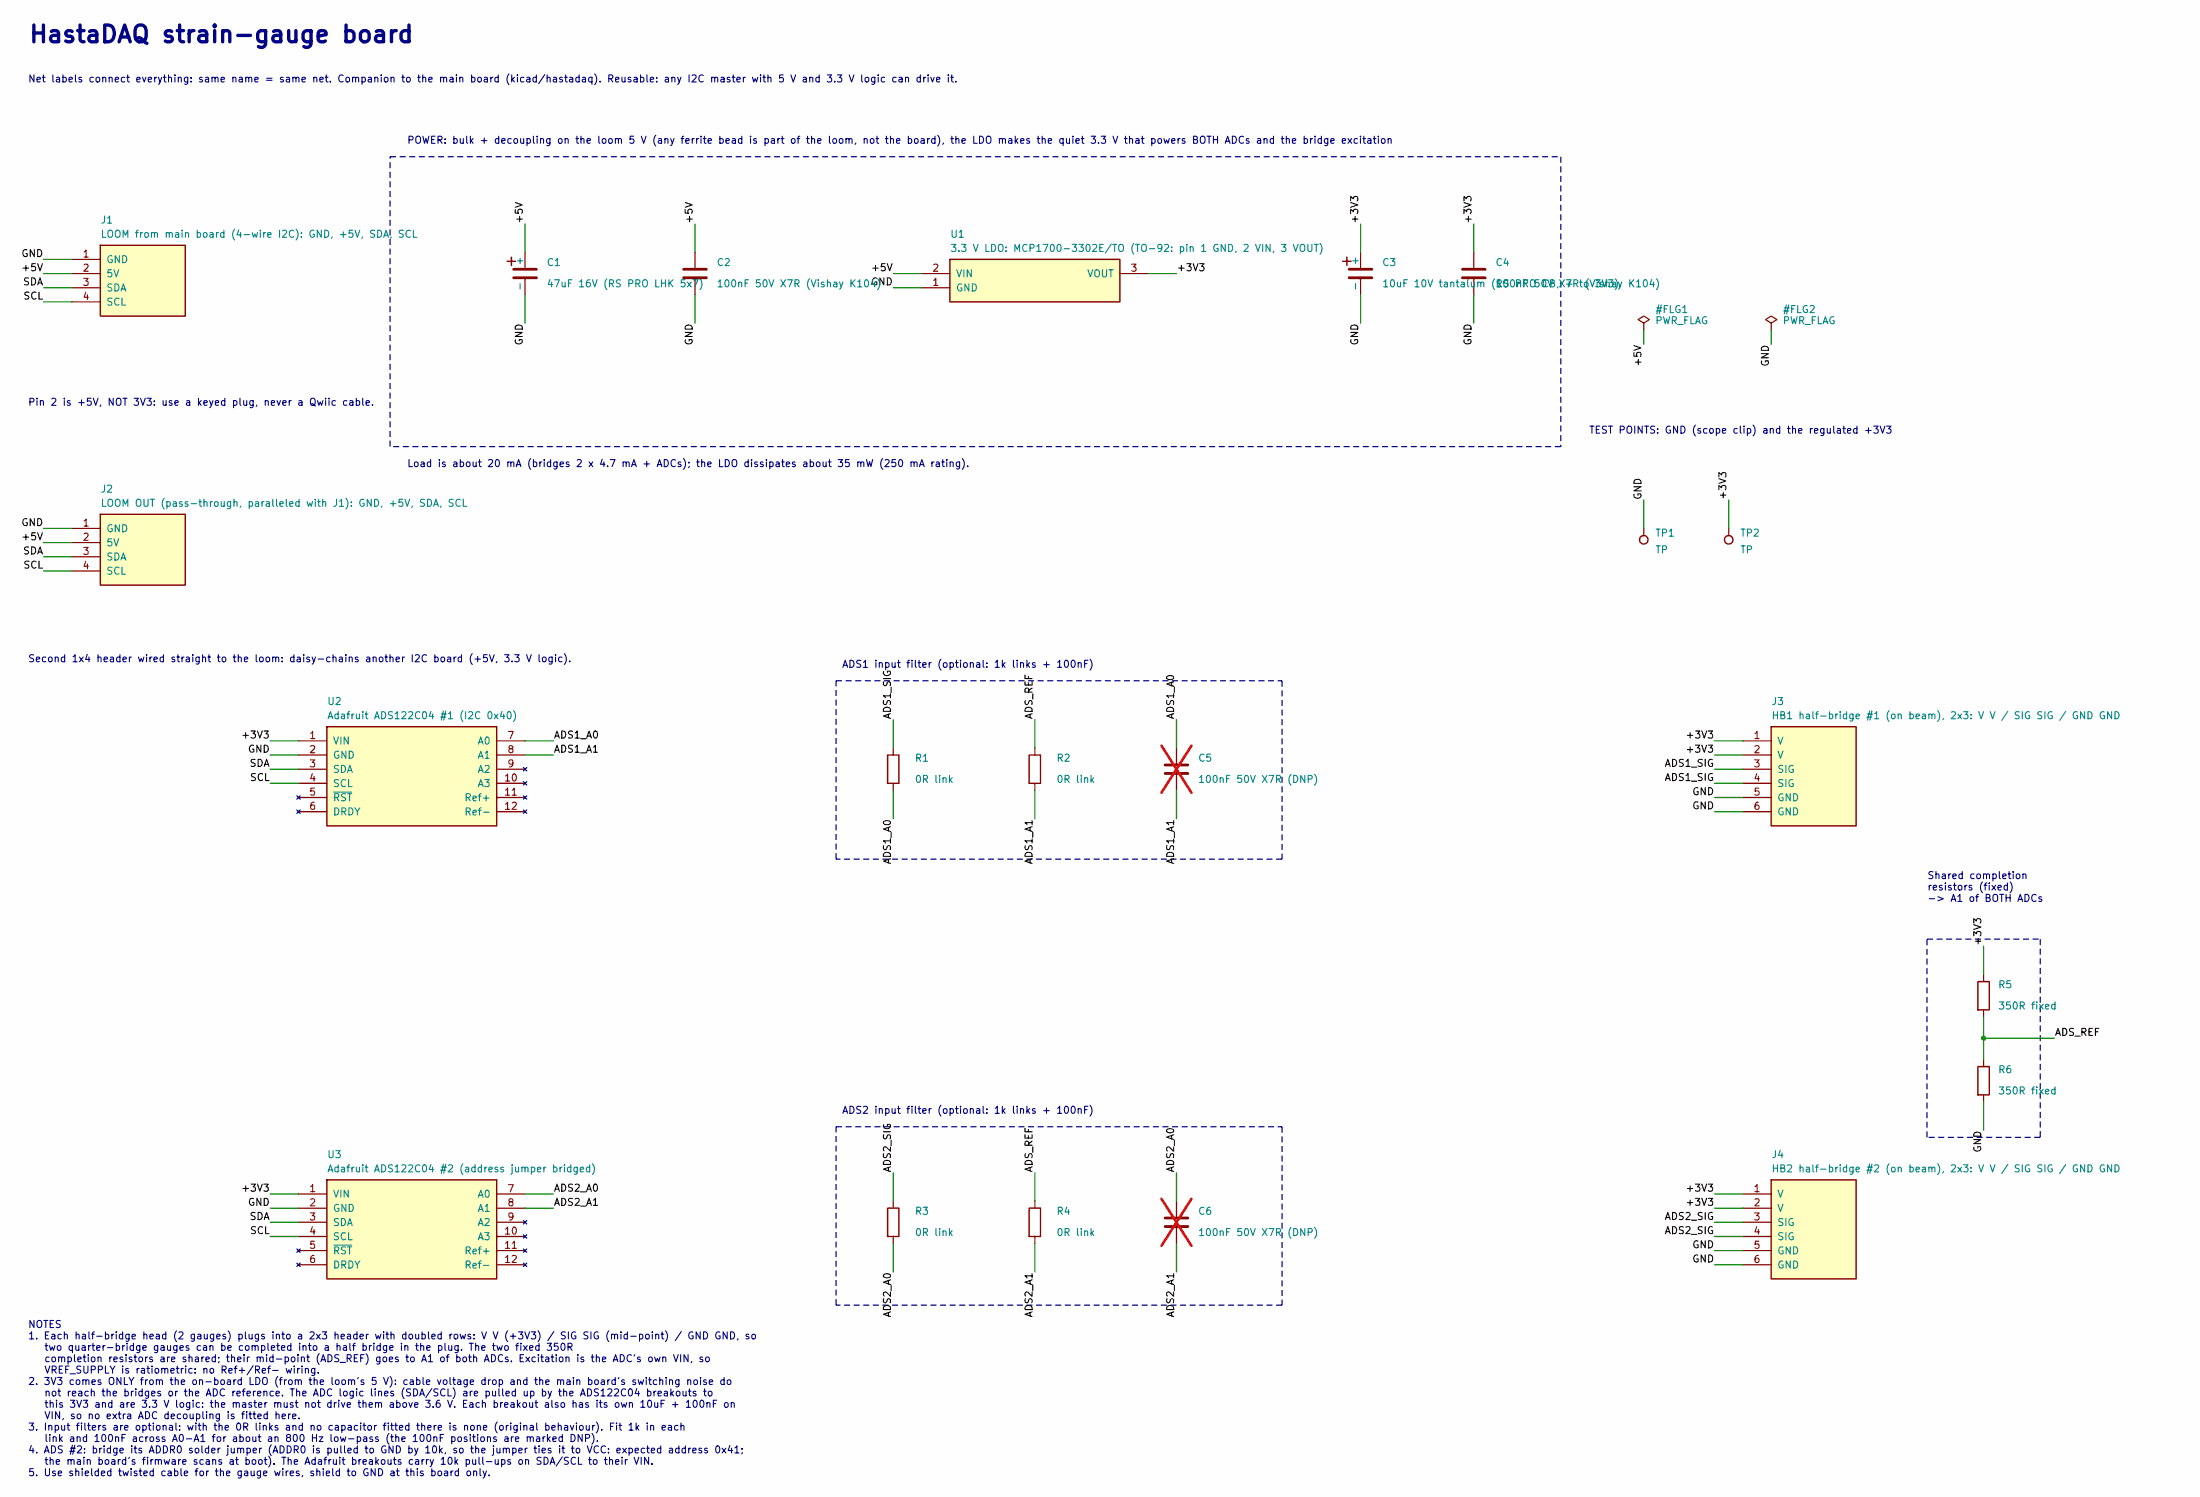
[picture p13: schematic gaugeboard.kicad_sch]

Parts:
C1: 47uF 16V (RS PRO LHK 5x7); CP_Radial_D5.0mm_P2.00mm
C2, C4: 100nF 50V X7R (Vishay K104); C_Rect_L4.0mm_W2.5mm_P2.50mm
C3: 10uF 10V tantalum (RS PRO CB, + to 3V3); CP_Radial_D5.0mm_P2.50mm
C5, C6: 100nF 50V X7R (DNP); C_Rect_L4.0mm_W2.5mm_P2.50mm; not fitted
J1: LOOM from main board (4-wire I2C): GND, +5V, SDA,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; PinHeader_1x04_P2.54mm_Vertical
J2: LOOM OUT (pass-through, paralleled with J1): GND,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; PinHeader_1x04_P2.54mm_Vertical
J3: HB1 half-bridge #1 (on beam), 2x3: V V / SIG SIG 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; PinHeader_2x03_P2.54mm_Vertical
J4: HB2 half-bridge #2 (on beam), 2x3: V V / SIG SIG 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; PinHeader_2x03_P2.54mm_Vertical
R1, R2, R3, R4: 0R link; R_Axial_DIN0207_L6.3mm_D2.5mm_P7.62mm_Horizontal
R5, R6: 350R fixed; R_Axial_DIN0207_L6.3mm_D2.5mm_P7.62mm_Horizontal
TP1, TP2: TP; TestPoint_Pad_D2.0mm
U1: 3.3 V LDO: MCP1700-3302E/TO (TO-92: pin 1 GND, 2 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; TO-92_Inline
U2: Adafruit ADS122C04 #1 (I2C 0x40); Adafruit_ADS122C04_Breakout
U3: Adafruit ADS122C04 #2 (address jumper bridged); Adafruit_ADS122C04_Breakout

Connections:
+3V3: C3.1 (+), C4.1, J3.1 (V), J3.2 (V), J4.1 (V), J4.2 (V), R5.1, TP2.1, U1.3 (VOUT), U2.1 (VIN), U3.1 (VIN)
+5V: C1.1 (+), C2.1, J1.2 (5V), J2.2 (5V), U1.2 (VIN)
ADS1_A0: C5.1, R1.2, U2.7 (A0)
ADS1_A1: C5.2, R2.2, U2.8 (A1)
ADS1_SIG: J3.3 (SIG), J3.4 (SIG), R1.1
ADS2_A0: C6.1, R3.2, U3.7 (A0)
ADS2_A1: C6.2, R4.2, U3.8 (A1)
ADS2_SIG: J4.3 (SIG), J4.4 (SIG), R3.1
ADS_REF: R2.1, R4.1, R5.2, R6.1
GND: C1.2 (-), C2.2, C3.2 (-), C4.2, J1.1 (GND), J2.1 (GND), J3.5 (GND), J3.6 (GND), J4.5 (GND), J4.6 (GND), R6.2, TP1.1, U1.1 (GND), U2.2 (GND), U3.2 (GND)
SCL: J1.4 (SCL), J2.4 (SCL), U2.4 (SCL), U3.4 (SCL)
SDA: J1.3 (SDA), J2.3 (SDA), U2.3 (SDA), U3.3 (SDA)

Notes on the sheet:
HastaDAQ strain-gauge board
Net labels connect everything: same name = same net. Companion to the main board (kicad/hastadaq). Reusable: any I2C master with 5 V and 3.3 V logic can drive it.
Pin 2 is +5V, NOT 3V3: use a keyed plug, never a Qwiic cable.
Second 1x4 header wired straight to the loom: daisy-chains another I2C board (+5V, 3.3 V logic).
POWER: bulk + decoupling on the loom 5 V (any ferrite bead is part of the loom, not the board), the LDO makes the quiet 3.3 V that powers BOTH ADCs and the bridge excitation
Load is about 20 mA (bridges 2 x 4.7 mA + ADCs); the LDO dissipates about 35 mW (250 mA rating).
TEST POINTS: GND (scope clip) and the regulated +3V3
ADS1 input filter (optional: 1k links + 100nF)
ADS2 input filter (optional: 1k links + 100nF)
Shared completion resistors (fixed) -> A1 of BOTH ADCs
NOTES 1. Each half-bridge head (2 gauges) plugs into a 2x3 header with doubled rows: V V (+3V3) / SIG SIG (mid-point) / GND GND, so two quarter-bridge gauges can be completed into a half bridge in the plug. The two fixed 350R completion resistors are shared; their mid-point (ADS_REF) goes to A1 of 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
