fh9g12/HastaArduino/kicad/hastadaq/hastadaq.kicad_sch

## KiCad design kicad/hastadaq/hastadaq.kicad_sch (2026-10-28)

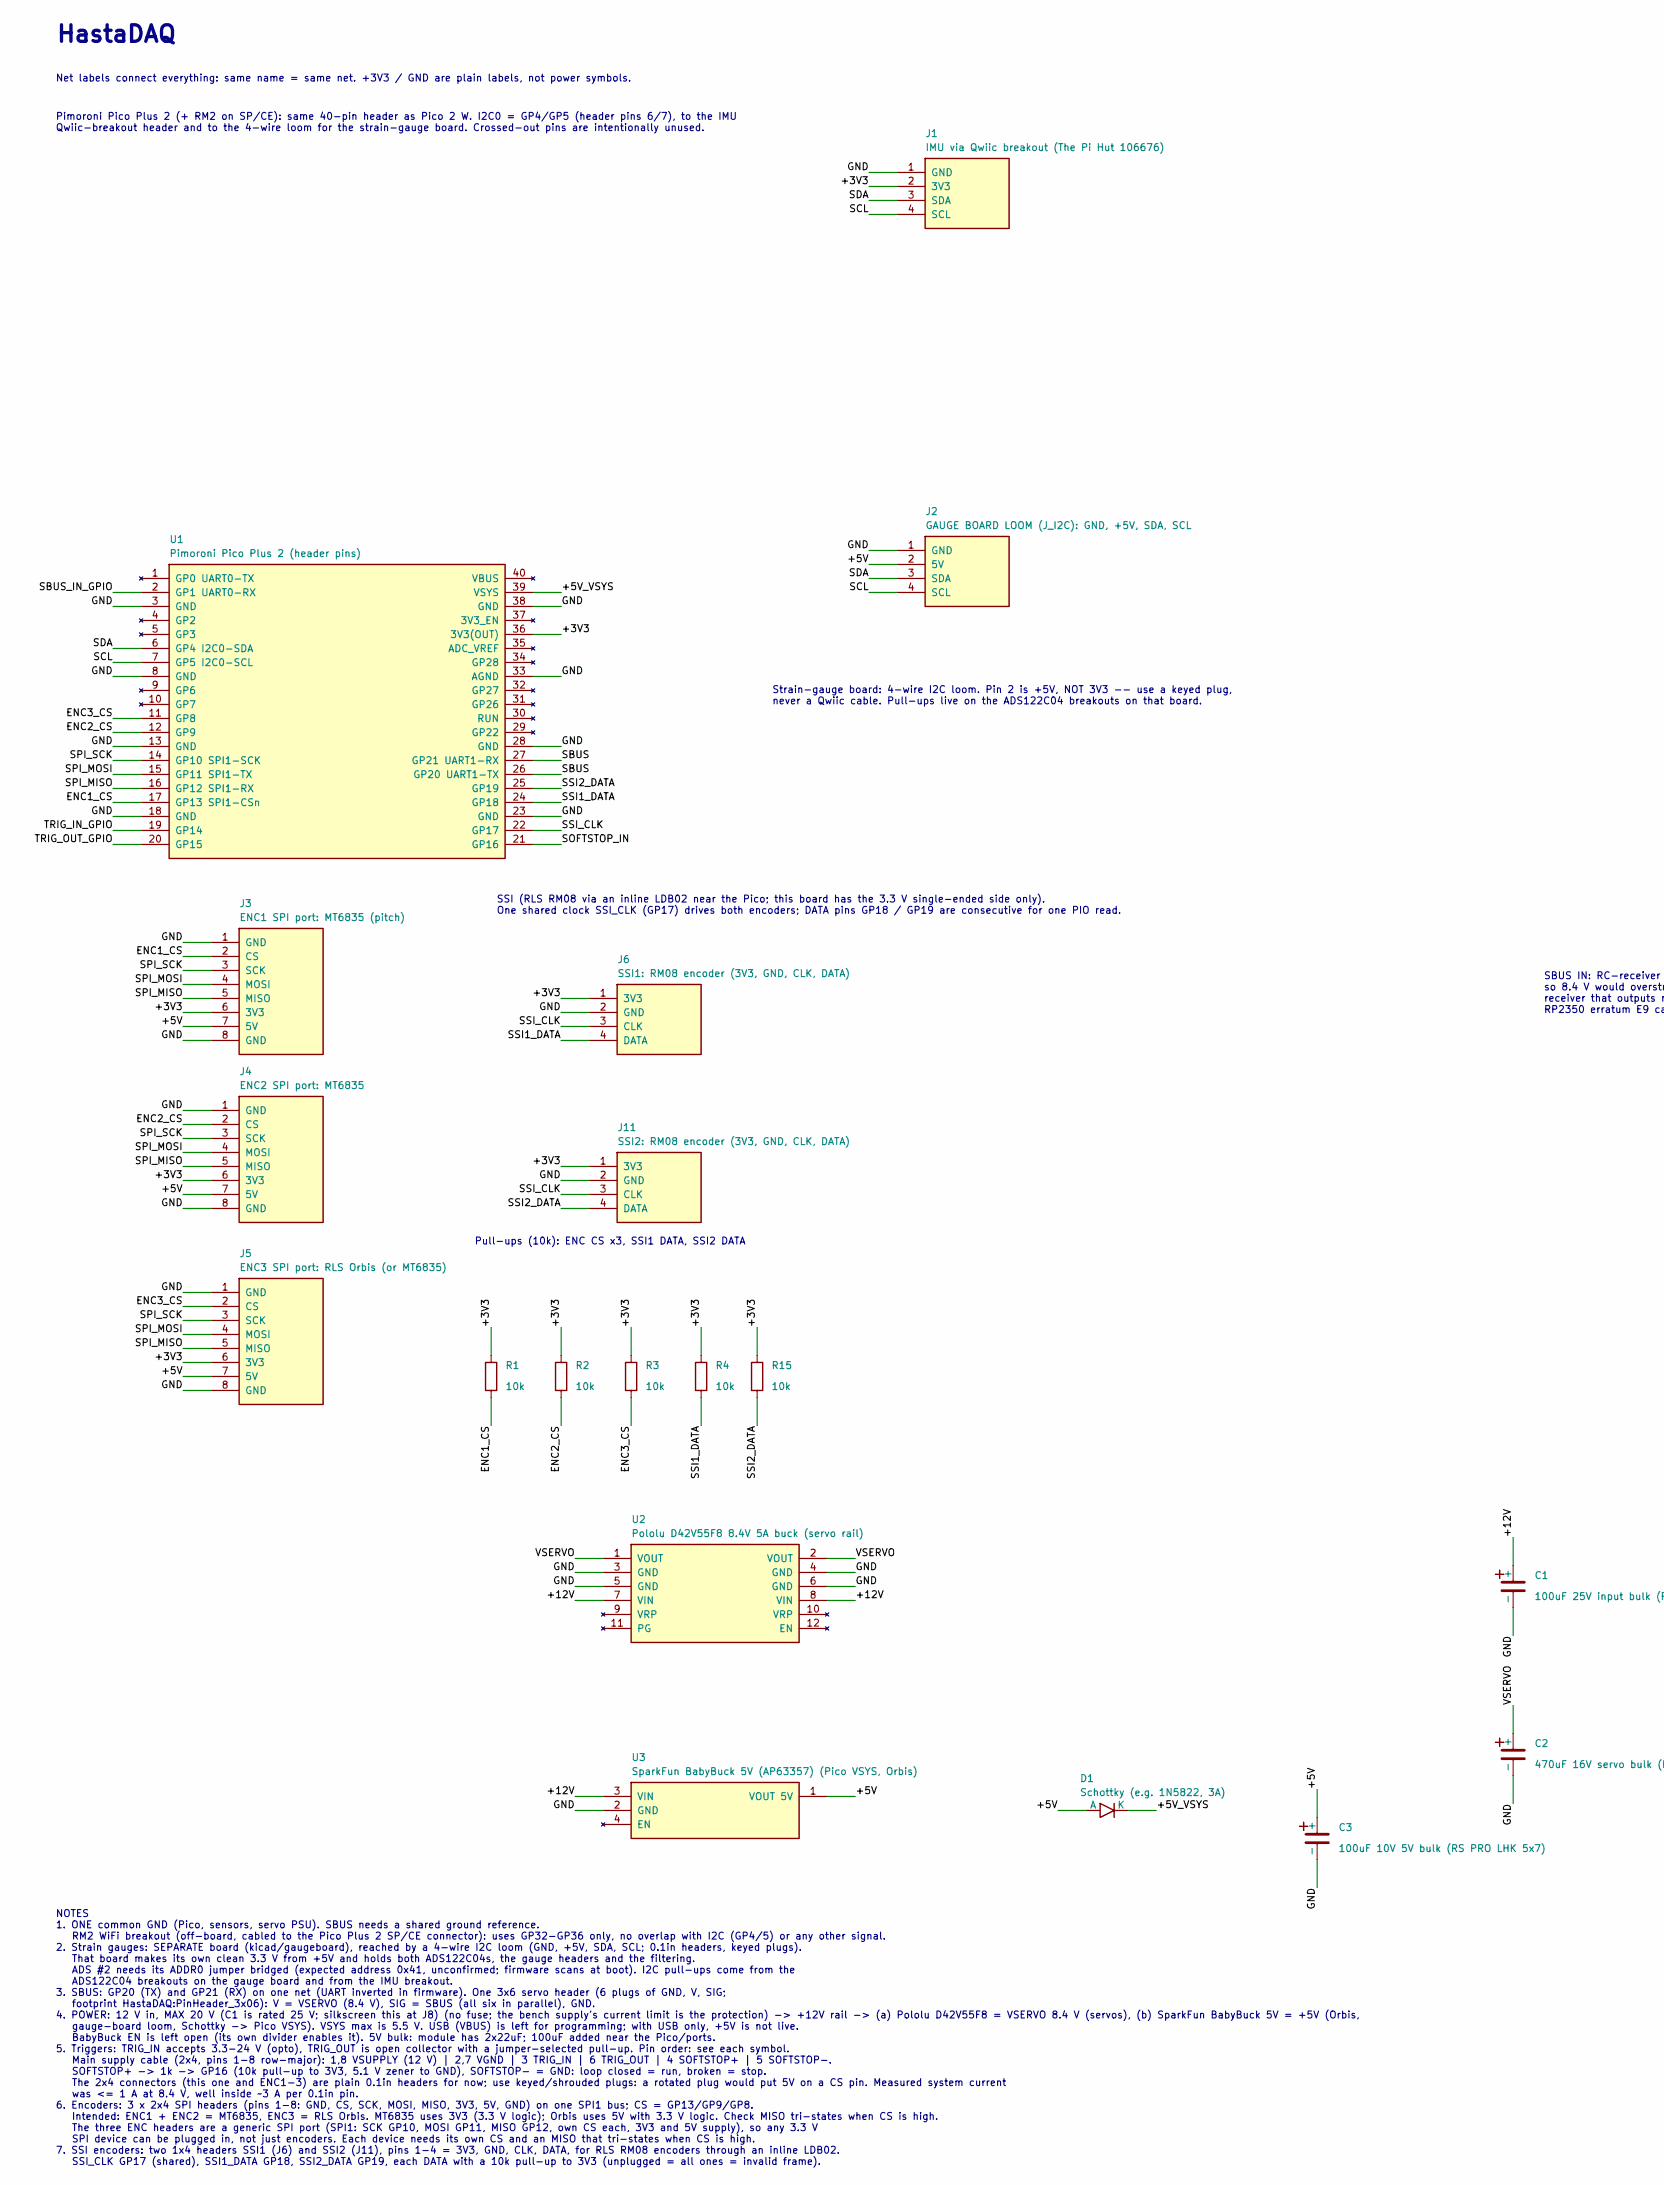
[picture p14: schematic hastadaq.kicad_sch, part in row 1, column 1]

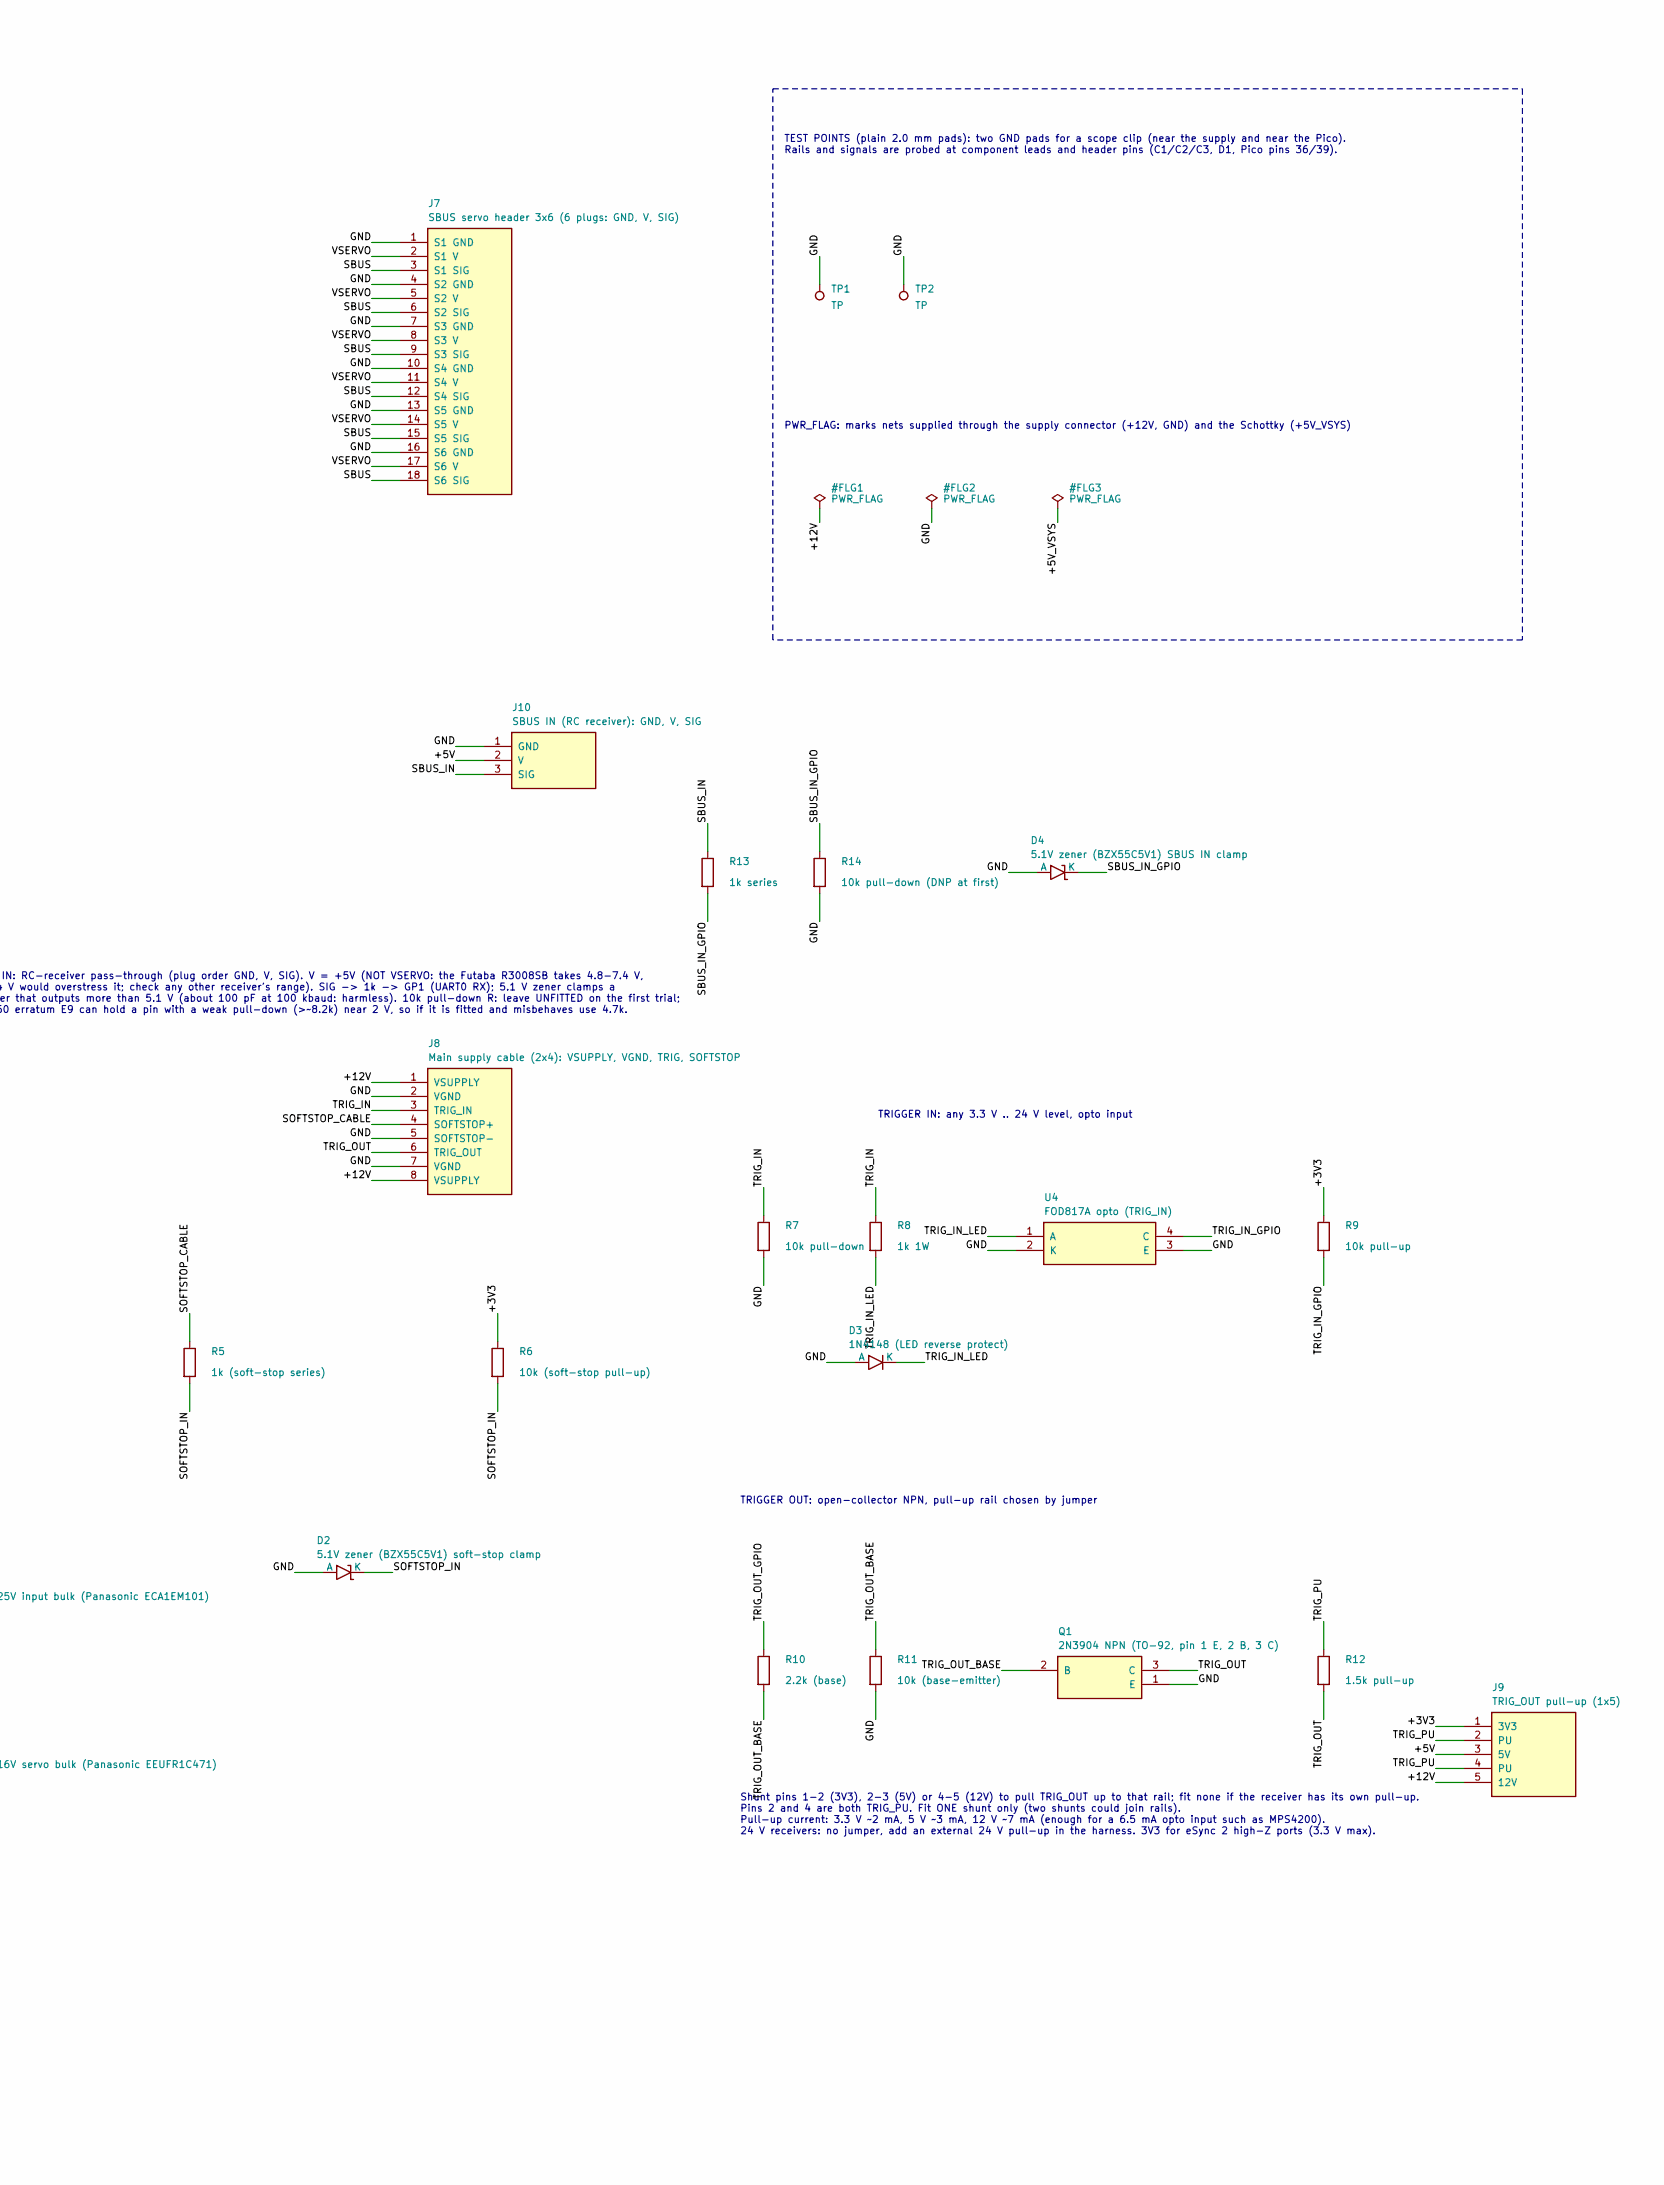
[picture p15: schematic hastadaq.kicad_sch, part in row 1, column 2]

Parts:
C1: 100uF 25V input bulk (Panasonic ECA1EM101); CP_Radial_D6.3mm_P2.50mm
C2: 470uF 16V servo bulk (Panasonic EEUFR1C471); CP_Radial_D8.0mm_P3.50mm
C3: 100uF 10V 5V bulk (RS PRO LHK 5x7); CP_Radial_D5.0mm_P2.00mm
D1: Schottky (e.g. 1N5822, 3A); D_DO-201AD_P15.24mm_Horizontal
D2: 5.1V zener (BZX55C5V1) soft-stop clamp; D_DO-35_SOD27_P7.62mm_Horizontal
D3: 1N4148 (LED reverse protect); D_DO-35_SOD27_P7.62mm_Horizontal
D4: 5.1V zener (BZX55C5V1) SBUS IN clamp; D_DO-35_SOD27_P7.62mm_Horizontal
J1: IMU via Qwiic breakout (The Pi Hut 106676); PinHeader_1x04_P2.54mm_Vertical
J2: GAUGE BOARD LOOM (J_I2C): GND, +5V, SDA, SCL; PinHeader_1x04_P2.54mm_Vertical
J3: ENC1 SPI port: MT6835 (pitch); PinHeader_2x04_P2.54mm_Vertical
J4: ENC2 SPI port: MT6835; PinHeader_2x04_P2.54mm_Vertical
J5: ENC3 SPI port: RLS Orbis (or MT6835); PinHeader_2x04_P2.54mm_Vertical
J6: SSI1: RM08 encoder (3V3, GND, CLK, DATA); PinHeader_1x04_P2.54mm_Vertical
J7: SBUS servo header 3x6 (6 plugs: GND, V, SIG); PinHeader_3x06_P2.54mm_Vertical
J8: Main supply cable (2x4): VSUPPLY, VGND, TRIG, SOF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; PinHeader_2x04_P2.54mm_Vertical
J9: TRIG_OUT pull-up (1x5); PinHeader_1x05_P2.54mm_Vertical
J10: SBUS IN (RC receiver): GND, V, SIG; PinHeader_1x03_P2.54mm_Vertical
J11: SSI2: RM08 encoder (3V3, GND, CLK, DATA); PinHeader_1x04_P2.54mm_Vertical
Q1: 2N3904 NPN (TO-92, pin 1 E, 2 B, 3 C); TO-92_Inline
R1, R2, R3, R4, R15: 10k; R_Axial_DIN0207_L6.3mm_D2.5mm_P7.62mm_Horizontal
R5: 1k (soft-stop series); R_Axial_DIN0207_L6.3mm_D2.5mm_P7.62mm_Horizontal
R6: 10k (soft-stop pull-up); R_Axial_DIN0207_L6.3mm_D2.5mm_P7.62mm_Horizontal
R7: 10k pull-down; R_Axial_DIN0207_L6.3mm_D2.5mm_P7.62mm_Horizontal
R8: 1k 1W; R_Axial_DIN0411_L9.9mm_D3.6mm_P12.70mm_Horizontal
R9: 10k pull-up; R_Axial_DIN0207_L6.3mm_D2.5mm_P7.62mm_Horizontal
R10: 2.2k (base); R_Axial_DIN0207_L6.3mm_D2.5mm_P7.62mm_Horizontal
R11: 10k (base-emitter); R_Axial_DIN0207_L6.3mm_D2.5mm_P7.62mm_Horizontal
R12: 1.5k pull-up; R_Axial_DIN0207_L6.3mm_D2.5mm_P7.62mm_Horizontal
R13: 1k series; R_Axial_DIN0207_L6.3mm_D2.5mm_P7.62mm_Horizontal
R14: 10k pull-down (DNP at first); R_Axial_DIN0207_L6.3mm_D2.5mm_P7.62mm_Horizontal
TP1, TP2: TP; TestPoint_Pad_D2.0mm
U1: Pimoroni Pico Plus 2 (header pins); RaspberryPi_Pico_Common_THT
U2: Pololu D42V55F8 8.4V 5A buck (servo rail); Pololu_D42V55Fx
U3: SparkFun BabyBuck 5V (AP63357) (Pico VSYS, Orbis); SparkFun_BabyBuck_5V
U4: FOD817A opto (TRIG_IN); DIP-4_W7.62mm

Connections:
+3V3: J1.2 (3V3), J3.6 (3V3), J4.6 (3V3), J5.6 (3V3), J6.1 (3V3), J9.1 (3V3), J11.1 (3V3), R1.1, R2.1, R3.1, R4.1, R6.1, R9.1, R15.1, U1.36 (3V3(OUT))
+5V: C3.1 (+), D1.2 (A), J2.2 (5V), J3.7 (5V), J4.7 (5V), J5.7 (5V), J9.3 (5V), J10.2 (V), U3.1 (VOUT 5V)
+5V_VSYS: D1.1 (K), U1.39 (VSYS)
+12V: C1.1 (+), J8.1 (VSUPPLY), J8.8 (VSUPPLY), J9.5 (12V), U2.7 (VIN), U2.8 (VIN), U3.3 (VIN)
ENC1_CS: J3.2 (CS), R1.2, U1.17 (GP13 SPI1-CSn)
ENC2_CS: J4.2 (CS), R2.2, U1.12 (GP9)
ENC3_CS: J5.2 (CS), R3.2, U1.11 (GP8)
GND: C1.2 (-), C2.2 (-), C3.2 (-), D2.2 (A), D3.2 (A), D4.2 (A), J1.1 (GND), J2.1 (GND), J3.1 (GND), J3.8 (GND), J4.1 (GND), J4.8 (GND), J5.1 (GND), J5.8 (GND), J6.2 (GND), J7.1 (S1 GND), J7.4 (S2 GND), J7.7 (S3 GND), J7.10 (S4 GND), J7.13 (S5 GND), J7.16 (S6 GND), J8.2 (VGND), J8.5 (SOFTSTOP-), J8.7 (VGND), J10.1 (GND), J11.2 (GND), Q1.1 (E), R7.2, R11.2, R14.2, TP1.1, TP2.1, U1.3 (GND), U1.8 (GND), U1.13 (GND), U1.18 (GND), U1.23 (GND), U1.28 (GND), U1.33 (AGND), U1.38 (GND), U2.3 (GND), U2.4 (GND), U2.5 (GND), U2.6 (GND), U3.2 (GND), U4.2 (K), U4.3 (E)
SBUS: J7.3 (S1 SIG), J7.6 (S2 SIG), J7.9 (S3 SIG), J7.12 (S4 SIG), J7.15 (S5 SIG), J7.18 (S6 SIG), U1.26 (GP20 UART1-TX), U1.27 (GP21 UART1-RX)
SBUS_IN: J10.3 (SIG), R13.1
SBUS_IN_GPIO: D4.1 (K), R13.2, R14.1, U1.2 (GP1 UART0-RX)
SCL: J1.4 (SCL), J2.4 (SCL), U1.7 (GP5 I2C0-SCL)
SDA: J1.3 (SDA), J2.3 (SDA), U1.6 (GP4 I2C0-SDA)
SOFTSTOP_CABLE: J8.4 (SOFTSTOP+), R5.1
SOFTSTOP_IN: D2.1 (K), R5.2, R6.2, U1.21 (GP16)
SPI_MISO: J3.5 (MISO), J4.5 (MISO), J5.5 (MISO), U1.16 (GP12 SPI1-RX)
SPI_MOSI: J3.4 (MOSI), J4.4 (MOSI), J5.4 (MOSI), U1.15 (GP11 SPI1-TX)
SPI_SCK: J3.3 (SCK), J4.3 (SCK), J5.3 (SCK), U1.14 (GP10 SPI1-SCK)
SSI1_DATA: J6.4 (DATA), R4.2, U1.24 (GP18)
SSI2_DATA: J11.4 (DATA), R15.2, U1.25 (GP19)
SSI_CLK: J6.3 (CLK), J11.3 (CLK), U1.22 (GP17)
TRIG_IN: J8.3 (TRIG_IN), R7.1, R8.1
TRIG_IN_GPIO: R9.2, U1.19 (GP14), U4.4 (C)
TRIG_IN_LED: D3.1 (K), R8.2, U4.1 (A)
TRIG_OUT: J8.6 (TRIG_OUT), Q1.3 (C), R12.2
TRIG_OUT_BASE: Q1.2 (B), R10.2, R11.1
TRIG_OUT_GPIO: R10.1, U1.20 (GP15)
TRIG_PU: J9.2 (PU), J9.4 (PU), R12.1
VSERVO: C2.1 (+), J7.2 (S1 V), J7.5 (S2 V), J7.8 (S3 V), J7.11 (S4 V), J7.14 (S5 V), J7.17 (S6 V), U2.1 (VOUT), U2.2 (VOUT)

Notes on the sheet:
Strain-gauge board: 4-wire I2C loom. Pin 2 is +5V, NOT 3V3 -- use a keyed plug, never a Qwiic cable. Pull-ups live on the ADS122C04 breakouts on that board.
Pull-ups (10k): ENC CS x3, SSI1 DATA, SSI2 DATA
TRIGGER IN: any 3.3 V .. 24 V level, opto input
TRIGGER OUT: open-collector NPN, pull-up rail chosen by jumper
Shunt pins 1-2 (3V3), 2-3 (5V) or 4-5 (12V) to pull TRIG_OUT up to that rail; fit none if the receiver has its own pull-up. Pins 2 and 4 are both TRIG_PU. Fit ONE shunt only (two shunts could join rails). Pull-up current: 3.3 V ~2 mA, 5 V ~3 mA, 12 V ~7 mA (enough for a 6.5 mA opto input such as MP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
SBUS IN: RC-receiver pass-through (plug order GND, V, SIG). V = +5V (NOT VSERVO: the Futaba R3008SB takes 4.8-7.4 V, so 8.4 V would overstress it; check any other receiver's range). SIG -> 1k -> GP1 (UART0 RX); 5.1 V zener clamps a receiver that outputs more than 5.1 V (about 100 pF at 100 kbaud: h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
SSI (RLS RM08 via an inline LDB02 near the Pico; this board has the 3.3 V single-ended side only). One shared clock SSI_CLK (GP17) drives both encoders; DATA pins GP18 / GP19 are consecutive for one PIO read.
TEST POINTS (plain 2.0 mm pads): two GND pads for a scope clip (near the supply and near the Pico). Rails and signals are probed at component leads and header pins (C1/C2/C3, D1, Pico pins 36/39).
PWR_FLAG: marks nets supplied through the supply connector (+12V, GND) and the Schottky (+5V_VSYS)
HastaDAQ
Net labels connect everything: same name = same net. +3V3 / GND are plain labels, not power symbols.
Pimoroni Pico Plus 2 (+ RM2 on SP/CE): same 40-pin header as Pico 2 W. I2C0 = GP4/GP5 (header pins 6/7), to the IMU Qwiic-breakout header and to the 4-wire loom for the strain-gauge board. Crossed-out pins are intentionally unused.
NOTES 1. ONE common GND (Pico, sensors, servo PSU). SBUS needs a shared ground reference. RM2 WiFi breakout (off-board, cabled to the Pico Plus 2 SP/CE connector): uses GP32-GP36 only, no overlap with I2C (GP4/5) or any other signal. 2. Strain gauges: SEPARATE board (kicad/gaugeboard), reached by a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
