fh9g12/HastaArduino/HastaDrivers/src/HastaDrivers.h

/*
 Name:		HastaDrivers.h
 Created:	9/5/2026 10:14:20 PM
 Author:	finta
 Editor:	http://www.visualmicro.com
*/

#ifndef _HastaDrivers_h
#define _HastaDrivers_h

#if defined(ARDUINO) && ARDUINO >= 100
	#include "arduino.h"
#else
	#include "WProgram.h"
#endif


#endif
