fh9g12/HastaArduino/HastaDrivers/src/ExcitationGenerator.h

#pragma once
#include <Arduino.h>
#include <math.h>
#include "LinearChirp.h"
#include "OneMinusCosine.h"
#include "TurbulenceProfile.h"

// Shared waveform generator for a rig's excitation signal -- sine / 1-cosine
// doublet / chirp, with an optional cycle count (auto-stop) and an
// optional START DELAY (delayS).
//
// Deliberately splits "configured to run" into two separate concepts,
// not one enabled flag, because a single flag can't express "wait for a
// trigger, then start N seconds later":
//   - armed (sticky, user-set): "the next trigger event should start
//     this". Set via setArmed() -- stays armed across multiple triggers
//     until explicitly changed, same as a capture's durationS/sampleHz
//     persist across multiple ARM/FIRE cycles.
//   - active (transient, auto-managed): "is this waveform CURRENTLY
//     producing nonzero output right now". Set true by triggerStart()
//     (only if armed), cleared automatically once cycles() periods have
//     elapsed (or never, if cycles()==0 -- runs until the next trigger
//     re-syncs it or setArmed(false) disarms it).
//
// So the workflow this enables: setArmed(true) + configure params once;
// every subsequent trigger (external pin, SCPI FIRE, RUN's internal
// fire) calls triggerStart(now), which waits delayS seconds then begins
// oscillating -- exactly "wait for a trigger, start N seconds later".
class ExcitationGenerator {
public:
    // SINE, COSINE (the 1-cosine pulse: a smooth bump from 0 up to
    // amplitudeDeg and back over periodS), CHIRP, and STEP: 0 until the start
    // delay has elapsed, then amplitudeDeg held until disarmed. A step has no
    // period or cycle count (periodS and cycles are ignored), so a step test
    // is "arm, trigger, the step happens delayS later" with the step timed
    // here on the board rather than by a command from the host.
    //
    // RANDOM plays back a slice of the stored von Karman turbulence record
    // (TurbulenceProfile.h, generated by matlab/hastadaq/tools/
    // exportTurbulenceProfile.m): durationS seconds starting startOffsetS into
    // the record, scaled by amplitudeDeg, windowed with a quintic taper over
    // the first and last 10% so it starts and ends smoothly at 0. Different
    // start offsets are different gusts. Stops by itself after durationS.
    //
    // STEPSEQ is a stepped square wave with dwell times that shrink: the
    // output is -amplitudeDeg from the trigger until delayS has elapsed (the
    // "move there and settle" phase), then +amplitudeDeg for dwells[0]*periodS,
    // -amplitudeDeg for dwells[1]*periodS, and so on alternating, then 0 and
    // it stops. With dwells {3,2,1,1} that is the stepped chirp: delta = 2 *
    // amplitudeDeg, deltaT = periodS.
    enum class Type : uint8_t { SINE = 0, COSINE = 1, CHIRP = 2, STEP = 3, RANDOM = 4, STEPSEQ = 5 };

    static constexpr int MAX_DWELLS = 16;

    void setType(Type type) { _type = type; }
    Type type() const { return _type; }
    const char* typeName() const {
        switch (_type) {
            case Type::COSINE: return "cosine";
            case Type::CHIRP:  return "chirp";
            case Type::STEP:   return "step";
            case Type::RANDOM: return "random";
            case Type::STEPSEQ: return "stepseq";
            case Type::SINE:
            default:           return "sine";
        }
    }

    void setFreqHz(float freqHz) { _freqHz = freqHz; }       // SINE
    float freqHz() const { return _freqHz; }
    void setChirpRange(float f0, float f1) { _f0 = f0; _f1 = f1; } // CHIRP
    float f0() const { return _f0; }
    float f1() const { return _f1; }
    void setPeriodS(float periodS) { _periodS = periodS; }   // COSINE, CHIRP
    float periodS() const { return _periodS; }
    void setAmplitudeDeg(float amplitudeDeg) { _amplitudeDeg = amplitudeDeg; }
    float amplitudeDeg() const { return _amplitudeDeg; }
    void setCycles(float cycles) { _cycles = cycles; }        // 0 = run until the next trigger/disarm
    float cycles() const { return _cycles; }
    void setDelayS(float delayS) { _delayS = delayS; }
    float delayS() const { return _delayS; }
    void setStartOffsetS(float s) { _startOffsetS = s; }      // RANDOM: where in the record to start
    float startOffsetS() const { return _startOffsetS; }
    void setDurationS(float s) { _durationS = s; }            // RANDOM: how long the gust lasts
    float durationS() const { return _durationS; }
    // STEPSEQ: the dwell multiples (of periodS), at most MAX_DWELLS.
    void setDwells(const float* dwells, int n) {
        _nDwells = (n < 0) ? 0 : (n > MAX_DWELLS ? MAX_DWELLS : n);
        for (int i = 0; i < _nDwells; ++i) _dwells[i] = dwells[i];
    }
    int nDwells() const { return _nDwells; }
    float dwell(int i) const { return _dwells[i]; }

    // True if the RANDOM settings fit inside the stored record.
    static bool randomFits(float startOffsetS, float durationS) {
        return startOffsetS >= 0.0f && durationS > 0.0f
            && startOffsetS + durationS <= TurbulenceProfile::kDurationS;
    }

    void setArmed(bool armed) { _armed = armed; if (!armed) _active = false; }
    bool armed() const { return _armed; }
    bool active() const { return _active; }

    // Called by the trigger pathway (see HastaDAQ.ino's doTrigger()) --
    // no-op if not armed. If armed, (re)starts the waveform referenced
    // to nowUs: outputs 0 for the first delayS() seconds, then begins.
    void triggerStart(uint32_t nowUs) {
        if (!_armed) { _active = false; return; }
        _active = true;
        _startUs = nowUs + (uint32_t)(_delayS * 1000000.0f);
    }

    // Call every loop iteration -- returns the current commanded degrees
    // (0 if not active, or still within the start delay).
    float update(uint32_t nowUs) {
        if (!_active) return 0.0f;
        if (nowUs < _startUs) {
            // still waiting out the start delay: 0, except the stepped sequence,
            // whose delay is the "move to the first level and settle" phase
            return (_type == Type::STEPSEQ) ? -_amplitudeDeg : 0.0f;
        }

        // A step has no period or cycle count: it holds its amplitude from the
        // start delay until setArmed(false), so it must not fall through to
        // the cycle-count auto-stop below.
        if (_type == Type::STEP) return _amplitudeDeg;

        float tS = (nowUs - _startUs) / 1000000.0f;

        if (_type == Type::STEPSEQ) {
            float edgeS = 0.0f;
            for (int i = 0; i < _nDwells; ++i) {
                edgeS += _dwells[i] * _periodS;
                if (tS < edgeS) return (i % 2 == 0) ? _amplitudeDeg : -_amplitudeDeg;
            }
            _active = false; // sequence over: back to the trim
            return 0.0f;
        }

        if (_type == Type::RANDOM) {
            if (tS >= _durationS || !randomFits(_startOffsetS, _durationS)) {
                _active = false;
                return 0.0f;
            }
            float pos = (_startOffsetS + tS) * TurbulenceProfile::kRateHz;
            int i0 = (int)pos;
            if (i0 > TurbulenceProfile::kSamples - 2) i0 = TurbulenceProfile::kSamples - 2;
            float frac = pos - (float)i0;
            float a = TurbulenceProfile::kPosition[i0];
            float b = TurbulenceProfile::kPosition[i0 + 1];
            return _amplitudeDeg * (a + (b - a) * frac) * taper(tS, _durationS);
        }
        float periodS;
        float value;
        switch (_type) {
            case Type::COSINE: {
                periodS = _periodS;
                OneMinusCosine wave(periodS, 0.0f, _amplitudeDeg);
                value = wave.deg(fmodf(tS, periodS));
                break;
            }
            case Type::CHIRP: {
                periodS = _periodS;
                LinearChirp wave(_f0, _f1, periodS, 0.0f, _amplitudeDeg);
                value = wave.deg(fmodf(tS, periodS));
                break;
            }
            case Type::SINE:
            default: {
                periodS = 1.0f / _freqHz;
                LinearChirp wave(_freqHz, _freqHz, periodS, 0.0f, _amplitudeDeg);
                value = wave.deg(fmodf(tS, periodS));
                break;
            }
        }

        if (_cycles > 0.0f && tS >= periodS * _cycles) {
            _active = false; // auto-stop once the configured cycle count elapses
            return 0.0f;
        }
        return value;
    }

private:
    // Quintic window 0 -> 1 -> 0 over the first/last 10% of durationS: value and
    // first two derivatives are zero at both ends (s(p) = 10p^3 - 15p^4 + 6p^5).
    static float taper(float tS, float durationS) {
        float ramp = 0.1f * durationS;
        float p = 1.0f;
        if (tS < ramp) p = tS / ramp;
        else if (tS > durationS - ramp) p = (durationS - tS) / ramp;
        if (p >= 1.0f) return 1.0f;
        if (p <= 0.0f) return 0.0f;
        return p * p * p * (10.0f - 15.0f * p + 6.0f * p * p);
    }

    Type _type = Type::SINE;
    float _freqHz = 1.0f;
    float _f0 = 1.0f, _f1 = 1.0f;
    float _periodS = 1.0f;
    float _amplitudeDeg = 5.0f;
    float _cycles = 1.0f;
    float _delayS = 0.0f;
    float _startOffsetS = 0.0f;
    float _durationS = 10.0f;
    float _dwells[MAX_DWELLS] = {3.0f, 2.0f, 1.0f, 1.0f};
    int _nDwells = 4;
    bool _armed = false;
    bool _active = false;
    uint32_t _startUs = 0;
};
