fh9g12/HastaArduino/(commit log)

2026-09-27 Add SBUS/encoder/strain-gauge rigs, shared drivers, MATLAB tooling, and wiring diagrams
    Checkpoint before removing superseded PWM/prototype projects: adds
    EncoderCalibration, SbusServoCalibration, StrainGaugeCalibration (+
    bringup sketches), the drivers backing them (Mt6835Encoder, StepperDriver,
    SbusServo, SweepWave), matlab/ test+analysis scripts, WireViz wiring
    diagrams, and a repo README for future agents.
2026-09-27 Remove legacy PWM/prototype projects now that SBUS/encoder/strain-gauge rigs are established
    Servo actuation is SBUS-only going forward, so the PWM path
    (ServoCalibration + its ServoBank driver + matlab/pwm) is redundant.
    Also removes the early prototypes/bringup sketches these rigs
    superseded: HastaDAQ (dead stub), Servoscpi (superseded 6-servo SCPI
    controller), ServoTest, WifiTest, EncoderBringup, GpioInvertBringup,
    StrainGaugeBringup. Updates the solution file, HastaDrivers shared-items
    project, and README to match.
2026-10-12 HastaDAQ: MATLAB client, centred servo angles, ENCODER?/ZERO, channel order
    - Add HastaDaqClient/HastaDaqChannel MATLAB classes and five example scripts
    - Add ENCODER? and ZERO SCPI commands (ZERO refused while PID is enabled)
    - Servo angles now centred on 0 (+/-90) instead of 90; offset applied only
    at the SbusServoBank boundary in ChannelMixer
    - Reorder CHANNEL_DEFS to the real SBUS order (rudder, elev R/L, ail R/L)
    - Cast edge mode to PinStatus in TriggerIO for the rp2040 6.1.0 core
2026-10-13 SBUS servo calibration to CIU-3 end-points, setAngle(), rename HDCh
    - SbusServoBank: map degrees centred on 0 to SBUS counts using the servos'
    programmed 920/1520/2120 us (+/-48.06 deg) = 64/1024/1984 counts
    (Futaba 0.625 us/count). chMin/chMax become a clamp on raw counts;
    logged servoDeg now reports the clamped angle actually sent
    - ChannelMixer: drop the temporary 90 deg offset, SbusServoBank is centred
    - CHANCONFIG rejects chMax <= chMin
    - MATLAB: add HastaDaqClient.setAngle(surface, angle), MaxAngleDeg
    - MATLAB: rename HastaDaqChannel enum to HDCh and update examples
2026-10-13 HastaDAQ: data classes, test scripts, synchronised moves, power connector
    Firmware
    - CHANCONFIG accepts an array of channels, validated then applied together
    so several surfaces move in the same SBUS frame (single object still works)
    MATLAB
    - HastaDaqData: readData() returns an object with a property per servo
    angle (RUDDER_Angle, ...), Time/ServoAngles, ToTable/ToStruct, mean()
    - MetaData / ModelConfig for per-test-point context (run/test number, test
    type, model config, ZeroRun, free-form Parameters)
    - runNumber.txt helpers (getRunNumber/incrementRunNumber) and getLastZeroRun
    - scripts.AoASweep and scripts.ZeroRun collect hdData/ohbData/meta arrays
    per test point and save them; re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
2026-10-14 HastaDAQ: step/cosine excitation, wt.hasta package, PXI force sensor, free-pitch tests
    - Firmware: armed "step" excitation type (typeName reporting), ENCODER?/ZERO/ZEROOFFSET,
    SYS?, array CHANCONFIG, connection handling
    - MATLAB: client/data classes moved into wt.hasta, wt.runNum and encoderZero as
    preferences, retries and health diagnostics
    - Tunnel scripts: ZeroEncoderRun, FreePitchSine/Chirp/Cosine/Step with optional
    PXI force sensor (wt.pxi: ForceDaq, ForceData, loadCalibration)
    - Examples: free-pitch sine/chirp/step/cosine demos on the Hasta DAQ alone
    - Docs: consolidated docs/README.md and matlab/hastadaq/docs/README.md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
2026-10-14 docs: PXI trigger is 3.3 V analogue out, no divider needed
2026-10-15 Optional PXI force sensor in ZeroRun, sweeps and all recording examples
    wt.pxi.connect/record/plotForces helpers; ZeroRun stores the mean gauge
    voltages (the tare); steady points keep the trigger-window mean in pxiData.
    Examples get USE_PXI (default false).
2026-10-15 Add testPxi example: PXI card, trigger loopback and board-start check
2026-10-15 Examples: default board IP matches the tunnel network (192.168.1.107)
2026-10-15 Camera option (UseCamera / USE_CAMERA) in every recording script and example
2026-10-15 Test-point framework, random and stepped-chirp excitations, PerVelocityRun
    - wt.hasta.testtype: heterogeneous test points (Steady, Datum, Zero, Sine,
    Cosine, Chirp, Random, SteppedChirp, Step) run by wt.hasta.runTests via a
    TestSession; datums taken per condition (retaken after 60 s), OHB sampled
    only for steady-type points
    - wt.hasta.setupTestEnvironment and ControlSettings; scripts and examples
    rewritten on them; old per-test scripts replaced by thin versions
    - Firmware: "random" (stored von Karman record, TurbulenceProfile.h, generated
    by tools/exportTurbulenceProfile.m) and "stepseq" excitation types
    - scripts.PerVelocityRun and FreePitchMixed
    - Docs updated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
2026-10-23 Schematic rev A: encoders, supply cable, buck modules, trigger I/O
    - Four generic 2x4 SPI/encoder headers (CS GP13/9/8/7, pull-ups)
    - ADC I2C hard-wired, input filter removed, one shared completion pair
    - Single 3x6 SBUS header with a custom HastaDAQ.pretty footprint
    - 12 V main supply cable (2x4) with soft-stop loop on GP16
    - Pololu D42V55F8 (8.4 V) and SparkFun BabyBuck 5V replace the UBEC
    - Opto TRIG_IN and open-drain TRIG_OUT with 3V3/5V/12V pull-up jumper
    - IMU via Qwiic-breakout header; RM2 blocks removed (off-board)
    - Through-hole footprints throughout; sheet moved to A2
    - Docs updated; PDF/PNG re-exported
2026-10-23 Schematic: footprints, pin types, protection and test points; module footprints
    Assign real footprints (Pico, ADS122C04, Pololu, BabyBuck, Qwiic socket with 3D
    model, keyed IDC headers), set electrical pin types with PWR_FLAGs (ERC 0),
    servo header GND/V/SIG, soft-stop zener, 5V bulk cap, BabyBuck EN left open,
    fuse value, two GND test points. Add generate_module_footprints.py.
2026-10-23 Add HastaDAQ_v2 firmware for the REV A board
    Separate project (original HastaDAQ untouched): four SPI encoder ports
    (MT6835 / RLS Orbis) on a shared bus, soft stop on GP16, inverted opto/NPN
    trigger paths, ABORT/ENCODERS?/ENCCONFIG commands, three extra encoder floats
    in the sample, optional Pico 2 W build. Drivers extended backward-compatibly
    (OrbisEncoder, SoftStop, TriggerIO inversion, Mt6835Encoder shared bus).
    DaqData.FromBytes accepts both sample layouts. Compiles for both boards;
    not yet run on hardware.
2026-10-23 Docs: PCB design brief, v2 firmware, fuse and layout guidance
2026-10-25 Split strain-gauge hardware onto its own board; SBUS IN header; gauge loom diagram
    - kicad/gaugeboard: new schematic with 2x ADS122C04, half-bridge headers, shared
    350R completion pair, optional input filter and its own LP2950-N 3.3 V LDO,
    fed from 5 V over a 4-wire I2C loom (GND, +5V, SDA, SCL)
    - Main board: strain-gauge circuitry replaced by the 1x4 loom header (J2);
    SBUS_IN 3-pin header on GP1; refs renumbered
    - Shared generator helpers in kicad/tools/schgen_common.py; new generate_gauge_sch.py
    - Docs: PCB_BRIEF.md rewritten for the main board, new PCB_BRIEF_GAUGE.md, README updated
    - wiring/gauge-loom.yml: WireViz diagram of the loom
    - HastaDAQ_v2 comments updated for the two-board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
2026-10-25 Gauge board: add pass-through loom output header (J2)
    Second 1x4 header wired in parallel with the loom input (GND, +5V, SDA, SCL)
    so another I2C board can be daisy-chained. Gauge headers renumbered J3/J4;
    docs updated.
2026-10-26 Schematics: fuse removed, plain headers, real parts chosen; gauge board LDO/caps; hand-off docs
    - Main board: no fuse (+12V straight from the supply connector), every connector a
    plain 0.1 in header, plain test pads, FOD817A opto, chosen capacitor footprints
    - Gauge board: MCP1700-3302E/TO LDO (pin 1 GND, 2 VIN, 3 VOUT), tantalum output cap,
    Vishay K-series 100 nF with 2.5 mm pitch, DNP flags on the filter caps, test points,
    pass-through loom header, redundant ADC decoupling removed
    - Docs: PCB_BRIEF.md/PCB_BRIEF_GAUGE.md rewritten with a status and hand-off section,
    new PARTS_TO_SELECT.md (RS numbers, dimensions, open items), README updated,
    BabyBuck EN and ADS122C04 pull-up/addre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
2026-10-26 Schematics: shunt-safe J9, SBUS IN on +5V with zener, 20 V max note; publish tool
    - J9 TRIG_OUT pull-up select is now a 1x5 header (rails separated by PU pins) so a shunt cannot join two rails
    - SBUS IN is powered from +5V (Futaba R3008SB is 4.8-7.4 V) with a 5.1 V zener clamp (D4); R14 pull-down left unfitted first (RP2350 E9)
    - Supply maximum 20 V documented (C1 25 V rating); no TVS
    - Gauge brief: plug-order correction, stray L1 row removed
    - kicad/tools/publish.py snapshots both schematics into kicad/releases/<name>/ for PCB layout
    - PDFs/PNGs re-exported
2026-10-26 Publish schematic release rev-a for PCB layout
    Snapshot of both schematics (ERC clean) from commit eeeed2c; un-ignore kicad/releases.
2026-10-26 Docs: fab decided (PCBWay, 2 layers, 6/6 mil, 0.3 mm drill, no edge connectors)
2026-10-26 Docs: mounting and placement guidelines for both boards
2026-10-26 publish.py: START_HERE.md and wiring diagram in releases; single release rev-a
    Replaces the earlier rev-a snapshot with a fresh one (same schematic).
2026-10-27 Gauge board PCB laid out, routed and sent to PCBWay; layout scripts, docs and hand-off README
    - Gauge board: J3/J4 become 2x3 headers (V V / SIG SIG / GND GND) in generate_gauge_sch.py;
    republished release 20261026-2252-rev-a (replaces 20261026-1734-rev-a) with the laid-out
    gaugeboard.kicad_pcb and the PCBWay fab files (fab/gaugeboard_gerbers.zip).
    - kicad/tools/layout/: export_fab.py, tidy_silk.py, remove_pads.py, set_pcbway_rules.py plus
    board-specific placement/routing/length-check records for the gauge board, with a README.
    - kicad/README.md: workflow, tools, gotchas, status, as-built gauge board, next steps for the main board.
    - docs: PCB_BRIEF_GAUGE.md updated to the as-built lay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
2026-10-28 Main board: RM08 SSI encoders, SSI firmware driver, placed and routed PCB
    Schematic: two RLS RM08 SSI headers (J6, J11; shared clock GP17, data GP18/GP19),
    ENC4 SPI port removed, diode pin numbering fixed. Firmware: PIO SSI driver
    (Rm08Ssi), 84-byte sample with extra encoder channels, MATLAB DaqData update.
    PCB: release 20261027-2346-rev-a-ssi, hand placement by the owner, routed with
    the new grid router (route_main.py, grid_router.py): 2.0 mm VSERVO/+12V bars,
    GND pours, DRC clean apart from cosmetic silk warnings. Pololu mounting holes
    removed and Pico antenna keep-out trimmed 3 mm on this board only.
    Layout tools: grid_router, route_main, solid_gnd_pads, trim_fp_keepout,
    check_pad_nets,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
2026-10-28 Remove accidentally added KiCad .history gitlinks; ignore .history and lock files
2026-10-28 Main board: owner silkscreen edits, re-export fab files (Gerbers, drills, zip)
2026-10-28 Merge ordered boards into releases/rev-a; final main-board routing and fab files; firmware to-do list
    - kicad/releases/rev-a: ordered gauge board (with fab files) plus ordered main
    board (routed, serial-number text, fab files), docs, wiring; the two earlier
    release folders are removed (history keeps them).
    - Router: copper allowed in the SP/CE and plug-clearance rectangles, GND bus
    option, trimmed Pico antenna keep-out, solid_gnd_pads and trim_fp_keepout tools.
    - docs/FIRMWARE_OUTSTANDING.md records the open firmware tasks; READMEs updated.
2026-10-29 Add purchasing BOM workbook (docs/BOM_rev-a.xlsx) with purchase marks and RS numbers
    Excel BOM for both boards: one line per purchasable item, per-board quantities
    from the schematics, supplier part numbers, quantities bought and unit prices
    as entered by the owner. make_bom_xlsx.py regenerates a blank copy and refuses
    to overwrite this one without --force. PARTS_TO_SELECT.md points at the workbook.
